ImArchimedes/WilsonThrust510/Documentation/Other Helpful Docs/Doc Images/Print Orientation Thumbs/Box Bottom_Box Bottom.jpg

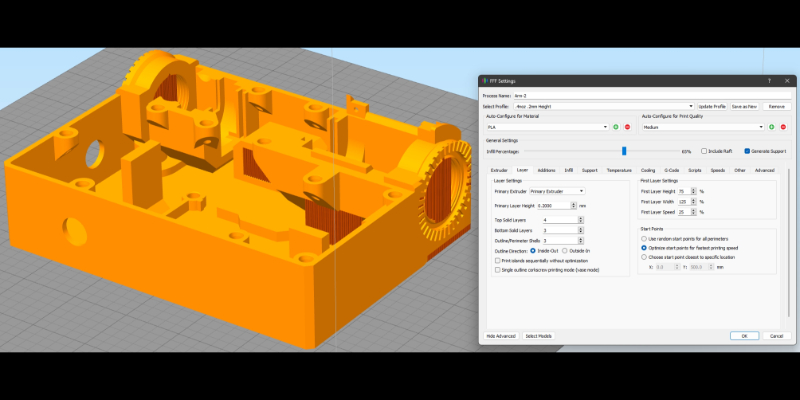
Documentation/Other Helpful Docs/Doc Images/Print Orientation Thumbs/Box Bottom_Box Bottom.jpg
