ImArchimedes/WilsonThrust510/Renders/144.35 Back.jpg

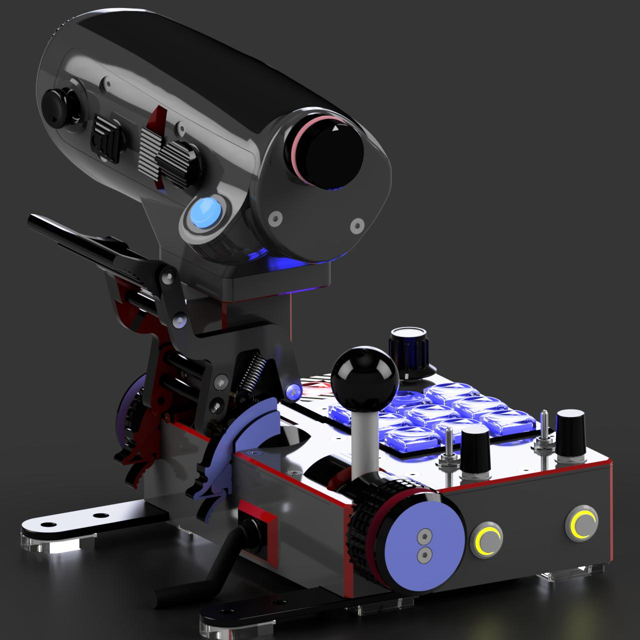
Renders/144.35 Back.jpg
