ImArchimedes/WilsonThrust510/README.md

# WilsonThrust510
DIY PC Flight Simulator Throttle.
