ImArchimedes/WilsonThrust510/Documentation/PCB Documentation/RKJXT1 Reddit Post.docx

# RKJXT1 - center click isolation fix

(continued)

Solution 2:

First off, before you look at my boards in Eagle, know that I went very small for both the RKJXT1 and RKJXM1 boards. My build required it but you do NOT need to go this small. To give you an idea of how small my RKJXT1 pcb with switch is, here are some renders with a quarter for scale…

RKJXT1 Top Side

RKJXT1 Underside

If you are okay with breaking out the poor man's reflow bed (your steam iron), go for it. If you're not okay with that, you can replace the tiny components with equivalent parts with a larger footprint and just spread everything out.

Both the RKJXT1 and RKJXM1 pcbs require the same parts Here is a list of the components need to make my exact PCB along with a link to where I purchased them and a count of how many are needed.

Parts list:
