ImArchimedes/WilsonThrust510/Documentation/Old Docs/BOM Old/Specifications Scratch Pad -2.xlsx

Sheet: Digikey
Category | Integrated Circuits (ICs) (https://www.digikey.com/en/products/category/integrated-circuits-ics/32) | Category: Integrated Circuits (ICs)
 | Logic - Shift Registers (https://www.digikey.com/en/products/filter/logic-shift-registers/712) | : Logic - Shift Registers
Mfr | Texas Instruments | Mfr: Texas Instruments
Series | 74HC (https://www.digikey.com/en/products/result) | Series: 74HC
Package | Tape & Reel (TR) | Package: Tape & Reel (TR)
 | Cut Tape (CT) | : Cut Tape (CT)
 | Digi-Reel® | : Digi-Reel®
Product Status | Active | Product Status: Active
Logic Type | Shift Register | Logic Type: Shift Register
Output Type | Complementary | Output Type: Complementary
Number of Elements | 1 | Number of Elements: 1
Number of Bits per Element | 8 | Number of Bits per Element: 8
Function | Parallel or Serial to Serial | Function: Parallel or Serial to Serial
Voltage - Supply | 2V ~ 6V | Voltage - Supply: 2V ~ 6V
Operating Temperature | -40°C ~ 125°C | Operating Temperature: -40°C ~ 125°C
Mounting Type | Surface Mount | Mounting Type: Surface Mount
Package / Case | 16-TSSOP (0.173", 4.40mm Width) | Package / Case: 16-TSSOP (0.173", 4.40mm Width)
Supplier Device Package | 16-TSSOP | Supplier Device Package: 16-TSSOP
Base Product Number | 74HC165 (https://www.digikey.com/en/products/base-product/texas-instruments/296/74HC165/16) | Base Product Number: 74HC165
Product Type: | FFC & FPC Connectors | Product Type:: FFC & FPC Connectors
Subcategory: | FFC & FPC Connectors | Subcategory:: FFC & FPC Connectors
Actuator Color | Black | Actuator Color: Black
Mating Cycles | 20 | Mating Cycles: 20
Base Product Number | FFC2A32 (https://www.digikey.com/en/products/base-product/gct/2073/FFC2A32/566035) | Base Product Number: FFC2A32

Sheet: Mouser
Manufacturer: | Molex | Manufacturer: Molex
Product Category: | FFC / FPC Jumper Cables | Product Category: FFC / FPC Jumper Cables
RoHS: | Details (https://www.mouser.com/Search/RoHSCompliant?qs=jvSarbJQcKuB88Iw%252B3zClA%3d%3d) | RoHS: Details
Number of Conductors: | 40 Conductor | Number of Conductors: 40 Conductor
Pitch: | 0.5 mm | Pitch: 0.5 mm
Cable Length: | 203 mm | Cable Length: 203 mm
Contact Location: | Same Side Contacts | Contact Location: Same Side Contacts
Current Rating: | 500 mA | Current Rating: 500 mA
Voltage Rating: | 600 VAC | Voltage Rating: 600 VAC
Series: | 15366 (https://www.mouser.com/c/wire-cable/ffc-fpc-jumper-cables/?m=Molex&series=15366) | Series: 15366
Packaging: | Bulk | Packaging: Bulk
Brand: | Molex | Brand: Molex
Contact Plating: | Tin | Contact Plating: Tin
Maximum Operating Temperature: | + 105 C | Maximum Operating Temperature: + 105 C
Minimum Operating Temperature: | - 40 C | Minimum Operating Temperature: - 40 C
Product Type: | FFC / FPC Jumper Cables | Product Type: FFC / FPC Jumper Cables
Factory Pack Quantity: | 20 | Factory Pack Quantity: 20
Subcategory: | Cable | Subcategory: Cable
Tradename: | Premo-Flex (https://www.mouser.com/c/wire-cable/ffc-fpc-jumper-cables/?m=Molex&tradename=Premo-Flex) | Tradename: Premo-Flex
Part # Aliases: | 153660439 0153660439 | Part # Aliases: 153660439 0153660439
Subcategory: | FFC & FPC Connectors | Subcategory: FFC & FPC Connectors
Actuator Color | Black | Actuator Color Black
Mating Cycles | 20 | Mating Cycles: 20
Base Product Number | FFC2A32 (https://www.digikey.com/en/products/base-product/gct/2073/FFC2A32/566035) | Base Product Number: FFC2A32

Sheet: McMaster
Thread |  | Thread:
Size | M5 | Size: M5
 |  | :
Pitch | 0.8 mm | Pitch: 0.8 mm
Type | Metric | Type: Metric
 |  | :
Spacing | Coarse | Spacing: Coarse
 |  | :
Fit | Class 6H | Fit: Class 6H
Direction | Right Hand | Direction: Right Hand
 |  | :
Width | 8 mm | Width: 8 mm
Height | 5 mm | Height: 5 mm
Insert Maximum Temperature | 220° F | Insert Maximum Temperature: 220° F
Specifications Met | DIN 985, ISO 10511 | Specifications Met: DIN 985, ISO 10511
Drive Style | External Hex | Drive Style: External Hex
 |  | :
Nut Type | Locknut, Hex | Nut Type: Locknut, Hex
Hex Nut Profile | Standard | Hex Nut Profile: Standard
Locking Type | Nylon Insert | Locking Type: Nylon Insert
System of Measurement | Metric | System of Measurement: Metric
 |  | :
 |  | :
 |  | :
 |  | :
 |  | :
 |  | :
 |  | :
 |  | :
 |  | :
 |  | :
 |  | :
 |  | :
 |  | :
 |  | :
 |  | :
 |  | :
