ImArchimedes/WilsonThrust510/Renders/144.35 Front.jpg

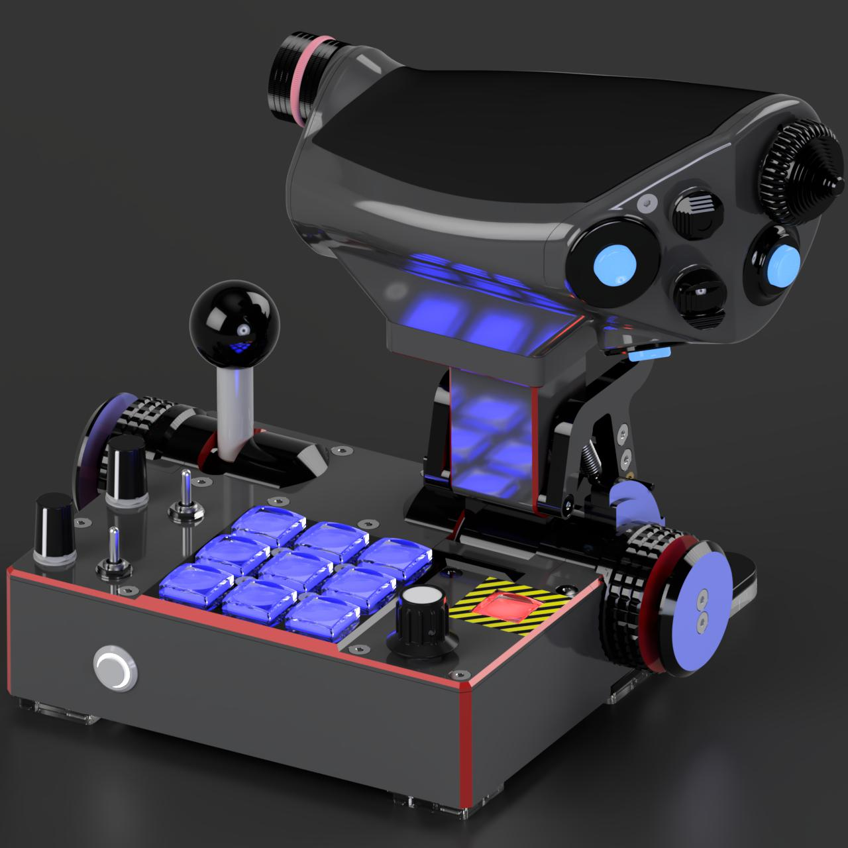
Renders/144.35 Front.jpg
