ImArchimedes/WilsonThrust510/Renders/Back V121.jpg

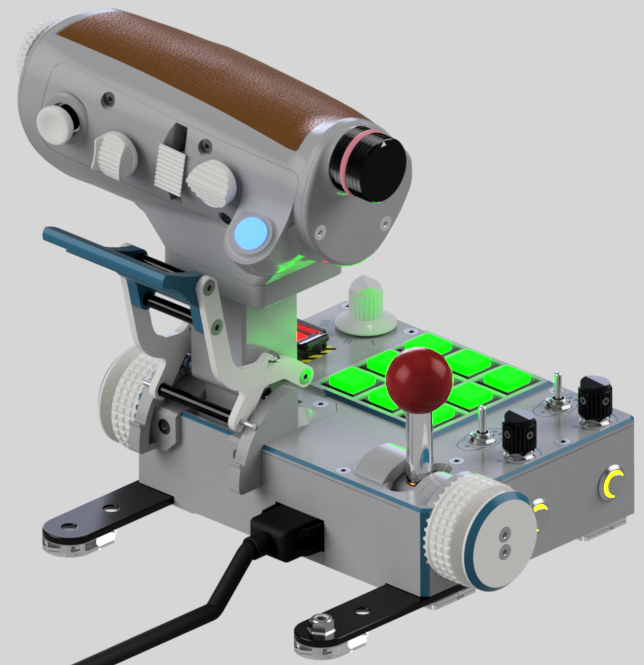
Renders/Back V121.jpg
