ImArchimedes/WilsonThrust510/Renders/Front v121.jpg

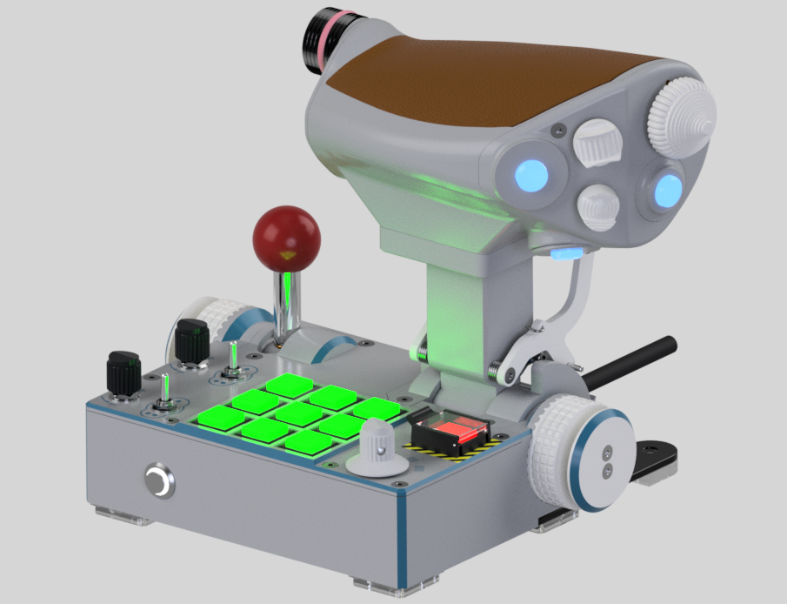
Renders/Front v121.jpg
