ImArchimedes/WilsonThrust510/Renders/Hat Boards for Scale - Bottom.PNG

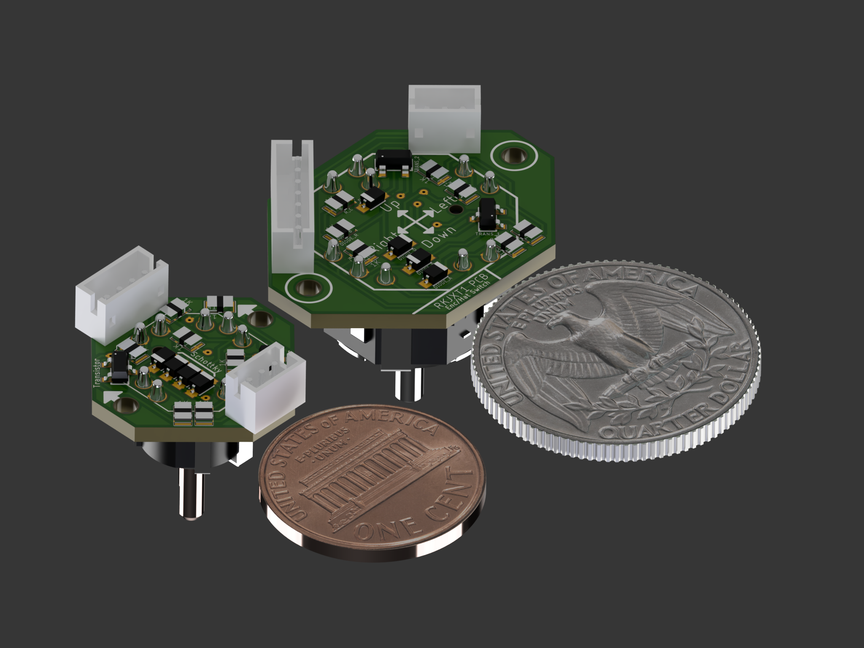
Renders/Hat Boards for Scale - Bottom.PNG
