ImArchimedes/WilsonThrust510/Renders/Hat Boards for Scale - Top.PNG

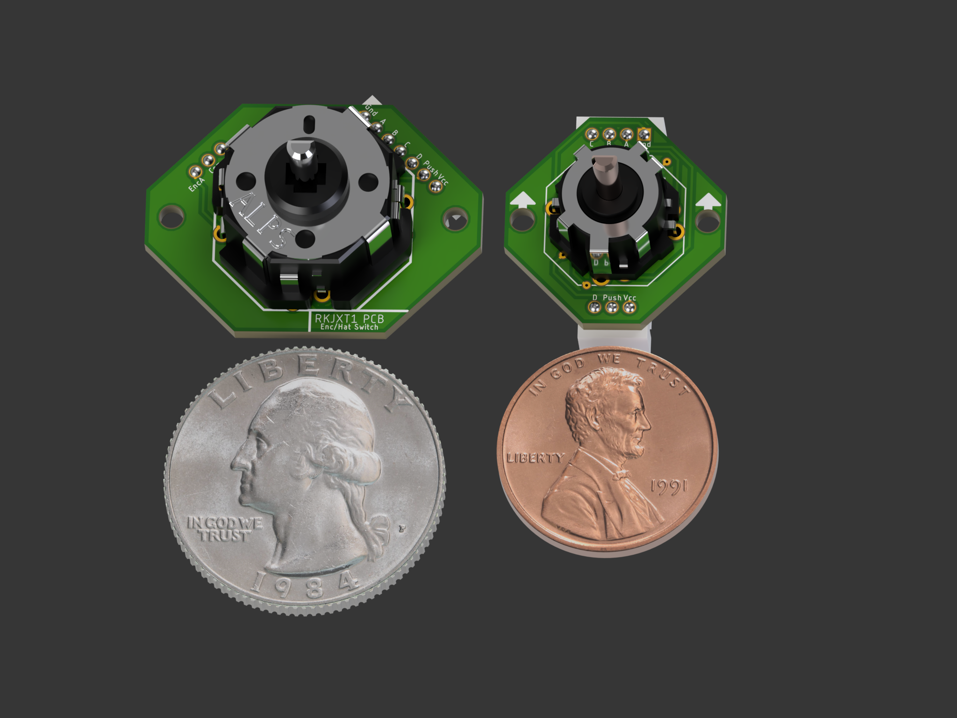
Renders/Hat Boards for Scale - Top.PNG
