ImArchimedes/WilsonThrust510/Renders/LED Grip with Scale - Back.PNG

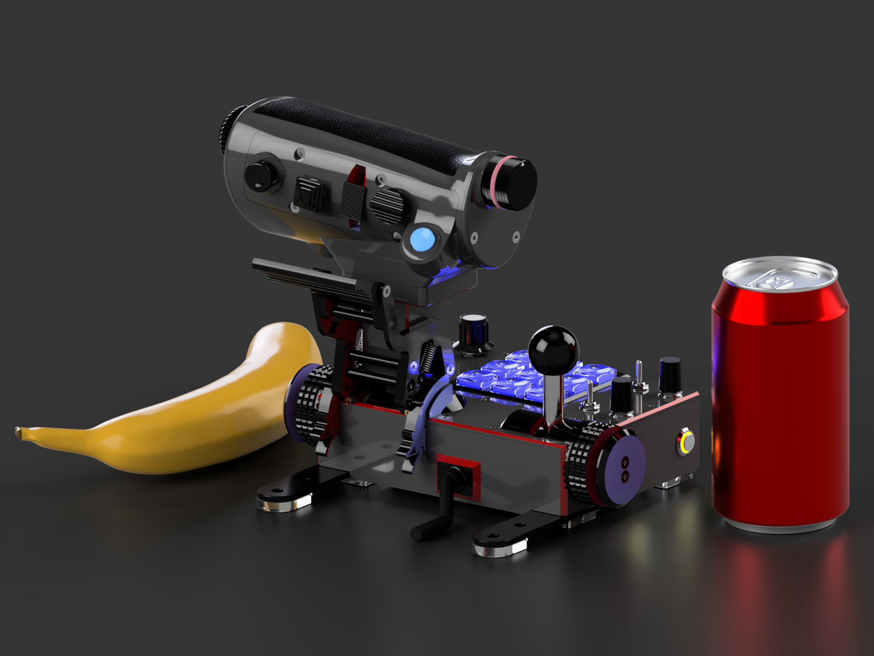
Renders/LED Grip with Scale - Back.PNG
