ImArchimedes/WilsonThrust510/Renders/LED Grip with Scale - Front.PNG

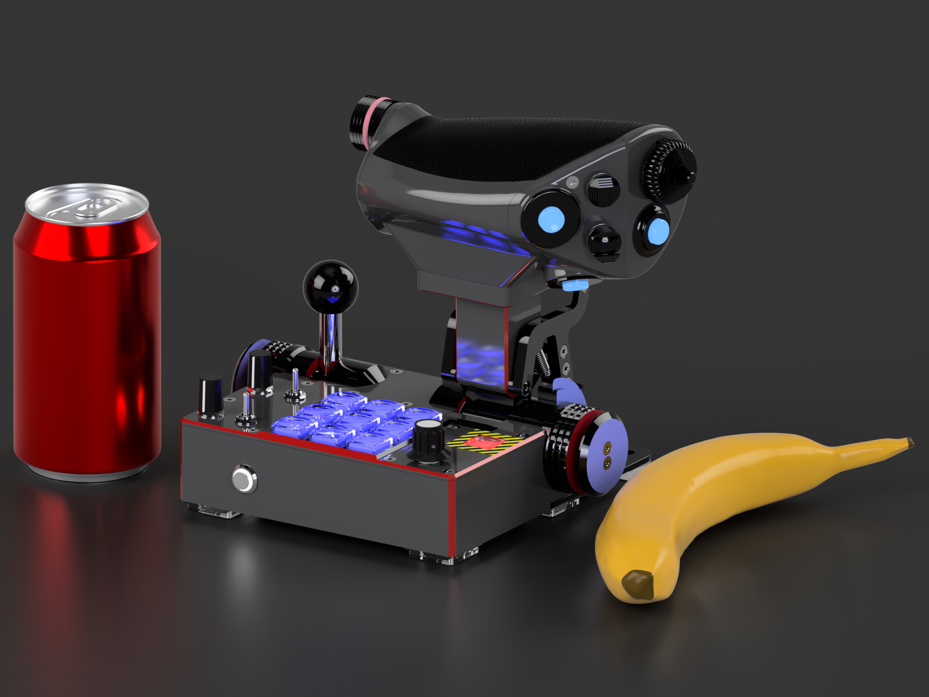
Renders/LED Grip with Scale - Front.PNG
