ImArchimedes/WilsonThrust510/Renders/RKJXT1 Board Back.PNG

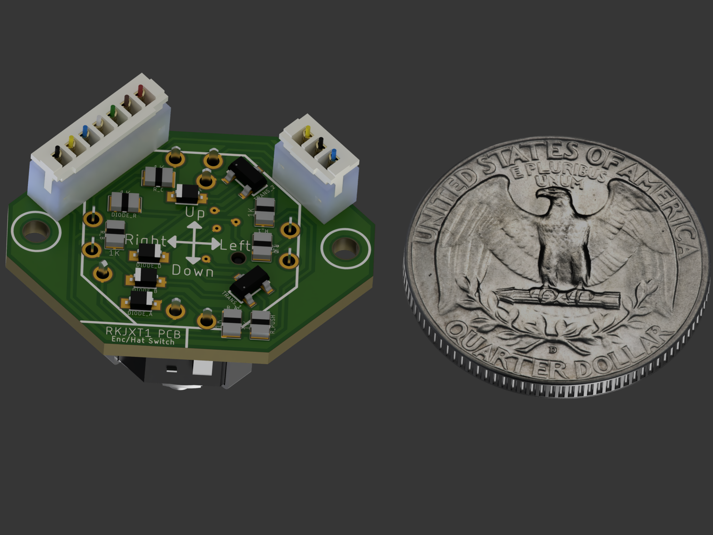
Renders/RKJXT1 Board Back.PNG
