ImArchimedes/WilsonThrust510/Renders/RKJXT1 Board Top.PNG

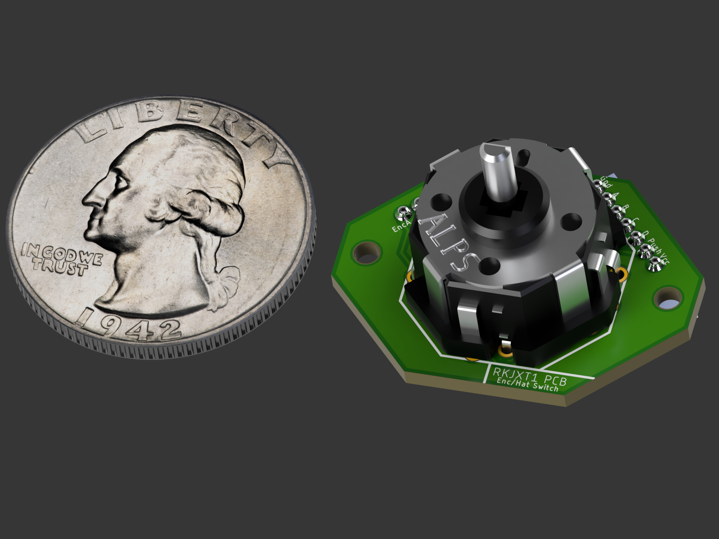
Renders/RKJXT1 Board Top.PNG
