ImArchimedes/WilsonThrust510/Renders/Rotated and Springs Back.png

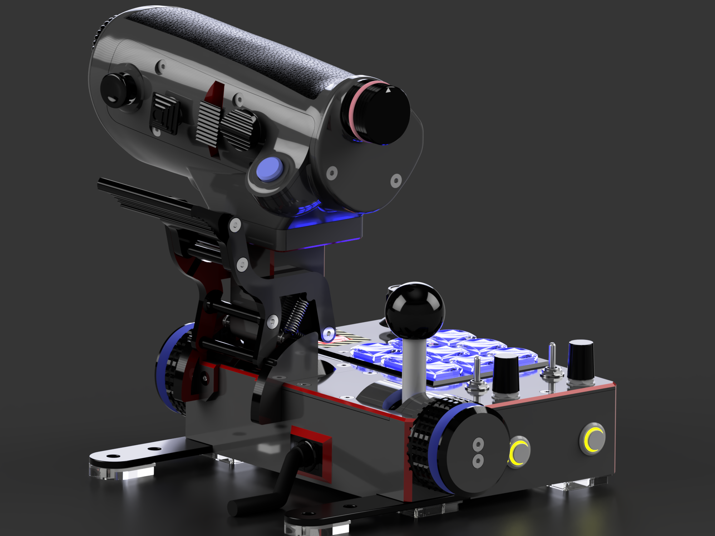
Renders/Rotated and Springs Back.png
