ImArchimedes/WilsonThrust510/Renders/Rotated and Springs Front.png

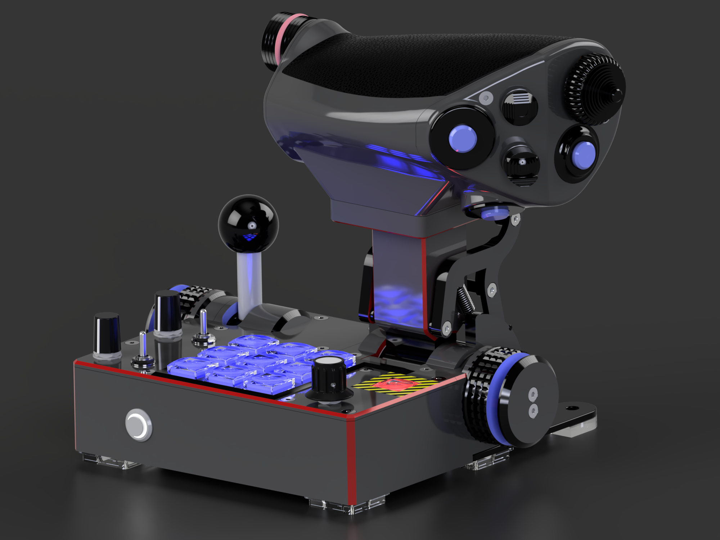
Renders/Rotated and Springs Front.png
