ImArchimedes/WilsonThrust510/Renders/Variants for Scale - Back.PNG

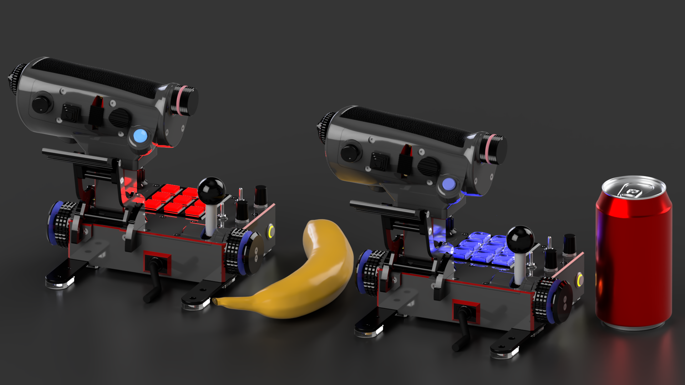
Renders/Variants for Scale - Back.PNG
