ImArchimedes/WilsonThrust510/Renders/Variants for Scale - Front.PNG

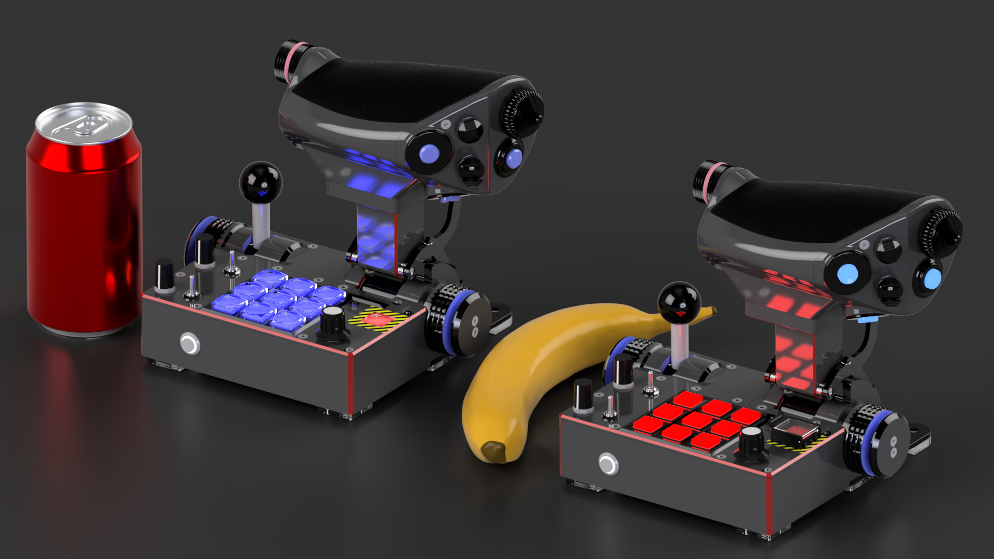
Renders/Variants for Scale - Front.PNG
