ImArchimedes/WilsonThrust510/Renders/Wilson Thrust with Grip LEDs Thumbnail.png

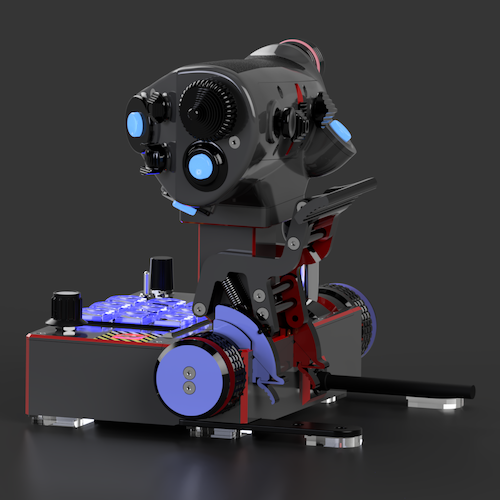
Renders/Wilson Thrust with Grip LEDs Thumbnail.png
