ImArchimedes/WilsonThrust510/Documentation/BOMs/Wilson Thrust BOM v4 with Grip LEDs.xlsx

Sheet: Large PCB Parts
Units/Lots to Buy | Units Used | Part no. / Amazon ASIN | Specifications | Specifications 2 | Usage Description | Example Seller and Link | Cost Per Unit / Lot | Additional Comments/Notes | Additional Comments/Notes 2
SMD Resistors
1 | 56 | B07QGP6H7F | Category: Chip Resistor - Surface Mounted Resistance: 10 kOhms Subcat: Resistors Tolerance: ±1% Power (Watts): 0.25W, 1/4W Composition: Thick Film Features: Automotive AEC-Q200 Temperature Coefficient: ±100ppm/°C Operating Temperature: -55°C ~ 155°C | Package / Case: 1206 (3216 Metric) Supplier Device Package: 1206 Ratings: AEC-Q200 L x W (in): 0.126 x 0.063 L x W (mm): 3.20 x 1.60 Seated Height (in): 0.028 Seated Height (mm): 0.70 Lot: 100 pcs | Resistor used for all Shift Register inputs on Main Board | Amazon (https://a.co/d/2GGAEHD) | $6.99
12 | 12 | RC0805FR-07365RL | Category: Chip Resistor - Surface Mounted Resistance: 365 Ohms Subcat: Resistors Mfr: YAGEO Series: RC_L Package: Tape & Reel (TR)/Cut Tape (CT)/ Digi-Reel® Product Status: ActiveTolerance: ±1% Power (Watts): 0.125W, 1/8W Composition: Thick Film Features: Moisture Resistant | Temperature Coefficient: ±100ppm/°C Operating Temperature: -55°C ~ 155°C Package / Case: 0805 (2012 Metric) Supplier Device Package: 805 L x W (in): 0.079 x 0.049 L x W (mm): 2 x 1.25 Seated Height (in): 0.024 Seated Height (mm): 0.60 Number of Terminations: 2 | Resistor used for LEDs on Main Board | Digikey (https://www.digikey.com/short/jrt9ctrh) | $0.04 | Buying all 12 at once will get you the cheaper cost of 4 cents per unit.
SMD Capacitors
2 | 2 | VJ0603Y104KXAAC | Category: Surface Mounted Ceramic Capacitor Capacitance: 0.1 µF Cat2: Capacitors Mfr: Vishay Vitramon Series: VJ Tolerance: ±10% Voltage - Rated: 50V Temperature Coefficient: X7R | Operating Temperature: -55°C ~ 150°C Applications: General Purpose Mounting Type: Surface Mount, MLCC Package / Case: 0603 (1608 Metric) Size / Dimension: 0.063" L x 0.031" W (1.60mm x 0.80mm) Thickness (Max): 0.038" (0.97mm) Base Product Number: VJ0603 | Capacitor used for both Main and Mini Throttle sensors. | Digikey (https://www.digikey.com/short/5bpnhbwp) | $0.35
SMD Shift Registers
7 | 7 | SN74HC165QPWREP | Category: Surface Mounted Shift Registers Subcat: Integrated Circuits (ICs) Mfr: Texas Instruments Series: 74HC Product Status: Active Logic Type: Shift Register Output Type: Complementary Number of Elements: 1 | Number of Bits per Element: 8 Function: Parallel or Serial to Serial Voltage - Supply: 2V ~ 6V Operating Temperature: -40°C ~ 125°C Mounting Type: Surface Mount Package / Case: 16-TSSOP (0.173", 4.40mm Width) Supplier Device Package: 16-TSSOP Base Product Number: 74HC165 | Shift Registers for connecting groups of 8 inputs to controller. | Digikey (https://www.digikey.com/short/h84zqd8n) | $2.30
Controller
1 | 1 | B00NC43256 | Category: Micro Controller Series: Teensy 2.0 Category: Development Board Brand: PJRC | Features: 8-Bit AVR Processor 16 MHz (ATMEGA32U4) 31.5K Flash Memory, 2.5K RAM, 1K EEPROM USB Can Emulate Any Type of Device Single Pushbutton Programming Arduino Compatible | Controller or "brain" of your throttle. | Amazon (https://a.co/d/1UkxwFO) | $18.53
JST ZH Parts
1 | 1 | ZHR-2, SZH-002T-P0.5, B2B-ZR(LF)(SN) | Category: JST ZH Connection Wire and Socket Connector Type: JST Wire Length (min.): 150mm Profile (size): ZH, 1.5mm Pitch Connector Pin Count: 2-Pin Lot: 5 pcs |  | 2-pin Pre-crimped wires and matching connection housings for wiring the following inputs to your Bridge Board and Main Controller Board: Palm Button | Ebay (https://www.ebay.com/itm/363722154785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) | $1.65 | Only 1 needed in this lot of five. | You can always crimp your own cable by buying all the parts yourself but it's not easy to crimp these if you haven't crimped such small connectors. The choice is yours.
1 | 25 | ZHR-3, SZH-002T-P0.5, B3B-ZR(LF)(SN) | Category: JST ZH Connection Wire and Socket Connector Type: JST Wire Length (min.): 150mm Profile (size): ZH, 1.5mm Pitch Connector Pin Count: 3-Pin Lot: 50 pcs |  | 3-pin Pre-crimped wires and matching connection housings for wiring the following inputs to your Bridge Board and Main Controller Board: Grid Buttons (9x) Panic Button Encoders (3x) Pinky Potentiometers Illuminated Grip Buttons (4x) Slider 2-way Toggle Switches (2x) Side Mute Buttons (2x) Main and Side Throttle Sensors (2x) | Ebay (https://www.ebay.com/itm/231425677399?epid=1860646789&hash=item35e20b9857:g:oiMAAOSwj0NUkuM9) | $4.69 | Only 25 needed out of the lot of 50.
1 | 1 | ZHR-4, SZH-002T-P0.5, B3B-ZR(LF)(SN) | Category: JST ZH Connection Wire and Socket Connector Type: JST Wire Length (min.): 150mm Profile (size): ZH, 1.5mm Pitch Connector Pin Count: 4-Pin Lot: 5 pcs |  | 4-pin Pre-crimped wires and matching connection housings for wiring the following inputs to your Bridge Board and Main Controller Board: LED Toggle Switch | Ebay (https://www.ebay.com/itm/363722154785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) | $2.05 | Only one needed out of the lot of five.
1 | 2 | ZHR-5, SZH-002T-P0.5, B5B-ZR(LF)(SN) | Category: JST ZH Connection Wire and Socket Connector Type: JST Wire Length (min.): 150mm Profile (size): ZH, 1.5mm Pitch Connector Pin Count: 5-Pin Lot: 5 pcs |  | 5-pin pre-crimped wires and matching connection housings for wiring the following inputs to your Bridge Board and Main Controller Board: Rotary Selector Switch 3-way Hat | Ebay (https://www.ebay.com/itm/363722154785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) | $1.96 | Only two needed in this lot of five.
1 | 4 | ZHR-7, SZH-002T-P0.5, B7B-ZR(LF)(SN) | Category: JST ZH Connection Wire and Socket Connector Type: JST Wire Length (min.): 150mm Profile (size): ZH, 1.5mm Pitch Connector Pin Count: 7-Pin Lot: 10 pcs |  | 7-pin pre-crimped wires and matching connection housings for wiring the following inputs to your Bridge Board and Main Controller Board: Thumb Hat/Encoder Thumb Hat 1 Thumb Hat 2 Middle Finger Hat | Ebay (https://www.ebay.com/itm/171361716328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) | $6.64 | Only four needed in this lot of 10.
1 | 1 | 4189304386 | Category: JST ZH Connection Wire and Socket Connector Type: JST Wire Length (min.): 100mm Profile (size): ZH, 1.5mm Pitch Connector Pin Count: 8-Pin Lot: 10 pcs |  | 8-pin pre-crimped wires and matching connection housings for wiring the following inputs to your Grip Satellite PCB: Joystick | Ebay (https://www.ebay.com/itm/295433050813) | $8.99 | Only one needed in this lot of 10.
Ribbon Cable Parts
1 | 1 | 4-1734839-0 | Category: FFC & FPC Connector Number of Positions: 40 Position Mounting Angle: Right Angle - 1 Sided Subcat: FFC, FPC (Flat Flexible) Connectors Manufacturer: TE Connectivity Product: Board Mount Pitch: 0.5 mm Termination Style: SMD/SMTContact Location: Top Contact | Contact Plating: Gold Current Rating: 500 mA Series: FPC Minimum Operating Temperature: - 40 C Maximum Operating Temperature: + 85 C Contact Material: Phosphor Bronze Gender: Female Housing Color: Natural Housing Material: Thermoplastic (TP) | 40 pin ribbon cable connector used on Main Controller Board to connect it to the Bridge Board in the throttle grip. | Mouser (https://www.mouser.com/ProductDetail/571-4-1734839-0) | $1.12
1 | 1 | FFC2A32-40-T | Category: FFC & FPC Connector Number of Positions: 40 Position Mounting Angle: Vertical - 1 Sided Subcat: FFC, FPC (Flat Flexible) Connectors Mfr: GCT Series: FFC2A32 Flat Flex Type: FFC, FPC Mounting Type: Surface Mount Pitch: 0.020" (0.50mm) Termination: Solder FFC, FCB Thickness: 0.30mm Height Above Board: 0.167" (4.25mm) Locking Feature: Slide Lock Cable End Type: Tapered | Contact Material: Phosphor Bronze Contact Finish: Tin Housing Material: Liquid Crystal Polymer (LCP) Actuator Material: Liquid Crystal Polymer (LCP) Features: Solder Retention, Zero Insertion Force (ZIF) Voltage Rating: 30V Operating Temp.: -25°C ~ 85°C Material Flammability Rating: UL94 V-0 Current Rating (Amps): 0.2A Housing Color: Natural Actuator Color: Black Mating Cycles: 20 Base Product Number: FFC2A32 | 40 pin ribbon cable connector used on Bridge Board in the throttle grip to connect it to the Main Controller Board. | Digikey (https://www.digikey.com/short/tv53nt4w) | $1.00

Sheet: Small PCB Parts
Units/Lots to Buy | Units Used | Part no. / Amazon ASIN | Specifications | Specifications 2 | Usage Description | Example Seller and Link | Cost Per Unit / Lot | Additional Comments/Notes
20 | 20 | CUS05S40,H3F | Category: Schottky Diode Subcategory: Diodes - Rectifiers - Single Mfr: Toshiba Semiconductor and Storage Diode Type: Schottky Voltage - DC Reverse (Vr) (Max): 40 V Current - Average Rectified (Io): 500mA Voltage - Forward (Vf) (Max) @ If: 350 mV @ 100 mA Speed: Fast Recovery =< 500ns, > 200mA (Io) | Current - Reverse Leakage @ Vr: 30 µA @ 10 V Capacitance @ Vr, F: 42pF @ 0V, 1MHz Mounting Type: Surface Mount L x W x H: 1.7 x 1.25 x .9 mm Package / Case: SC-76, SOD-323 Supplier Device Package: USC Operating Temperature - Junction: 125°C (Max) Base Product Number: CUS05S40 | Schottky diode needed for the circuit on PCBs for the following switches (4 each): 5-way Hats (Alps RKJXM1) 3-way Hat (Alps RKJXM1) 5-way Hat/Encoder Combo (Alps RKJXT1) | Digikey (https://www.digikey.com/short/vt2j2q03) | $0.28 | Buying all 20 at once will get you the cheaper cost of 28.4 cents per unit.
35 | 35 | RNCP0805FTD1K00 | Category: Chip Resistor - Surface Mount Resistance: 1 kOmh Subcat: Resistors Mfr: Stackpole Electronics Inc Tolerance: ±1% Series: RNCP Power (Watts): 0.25W, 1/4W Composition: Thin Film | Features: Anti-Sulfur Temperature Coefficient: ±100ppm/°C Package / Case: 0805 (2012 Metric) Supplier Device Package: 805 Size / Dimension: 0.079" L x 0.049" W (2.00mm x 1.25mm) Height - Seated (Max): 0.025" (0.65mm) Number of Terminations: 2 Operating Temperature: -55°C ~ 155°C | 1k resistor needed for the circuits on PCBs for the following switches (7 each): 5-way Hats (Alps RKJXM1) 3-way Hat (Alps RKJXM1) 5-way Hat/Encoder Combo (Alps RKJXT1) | Digikey (https://www.digikey.com/short/nfpwfhvr) | $0.07 | Buying all 35 at once will get you the cheaper cost of 7.3 cents per unit.
10 | 10 | MMBT3904-TP | Category: Surface Mounted Transistor NPN Subcat: Transistors - Bipolar (BJT) - Single Mfr: Micro Commercial Co Transistor Type: NPN Current - Collector (Ic) (Max): 200 mA Voltage - Collector Emitter Breakdown (Max): 40 V Vce Saturation (Max) @ Ib, Ic: 300mV @ 5mA, 50mA Current - Collector Cutoff (Max): 50nA (ICBO) | Power - Max: 350 mW Frequency - Transition: 300MHz Operating Temperature: -55°C ~ 150°C (TJ) Mounting Type: Surface Mount L x W x H: 2.8 x 1.20 x .9 mm Package / Case: TO-236-3, SC-59, SOT-23-3 Supplier Device Package: SOT-23 DC Current Gain (hFE) (Min) @ Ic, Vce: 100 @ 10mA, 1V | Transistor needed for the circuits on PCBs for the following switches (2 each): 5-way Hats (Alps RKJXM1) 3-way Hat (Alps RKJXM1) 5-way Hat/Encoder Combo (Alps RKJXT1) | Digikey (https://www.digikey.com/short/w3p4cctn) | $0.12 | Buying all 10 at once will get you the cheaper cost of 12.5 cents per unit.

Sheet: Input Hardware
Units/Lots to Buy | Units Used | Part no. / Amazon ASIN | Specifications | Specifications 2 | Specifications 3 | Usage Description | Example Seller and Link | Cost Per Unit / Lot | Additional Comments/Notes
Potentiometers
1 | 2 | B094F8H591 | Category: AS5600 Board Brand: UMLIFE Board Size: Approx. 23mm x 23mm Resolution: 12bit Lot: 3 pcs | Included items: Sensor Boards Radial Magnets Header Pins |  | Used for the following inputs: Main Throttle Arm Mini Side Throttle Arm | Amazon (https://a.co/d/etaRa7J) | $13.69 | A lot of notes on this item. First, you can't use a standard magnet with these sensors. Standard round flat magnets have their poles on the flat sides of the magnet. The magnets included with these sensors are "radial magnets". That means that each flat side has both north and south poles on them, split down the middle. This sensor will only work with the included magnet or another radial magnet of the same dimensions and strength. Second, I found it cheapest to buy 5x packs of these boards since I'm making four of these throttles requiring eight of these sensor boards, total. You can buy them in smaller packs or individually. You just make sure that the ones you get match the dimensions of the boards I linked to. They list the board as being 23mmx23mm but I measured them as 22.7mmx23.2mm. Example of similar item being sold in a two pack that I believe should be the same design but I can't confirm as I didn't purchase this one: https://a.co/d/6JahtUr
1 | 1 | PTD901-2015K-B503 | Category: Rotary Pot Subcat: Pots, Var. Resistors Mfr: Bourns Inc. Series: Pro Audio PTD90 Resistance (Ohms): 50k Tolerance: ±20% Power (Watts): 0.05W, 1/20W Built in Switch: None Number of Turns: 1 | Taper: Linear Number of Gangs: 1 Adjustment Type: Side Adjustment Rotation: 300° Resistive Material: Carbon Term. Style: PC Pins, Board Locks Actuator Type: Knurled and Slotted Actuator Length: 0.591" (15.00mm) | Actuator Diameter: 0.236" (6.00mm) Bushing Thread: M7 x 0.75 Mounting Type: Panel Mount Body Shape: Rectangular Body Size: 0.445" x 0.374" Size - Face: (11.30mm x 9.50mm) Base Product Number: PTD901 | Used for the following inputs: Grip End Pinky Knob | Digikey (https://www.digikey.com/short/v97frcfp) | $2.18
1 | 1 | PTA1543-2215CIB503 | Category: Slide Potentiometer Manufacturer: Bourns Series: PTA Mounting Style: PCB Mount Termination Style: PC Pin Type: Low Pro Slide Pot Travel: 15 mm | Resistance: 50 kOhms Power Rating: 50 mW (1/20 W) Tolerance: 0.2 Taper: Linear Length: 30 mm Width: 9 mm Height: 6.5 mm | Brand: Bourns Element Type: Carbon Life: 15000 Cycles Product: Slide Pots/Faders Subcat: Pots, Trimmers & Rheostats Tradename: Pro Audio | Used for the following inputs: Ring Finger Slider | Mouser (https://www.mouser.com/ProductDetail/Bourns/PTA1543-2215CIB503?qs=9fn1gpisni7MYk8V%252BVGo3w%3D%3D) | $1.68
Hat Switches
4 | 4 | RKJXM1015004 | Category: Multi-Dir. Switch Manufacturer: Alps Alpine Illuminated: Non-Illuminated Control Type: Multi-Dir. Current Rating: 10 mA | Operating Force: 25 +/- 20 mN-m Term. Style: Through Hole Height: 15 mm Life: 100000 Cycle Max Operating Temp: + 85 C | Min Operating Temp: - 40 C Mounting Style: PCB Mount Series: RKJXM Voltage Rating DC: 5 VDC Part # Aliases: RKJXM1015001 | Used for the following inputs: 5-way Hats (up, down, left, right, center) 3-way Hat (up, down, center) | Mouser (https://www.mouser.com/ProductDetail/Alps-Alpine/RKJXM1015004?qs=w%2Fv1CP2dgqqXHSoAYYJYDQ%3D%3D) | $9.57
1 | 1 | RKJXT1F42001 | Category: Multi-Dir. Switch/Encoder Manufacturer: Alps Alpine | Control Type: Stick Switch Operating Force: 40 mN +/- 25 mN | Term. Style: Through Hole Series: RKJXT | Used for the following input: 5-way Hat / Encoder Combo(up, down, left, right, center, EncA, EncB) | Mouser (https://www.mouser.com/ProductDetail/Alps-Alpine/RKJXT1F42001?qs=6EGMNY9ZYDTsBzSTrhiL0w%3D%3D) | $7.89
Analog Directional Switches
1 | 1 | THB001P | Category: Analog Joystick Mfr: C&K Series: THB Type: Joystick, 2 - Axis Actuator Type: Joystick Function: 360° Directional | Func2: Center Select Output: Analog (Resistive) Voltage Rating - AC: 50 V Voltage Rating - DC: 5 V Resistance: 10 kOhms Mounting Type: Through Hole | Termination Style: PC Pin Operating Temp: -10°C ~ 70°C Features: Center Tap Electrical Life: 1,000,000 Cycles Operating Force: 160gf | Used for the following inputs: Pointer Finger Analog Stick | Digikey (https://www.digikey.com/short/q5hvfdnj) | $2.18
Toggle Switches
2 | 2 | 100SP4T1B1M1QEH | Category: Toggle Switch Switch Function: (ON) - OFF - (ON) Manufacturer: E-Switch Illuminated: Non-Illuminated Contact Form: SPDT Mounting Style: Panel Mount Termination Style: Solder Lug | Voltage Rating AC: 125 VAC Bushing Size: 14614 Actuator: Bat Terminal Seal: Sealed Contact Plating: Silver Contact Material: Silver | Housing Material: Stainless Steel Life: 40000 Cycles Max Operating Temp.: + 85 C Min Operating Temp.: - 30 C Mounting Type: Bushing Series: 100 | Used for the following input: 2-way Toggle 1 2-way Toggle 2 | Mouser (https://www.mouser.com/ProductDetail/E-Switch/100SP4T1B1M1QEH?qs=rR7wk9eDIwrfr7WM%2FJybsQ%3D%3D) | $4.18
Push Buttons
9 | 9 | TS26-2-TW-U-S | Category: Pushbutton Switches Switch Function: On-Mom Manufacturer: Honyone Series: TS26 Type: Sealed Illuminated: Illuminated Circuit: SPST 1p1T with LED Mounting Style: PC Pins | Lamp Type: LED Illumination Color: Blue Actuator: Square Current Rating: 50mA Voltage Rating: 12VDC Term. Style: Pins Cap Color: Clear Cap Dimensions: 15 x 15 mm | Solder Specifications: 260C for 3 sec. Operating Force: 250±50gf Total Travel: 0.4±0.15mm | Used for the following input: Illuminated 3x3 Push Button Grid | AliExpress (https://www.aliexpress.us/item/2251832851587560.html) | $1.05 | Make sure that, if you use the AliExpress link I shared, you select the right size switch and the right colors. You want the 15x15mm buttons.
1 | 1 | TS26-2-TW-R-S | Category: Pushbutton Switches Switch Function: On-Mom Manufacturer: Honyone Series: TS26 Type: Sealed Illuminated: Illuminated Circuit: SPST 1p1T with LED Mounting Style: PC Pins | Lamp Type: LED Illumination Color: Red Actuator: Square Current Rating: 50mA Voltage Rating: 12VDC Term. Style: Pins Cap Color: Clear Cap Dimensions: 15 x 15 mm | Solder Specifications: 260C for 3 sec. Operating Force: 250±50gf Total Travel: 0.4±0.15mm | Used for the following input: Panic Button | AliExpress (https://www.aliexpress.us/item/2251832851587560.html) | $1.05
1 | 5 | Kailh Choc Switch V1 | Category: Keyboard Switch Series: Low Profile Choc v1 Color (type): Your choice | Manufacturer: Kailh Lot: 10 pcs |  | Used for the following inputs: Grip Thumb Button Top Grip Thumb Button Bottom Grip Thumb Button Under Grip Pinky Button Grip Palm Button | MKUltra (https://mkultra.click/choc-switches) | $5.50 | I like the White version which is "Clicky" with an actuating force of 60±10gf but any Chocolate v1 switch will fit my design. If you want, you could get two sample packs from MKUltra. They are $7 a piece so you'd pay more but you would have two of every variety and some keycaps. Then you could pick your favorite type for the Push buttons.
1 | 2 | B08LYWZ33K | Category: Push Button Switch Switch Type: Momentary Manufacturer: APIELE | Size: 12mm Actuator: High Round Head LED Type: Ring | LED Color: Yellow Material: Stainless Steel Lot: 2 pcs | Used for the following input: Audio-In Mute Switch Audio-Out Mute Switch | Amazon (https://a.co/d/41AdSG9) | $10.89
1 | 1 | B08LV5DWLG | Category: Push Button Switch Switch Type: Latching Manufacturer: APIELE | Size: 12mm Actuator: High Round Head LED Type: Ring | LED Color: White Material: Stainless Steel Lot: 2 pcs | Used for the following input: LED Toggle | Amazon (https://a.co/d/7yLz9uV) | $10.89
Selector Switches
1 | 1 | 56DP30-01-2-AJN | Category: Selector Switch Cat2: Rotary Switches Mfr: Grayhill Inc. Series: 56 Number of Positions: 2 ~ 6 Index Stops: Adjustable | Number of Decks: 1 Number of Poles per Deck: 2 Circuit per Deck: DP6T Contact Timing: Non-Shorting (BBM) Current Rating (Amps): 200mA (AC/DC) Voltage Rating - AC: 115 V Voltage Rating - DC: 30 V Actuator Type: Flatted (3.17mm Dia) | Actuator Length: 9.53mm Angle of Throw: 30° Contact Material: Brass Contact Finish: Silver Mounting Type: Panel Mount Mounting Type 2: Through Hole Termination Style: PC Pin Depth Behind Panel: 9.58mm Base Product Number: 56DP30 | Used for the following input: Profile Selector | Digikey (https://www.digikey.com/short/fr5f44n7) | $20.00 | This is another one where you can get a cheaper part. You can just change the cut out size to use a less expensive switch. I went with this one because the first two I tried both didn't feel right and one failed on me just while testing.
Knobs & Dials
1 | 1 | PKA50B1/4 | Category: Knobs & Dials Type: Cylindrical Knob with Skirt Series: PKA Manufacturer: TE Connectivity / P&B Indicator Style: Line on Skirt | Shaft Diameter: 1/4 in Outside Diameter: 21 mm Height: 15 mm | Material: Plastic Design: Ribbed Color: Black, Silver | Used for the following input: Profile Selector | Mouser (https://mou.sr/3OCyKaO) | $2.62
1 | 1 | 2056 (Adafruit) | Category: Knob Mfr: Adafruit Industries LLC Style: Cylindrical Type: Knurled, Diamond Indicator: Arrow on Top | Shaft Size: 0.236" (6.00mm) Diameter: 1.000" (25.40mm) Height: 0.600" (15.24mm) | Material: Metal Color: Black | Used for the following input: Grip End Pinky Knob | Digikey (https://www.digikey.com/short/9z0zh5td) | $3.95
2 | 1 | 1237-H | Category: Knob Mfr: Davies Molding, LLC Series: - Style: Cylindrical Indicator: Line on Side | Type: Serrated Shaft Size: 0.250" (6.35mm) Diameter: 0.450" (11.43mm) Height: 0.580" (14.73mm) | Material: Plastic Color: Black Features: Soft Touch Base Product Number: 1237 | Used for the following input: Audio-In Knob Audio-Out Knob | Digikey (https://www.digikey.com/short/pf5m20rw) | $2.05
1 | 1 | DIN 319-KU-25-M6-E | Category: Arcade Joystick Handle Brand: JW Winco Shape: Sphere | Size: 25 mm Diameter Threading: M6 threaded insert | Color/Finish: Glossy Black Material: Plastic Mat. 2: Duroplast (Phenolic PF) | Used as the grip for the side throttle. | JW Winco (https://www.jwwinco.com/en-us/products/1.1-Operating-with-handles-and-knobs/knobs/DIN-319-Plastic-Ball-Knobs-Tapped-Hole-or-Tapped-Insert-Type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) | $1.32 | Note: Link is long because it's for a specific configuration. I've linked out to the basic option of a plain black plastic knob with a M6 tapped insert that has a diameter of 25mm but I still can't decide what grip I like the most. This site makes great lever grips that work well as arcade stick handles. They range in price and shape but are all of the highest caliber. Although pricey, I really like the brushed metal 25mm knob but the Ergostyle ball handles and domed gear levers feel great too.
Encoders
2 | 2 | PEC11R-4015K-S0024 | Category: Encoder Subcat: Sensors, Transducers Mfr: Bourns Inc. Series: PEC11R Actuator Type: Knurled End Actuator Size: 6mm Diameter | Detent: No Built in Switch: Yes (not needed) Mounting Type: Panel, Mounting2: PCB Through Hole Orientation: Vertical Termination Style: PC Pin | Rotational Life (Cycles Min): 30K Base Product Number: PEC11R Encoder Type: Mechanical Output Type: Quadrature (Incr.) Pulses per Revolution: 24 | Used for the following inputs: Audio Input Level Audio Output Level | Digikey (https://www.digikey.com/short/qrhwzp34) | $2.49 | If you opt to use a different encoder for your build, you don't need one with a push button. This encoder includes one but they're not wired up to this builds control board as I'd need an extra shift register to include them.

Sheet: Other Hardware & Materials
Units/Lots to Buy | Units Used | Part no. / Amazon ASIN | Specifications | Specifications 2 | Specifications 3 | Usage Description | Example Seller and Link | Cost Per Unit / Lot | Additional Comments/Notes | Additional Comments/Notes 2
Magnets
8 | 16 | ND018-8 | Category: Magnet Strength: N52 | Size: 1/8 inch x 1/8 inch. Shape: Cylinder Orientation: Poles on Flat Side | BrMax: 14800 gauss Approx. pull force: 1.7 lbs. per mag | Used to magnitize the following parts: Main Throttle Friction Adjustment Knob Side Mini Throttle Friction Adjustment Knob | Magnet4Less (https://www.magnet4less.com/n52-neodymium-rare-earth-magnets-1-8-in-x-1-8-in-disc) | $0.10 | Only use a different vendor for these magnets if you know their ratings are accurate. Amazon magnet vendors make all sorts of claims regarding magnet strength and very few are accurate. This build requires true N52 magnets for friction adjusters | WARNING: Handle with extreme care. Real N52 magnets even of this small size can be VERY dangerous. They will pinch, bruise, or even rip flesh if you get some between two of these small magnets. Handle with caution. Store far away from metal and leave wrapped in their bubble wrap sleave until you are ready to install them in the throttle.
Leather
1 | x | B00N51TITA | Category: Natural Leather Hide | LxW: 8"x11" Thickness: 0.8" | Color: Dealers Choice | Used on the following parts: Main Grip Covering Main Throttle Friction Adjustment Pad Side Mini Throttle Friction Adjustment Pad | Amazon (https://a.co/d/4WyUTRn) | $8.99 | Use whatever company or color you'd like but make sure it is natural leather with one side raw and no more than 1mm thick.
Slip-Tape
1 | x | B00823JBZW | Category: UHMW Tape Roll | Thickness: 0.005 in. | W x L: 2 in. x 15 ft | Used in collaberation with leather to add smooth friction to throttle arms. | Amazon (https://a.co/d/89GrpMN) | $14.55
Steel Wire
1 | x | 89065K75 | Material: 430 Stainless Steel Series: Bend-and-Stay Shape: Wire Shape Type: Wire Diameter: 0.045" Diam. Tol.: -0.001" to 0.001" | Tol. Rating: Standard Fabrication: Cold Drawn Heat Treatment: Annealed (Softened) Tensile Strength: 70,000 psi Appearance: Matte | Magnetic Properties: Magnetic Elongation: 0.2 Weight: 1/4 lb. Container Type: Coil Length: 46 ft. | Used to hold the following parts in place: Main Throttle Friction Adjustment Knob Side Mini Throttle Friction Adjustment Knob | McMaster-Carr (https://www.mcmaster.com/89065K75/) | $9.97 | If you want to go with another vendor or brand, make sure its one you know you can trust. Before purchasing the linked wire, I tried two other vendors for 430 Stainless Steel wire. This stainless steel mixture should always be ferrous (attracted to magnets). Neither of them were.
Braces
1 | 2 | B01M1RYLRE | Category: Flat Brace Dimensions: 96 x 20 x 3mm | Mounting Holes: 5mm Material: Stainless Steel | Color: Black Oxide Lot: 4 pcs | Used to extend out the back of the Box to prevent tipping when using unmounted on a desk. | Amazon (https://a.co/d/azZ2u93) | $7.99 | Only one is needed if you know you will be mounting the throttle but you still need one if you are mounting using a Thrustmaster TWCS Throttle mount. If using on a desk, two are needed. If you use this link, select the size option: 3-4/5 Inch(10 Pcs) | UPDATE: This link used to offer 4 at this size in black oxide. Now they offer the right size still but in a pack of 10 with no oxide finish : / You might need to hunt around if you want to buy less than 10 and if you want black oxide coating.
Bumpers
1 | 4 | B01G5WX4M2 | Category: Stick On Rubber Bumpers | L x W: 25.4mm x 25.4mm Thickness: 4.6mm | Application: Self Adhesive Lot: 20 pcs | No-Slip rubber feet for desktop usage | Amazon (https://a.co/d/3KZPwg4) | $9.99 | Only needed if not mounting. Otherwise, pick the shape, size, color, and brand you like.
Ball Bearings
1 | 3 | B082PWB7R5 | Category: Ball Bearing Profile: 6804ZZ | OD: 32mm ID: 20mm Width: 7mm | Lot: 10 pcs | Used to smooth rotation of: Main Throttle Side Throttle | Amazon (https://a.co/d/hf7pMMf) | $13.49 | So, you can get the cheaper Uxcell bearings which are 13.45 for 10 (and only use 3) or you can get nicer bearings. It's up to you. Just know there is a difference. Here is a link to the bearings I ended up using from McMaster-Carr: https://www.mcmaster.com/5972K279/ The McMaster-Carr bearings are smoother than any bearing I've gotten from amazon but you pay much more for that quality and precision.
Cables
1 | 1 | B07J4SY7BB | Category: External USB Cable Brand: URWOOW Connection Type: USB A / USB A Connection Gender: Male / Female | Female Conn. Shape: Flush Rectangle Head Angles: Straight/Straight Length: 6 ft. | Material: Flexible Rubber Capability: Charging and Data Data Tx Rate: USB 3.0 | Used to connect PC to internal usb cable which connects to the Main Controller Board. | Amazon (https://a.co/d/3u04QTK) | $8.30
1 | 1 | B07P76SHHM | Category: Internal USB Cable Brand: CERRXIAN Connection Type: USB A, USB Mini Connection Gender: Male to Male | Length: 9 inch Gauge: 9.0 Head Angles: Right Angle/Right Angle Material: Flexible Rubber | Capability: Charging and Data Data Tx Rate: 0.48 Gigabits Per Second Lot: 2 pcs | Used to connect the External USB Cable to the Main Controller Board's Teensy 2.0. | Amazon (https://a.co/d/g1mGPne) | $7.99
1 | 1 | 15366-0439 | Category: FFC / FPC Jumper Cable Number of Conductors: 40 Conductor Manufacturer: Molex Pitch: 0.5 mm Cable Length: 203 mm Contact Location: Same Side Contacts Current Rating: 500 mA | Voltage Rating: 600 VAC Series: 15366 Contact Plating: Tin Max. Operating Temp.: + 105 C Min. Operating Temp.: - 40 C Tradename: Premo-Flex Part # Aliases: 153660439 0153660439 |  | 40 pin ribbon cable that connects the Main Controller Board to the satallite Bridge Board in he throttle grip by running up the main throttle arm. | Mouser (https://www.mouser.com/ProductDetail/538-15366-0439) | $10.97 | Longer will make connecting to the Grip Satellite PCB easier but you'll have to fold excess cable and tuck it into throttle arm slot.
Internally Threaded Rods
1 | 5 | B07MQ5C8L9 | Category: M3 Standoff / Spacer Bar Length: 35 mm Brand: Uxcell | Inner Threading: M3 Outside Diameter: 5 mm Color/Finish: Glossy Black | Material: Aluminum Alloy Lot: 10 pcs | Used to brace the detent pullup system. | Amazon (https://a.co/d/hxi33i9) | $11.99
1 | 1 | B07SPRRYFS | Category: M6 Standoff / Spacer Bar Length: 30 mm Brand: Xiaoyztan | Inner Threading: M6 Outside Diameter: 10 mm Color/Finish: Polished Steel | Material: Stanless Steel Lot: 5 pcs | Used as the arm for side throttle. | Amazon (https://a.co/d/aQND8E7) | $7.99
Externally Threaded Rods
1 | 1 | B07YB5ZVXR | Category: M6 Threaded Rod Length: 40 mm Brand: Smartsails | Outside Threading: M6 (Fully Threaded) Color/Finish: Polished Steel | Material: Stanless Steel Lot: 10 pcs | Used to run through and connect the following: Side Throttle Handle, Arm, and Bearing | Amazon (https://a.co/d/58x2ohd) | $8.99 | Only one needed but could only find at a reasonable price for a pack of 10.
Screw Pins
1 | 2 | B083R5KBRC | Category: M3 Screw Pin Brand: EPTNNASO Outside Threading: M3 Threaded Portion Length: 3mm | Unthreaded Length: 8mm Unthreaded Width: 2.5mm Total Length: 11mm | Color/Finish: Black Semigloss Material: Steel Lot: 10 pcs | Used on the ends of the detent pull up bar to slide along the detent tabs. | Amazon (https://a.co/d/cOQTN9o) | $5.99
Springs
1 | 1 | 3HPG3 | Catagory: Torsion Spring Spring Length @ Torque: 0.625 in Deflection Angle (Deg.): 90 Leg Length: 1.25 in | Max. Rod Outside Dia.: 0.187 in Wind Direction: Left Hand Wire Dia.: 0.035 in Outside Dia.: 0.315 in | Torque @ 1/2 Leg Length (In.-Lbs.): 1.071 Number of Coils: 3.25 Lot: 6 pcs | Used for the following part: Detent Pullup Grip | Zoro (https://www.zoro.com/zoro-select-torsion-spring-90-deg-0315od-pk6-outside-dia-0315-in-3hpg3/i/G7541195/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) | $4.55 | You can pick a different tension springs if you'd like. These are 1.071 lb at halfway up the leg extension which is quite heavy. If you go lighter or heavier, you just want to make sure it's not too much wider (Wire Diameter x Number of Coils) and that it has a Max. Rod Outside Diameter of 0.187 in or larger. Also, know that you'll need one wind direction left hand and one right hand.
1 | 1 | 3HPC7 | Catagory: Torsion Spring Spring Length @ Torque: 0.625 in Deflection Angle (Deg.): 90 Leg Length: 1.25 in | Max. Rod Outside Dia.: 0.187 in Wind Direction: Right Hand Wire Dia.: 0.035 in Outside Dia.: 0.315 in | Torque @ 1/2 Leg Length (In.-Lbs.): 1.071 Number of Coils: 3.25 Lot: 6 pcs | Used for the following part: Detent Pullup Grip | Zoro (https://www.zoro.com/zoro-select-torsion-spring-90-deg-0315od-pk6-3hpc7/i/G7452672/?q=G7452672) | $5.17
LEDs
1 | 4 | B0B3DXQ2CC | Category: Micro LEDs Brand: Bowerful Series: Micro Litz Size: Micro LED-25pcs | LED Color: (1)pure White Leads: Pre-soldered 100mm Leads LED Bead Size: 0.06 x 0.03 x 0.03 in. | Profile: 0603 Bead Material: Glass Lot: 25 pcs | Used for the following part: Pinky Push Button Thumb Push Button 1, 2, and 3 | Amazon (https://a.co/d/aLYYieJ) | $8.99 | Only need four but have to buy in bulk. Smallest pack I could find from reliable source was 25.
Decal
1 | 1 | B0B3DXQ2CC | Category: Decal Brand: TWPUZZ Style: Hazard Color: Yellow/Black | Type: Water-slide decal | Lot: 1 Page | Used for the following part: Panic Button Decal | eBay (https://www.ebay.com/itm/171949262568) | $4.88 | From Ebay Seller How to apply: Apply gloss clear coat (microscale) Plan out the decal placement Place decal into water for 5-10 seconds Remove the decal and let it sit out of the water for 30 seconds to 1 minute Slide the decal onto the part surface Position the decal using a toothpick or q-tip Ase a paper towel to remove excess water, and press the towel down to rid as much water as possible Apply a drop of decal setter and let this sit until it cures, approximately half an hour to a full hour Spray a gloss clear coat to seal and protect the decal
Filament of your choice
1 Spool |  |  | ?? |  |  | ?? | Amazon? | $25?

Sheet: Fasteners
Units/Lots to Buy | Units Used | Part no. / Amazon ASIN | Specifications | Specifications 2 | Specifications 3 | Usage Description | Example Seller and Link | Cost Per Unit / Lot | Additional Comments/Notes
Screws
1 | 14 | 91292A005 | Category: M2 x 5mm Cap Screws Specs. Met: DIN 912, ISO 4762 Head Type: Socket Socket Head Profile: Standard Drive Style: Hex System of Measurement: Metric | Thread Direction: Right Hand Thread Size: M2 Thread Pitch: 0.4 mm Thread Type: Metric Thread Fit: Class 6g Length: 5 mm | Threading: Fully Threaded Thread Spacing: Coarse Head Diameter: 3.8 mm Head Height: 2 mm Drive Size: 1.5 mm Lot: 100 pcs | Used to mount switch pcbs in Main Throttle Grip. | McMaster&Carr (https://www.mcmaster.com/91292A005/) | $14.26
1 | 4 | 91305A104 | Category: M2 x 5mm Tapered Screws Specs. Met: JCIS10-70 Thread Pitch: 0.4 mm Length: 5 mm Threading: Fully Threaded Head Diameter: 3 mm | Head Height: 0.6 mm Countersink Angle: 90° Drive Style: JIS Drive Size: No. 0 Thread Type: Metric Thread Spacing: Coarse | Thread Fit: Class 4h Thread Direction: Right Hand Head Type: Flat Flat Head Profile: Standard System of Measurement: Metric Lot: 25 pcs | Used to mount slide potentiometer. | McMaster&Carr (https://www.mcmaster.com/91305A104/) | $5.94
1 | 4 | 90666A102 | Category: M3 x 5mm Cap Screws Specs. Met: DIN 7984 Thread Size: M3 Thread Pitch: 0.5 mm Length: 5mm Threading: Fully Threaded | Thread Spacing: Coarse Diameter: 5.5mm Height: 2mm Drive Size: 2 mm Thread Type: Metric Thread Fit: Class 6g | Thread Direction: Right Hand Head Type: Socket Socket Head Profile: Low Drive Style: Hex Lot: 100 pcs | Used to mount the main controller board. | McMaster&Carr (https://www.mcmaster.com/90666A102/) | $9.78
1 | 27 | 91294A126 | Category: M3 x 6mm Tapered Screws Specs. Met: DIN 7991 Thread Size: M3 Thread Pitch: 0.5 mm Length: 6 mm Material: Black-Oxide Alloy Steel | Head Diameter: 6 mm Head Height: 1.7 mm Countersink Angle: 90° Drive Style: Hex Drive Size: 2 mm Thread Type: Metric | Thread Spacing: Coarse Thread Fit: Class 6g Thread Direction: Right Hand Head Type: Flat Flat Head Profile: Standard Lot: 100 pcs | Used for holding most of the throttle shells together and various other things. | McMaster&Carr (https://www.mcmaster.com/91294A126/) | $5.45
1 | 2 | 91294A130 | Category: M3 x 10mm Tapered Screws Specs. Met: DIN 7991 Thread Size: M3 Thread Pitch: 0.5 mm Length: 10mm Material: Black-Oxide Alloy Steel | Head Diameter: 6 mm Head Height: 1.7 mm Countersink Angle: 90° Drive Style: Hex Drive Size: 2 mm Thread Type: Metric | Thread Spacing: Coarse Thread Fit: Class 6g Thread Direction: Right Hand Head Type: Flat Flat Head Profile: Standard Lot: 100 pcs | Used for attaching the Main Throttle Grip to the throttle arm, Hold the Grip PCB in place, and attach the Grip Front Block to the Grip Main Body. | McMaster&Carr (https://www.mcmaster.com/91294A130/) | $6.36
1 | 15 | 91263A432 | Category: M3 x 16mm Tapered Screws Specs. Met: DIN 7991 Thread Size: M3 Thread Pitch: 0.5 mm Length: 16 mm Material: Black-Oxide Alloy Steel | Head Diameter: 6 mm Head Height: 1.7 mm Countersink Angle: 90° Drive Style: Hex Drive Size: 2 mm Thread Type: Metric | Thread Spacing: Coarse Thread Fit: Class 6g Thread Direction: Right Hand Head Type: Flat Flat Head Profile: Standard Lot: 100 pcs | Used for attaching the Main Throttle Grip to the throttle arm, Hold the Grip PCB in place, and attach the Grip Front Block to the Grip Main Body. | McMaster&Carr (https://www.mcmaster.com/91294A134/) | $10.84
1 | 4 | 91294A210 | Category: M5 x 12mm Tapered Screws Specs. Met: DIN 7991, ISO 10642 Thread Size: M5 Thread Pitch: 0.8 mm Length: 12 mm Threading: Fully Threaded | Head Diameter: 10 mm Head Height: 2.8 mm Countersink Angle: 90° Drive Style: Hex Drive Size: 3 mm Thread Type: Metric | Thread Spacing: Coarse Thread Fit: Class 6g Thread Direction: Right Hand Head Type: Flat Flat Head Profile: Standard Lot: 100 pcs | Used to attach the Flat Braces to the bottom of the Box shell or to attach to your throttle mount. | McMaster&Carr (https://www.mcmaster.com/91294A210/) | $10.35 | For attaching to your throttle mount, you may need longer screws, depending on the thickness of your mounting surface.
Threaded Inserts
1 | 14 | 94180A312 | Category: M2 Threaded Inserts For Use In: Plastic Threaded Insert Type: Heat Set Material: Brass System of Measurement: Metric Thread Direction: Right Hand | Thread Size: M2 Thread Pitch: 0.4 mm Thread Type: Metric Thread Spacing: Coarse Thread Fit: Class 6H Installed Length: 4.8 mm | For Min. Material Thickness: 5.57 mm Drill Bit Size: 2.7 mm For Maximum Hole Diameter: 2.7mm For Hole Taper Angle: 8° End Type: Open Lot: 100 pcs | For adding M2 threading to printed parts. | McMaster&Carr (https://www.mcmaster.com/94180A312/) | $17.18
1 | 41 | 94180A331 | Category: M3 Threaded Inserts For Use In: Plastic Threaded Insert Type: Heat Set Material: Brass System of Measurement: Metric Thread Direction: Right Hand | Thread Size: M3 Thread Pitch: 0.5 mm Thread Type: Metric Thread Spacing: Coarse Thread Fit: Class 6H Installed Length: 3.8 mm | For Min. Material Thickness: 4.57 mm Drill Bit Size: No. 8 For Maximum Hole Diameter: 0.199" For Hole Taper Angle: 8° End Type: Open Lot: 100 pcs | For adding M3 threading to printed parts. | McMaster&Carr (https://www.mcmaster.com/94180A331/) | $16.81
1 | 5 | 94180A361 | Category: M5 Threaded Inserts For Use In: Plastic Threaded Insert Type: Heat Set Material: Brass System of Measurement: Metric Thread Direction: Right Hand | Thread Size: M5 Thread Pitch: 0.8 mm Thread Type: Metric Thread Spacing: Coarse Thread Fit: Class 6H Installed Length: 6.7 mm | For Min. Material Thickness: 7.47 mm Drill Bit Size: N For Maximum Hole Diameter: 0.302" For Hole Taper Angle: 8° End Type: Open Lot: 50 pcs | For adding M5 threading to printed parts. | McMaster&Carr (https://www.mcmaster.com/94180A361/) | $15.64
1 | 1 | 94180A371 | Category: M6 Threaded Inserts For Use In: Plastic Threaded Insert Type: Heat Set Material: Brass System of Measurement: Metric Thread Direction: Right Hand | Thread Size: M6 Thread Pitch: 1 mm Thread Type: Metric Thread Spacing: Coarse Thread Fit: Class 6H Installed Length: 7.6 mm | For Min. Material Thickness: 8.37 mm Drill Bit Size: S For Maximum Hole Diameter: 0.348" For Hole Taper Angle: 8° End Type: Open Lot: 25 pcs | For adding M6 threading to printed parts. | McMaster&Carr (https://www.mcmaster.com/94180A371/) | $12.19
Nuts
1 | 1 | 90576A104 | Category: M5 Nylon Lock Nut Spec. Met: DIN 985, ISO 10511 Thread Prop. Size: M5 Pitch: 0.8 mm Type: Metric Spacing: Coarse Fit: Class 6H Direction: Right Hand | Width: 8 mm Height: 5 mm Drive Style: External Hex Nut Type: Locknut, Hex | Hex Nut Profile: Standard Locking Type: Nylon Insert System of Measurement: Metric Lot: 100 pcs | Optional: May be needed to secure throttle to a mounting surface | McMaster&Carr (https://www.mcmaster.com/90576A104/) | $6.14
Washers
1 | 28 | B01ARADX88 | Category: M2 Fiber Washers Brand: Uxcell Material: Insulating Fiber Color: Red | Outside Diameter: 4 mm Inside Diameter: 2 mm Thickness: .5 mm Fastner Size: M2 | Lot: 100 pcs | Used to prevent shorts/damage with small switch pcbs in the Main Throttle Grip when screwing them into place. | Amazon (https://a.co/d/jaybwob) | $7.33
1 | 8 | B07R8CH9BL | Category: M3 Fiber Washers Brand: Uxcell Material: Insulating Fiber Color: Red | Outside Diameter: 8 mm Inside Diameter: 3 mm Thickness: .5 mm Fastner Size: M3 | Lot: 500 pcs | Used to prevent shorts/damage on the Main Controller Board when screwing into place. | Amazon (https://a.co/d/j4dwa2X) | $6.99

Sheet: Equipment
Units Used | Part no. / Amazon ASIN | Equipment | Specifications | Specifications 2 | Specifications 3 | Usage Description | Example Seller and Link | Cost Per Unit / Lot | Additional Comments/Notes | Additional Comments/Notes 2
16 | ND018-8 | FFF 3D Printer Examples: Ender 3, CR-10, Dremel DigiLab, Flashforge Adventure 3, etc... | Minimum Dimensions: 150 mm X Axis (width) 120 mm Y Axis (depth) 130 mm Z Axis (height) |  |  | Used to magnitize the following parts: Main Throttle Friction Adjustment Knob Side Mini Throttle Friction Adjustment Knob | Magnet4Less (https://www.magnet4less.com/n52-neodymium-rare-earth-magnets-1-8-in-x-1-8-in-disc) | $0.10 | Only use a different vendor for these magnets if you know their ratings are accurate. Amazon magnet vendors make all sorts of claims regarding magnet strength and very few are accurate. This build requires true N52 magnets for friction adjusters | WARNING: Handle with extreme care. Real N52 magnets even of this small size can be VERY dangerous. They will pinch, bruise, or even rip flesh if you get some between two of these small magnets. Handle with caution. Store far away from metal and leave wrapped in their bubble wrap sleave until you are ready to install them in the throttle.
16 | ND018-8 | Resin 3D Printer Examples: Ender 3, CR-10, Dremel DigiLab, Flashforge Adventure 3, etc... | Minimum Dimensions: 150 mm X Axis (width) 120 mm Y Axis (depth) 130 mm Z Axis (height) |  |  | Used to magnitize the following parts: Main Throttle Friction Adjustment Knob Side Mini Throttle Friction Adjustment Knob | Magnet4Less (https://www.magnet4less.com/n52-neodymium-rare-earth-magnets-1-8-in-x-1-8-in-disc) | $0.10 | Only use a different vendor for these magnets if you know their ratings are accurate. Amazon magnet vendors make all sorts of claims regarding magnet strength and very few are accurate. This build requires true N52 magnets for friction adjusters | WARNING: Handle with extreme care. Real N52 magnets even of this small size can be VERY dangerous. They will pinch, bruise, or even rip flesh if you get some between two of these small magnets. Handle with caution. Store far away from metal and leave wrapped in their bubble wrap sleave until you are ready to install them in the throttle.
x | cv | Soldering Iron with long narrow tip | Category: Natural Leather Hide | <M | Color: Dealers Choice | Used on the following parts: Main Grip Covering Main Throttle Friction Adjustment Pad Side Mini Throttle Friction Adjustment Pad | Amazon (https://a.co/d/4WyUTRn) | $8.99 | Use whatever company or color you'd like but make sure it is natural leather with one side raw and no more than 1mm thick.
x | B00823JBZW | Category: UHMW Tape Roll | Category: UHMW Tape Roll | Thickness: 0.005 in. | W x L: 2 in. x 15 ft | Used in collaberation with leather to add smooth friction to throttle arms. | Amazon (https://a.co/d/89GrpMN) | $14.55
x | 89065K75 | Material: 430 Stainless Steel Series: Bend-and-Stay Shape: Wire Shape Type: Wire Diameter: 0.045" Diam. Tol.: -0.001" to 0.001" | Material: 430 Stainless Steel Series: Bend-and-Stay Shape: Wire Shape Type: Wire Diameter: 0.045" Diam. Tol.: -0.001" to 0.001" | Tol. Rating: Standard Fabrication: Cold Drawn Heat Treatment: Annealed (Softened) Tensile Strength: 70,000 psi Appearance: Matte | Magnetic Properties: Magnetic Elongation: 0.2 Weight: 1/4 lb. Container Type: Coil Length: 46 ft. | Used to hold the following parts in place: Main Throttle Friction Adjustment Knob Side Mini Throttle Friction Adjustment Knob | McMaster-Carr (https://www.mcmaster.com/89065K75/) | $9.97 | If you want to go with another vendor or brand, make sure its one you know you can trust. Before purchasing the linked wire, I tried two other vendors for 430 Stainless Steel wire. This stainless steel mixture should always be ferrous (attracted to magnets). Neither of them were.
2 | B01M1RYLRE | Category: Flat Brace Dimensions: 96 x 20 x 3mm | Category: Flat Brace Dimensions: 96 x 20 x 3mm | Mounting Holes: 5mm Material: Stainless Steel | Color: Black Oxide Lot: 4 pcs | Used to extend out the back of the Box to prevent tipping when using unmounted on a desk. | Amazon (https://a.co/d/azZ2u93) | $7.99 | Only one is needed if you know you will be mounting the throttle but you still need one if you are mounting using a Thrustmaster TWCS Throttle mount. If using on a desk, two are needed. If you use this link, select the size option: 3-4/5 Inch(10 Pcs) | UPDATE: This link used to offer 4 at this size in black oxide. Now they offer the right size still but in a pack of 10 with no oxide finish : / You might need to hunt around if you want to buy less than 10 and if you want black oxide coating.
4 | B01G5WX4M2 | Category: Stick On Rubber Bumpers | Category: Stick On Rubber Bumpers | L x W: 25.4mm x 25.4mm Thickness: 4.6mm | Application: Self Adhesive Lot: 20 pcs | No-Slip rubber feet for desktop usage | Amazon (https://a.co/d/3KZPwg4) | $9.99 | Only needed if not mounting. Otherwise, pick the shape, size, color, and brand you like.
3 | B082PWB7R5 | Category: Ball Bearing Profile: 6804ZZ | Category: Ball Bearing Profile: 6804ZZ | OD: 32mm ID: 20mm Width: 7mm | Lot: 10 pcs | Used to smooth rotation of: Main Throttle Side Throttle | Amazon (https://a.co/d/hf7pMMf) | $13.49 | So, you can get the cheaper Uxcell bearings which are 13.45 for 10 (and only use 3) or you can get nicer bearings. It's up to you. Just know there is a difference. Here is a link to the bearings I ended up using from McMaster-Carr: https://www.mcmaster.com/5972K279/ The McMaster-Carr bearings are smoother than any bearing I've gotten from amazon but you pay much more for that quality and precision.
1 | B07J4SY7BB | Category: External USB Cable Brand: URWOOW Connection Type: USB A / USB A Connection Gender: Male / Female | Category: External USB Cable Brand: URWOOW Connection Type: USB A / USB A Connection Gender: Male / Female | Female Conn. Shape: Flush Rectangle Head Angles: Straight/Straight Length: 6 ft. | Material: Flexible Rubber Capability: Charging and Data Data Tx Rate: USB 3.0 | Used to connect PC to internal usb cable which connects to the Main Controller Board. | Amazon (https://a.co/d/3u04QTK) | $8.30
1 | B07P76SHHM | Category: Internal USB Cable Brand: CERRXIAN Connection Type: USB A, USB Mini Connection Gender: Male to Male | Category: Internal USB Cable Brand: CERRXIAN Connection Type: USB A, USB Mini Connection Gender: Male to Male | Length: 9 inch Gauge: 9.0 Head Angles: Right Angle/Right Angle Material: Flexible Rubber | Capability: Charging and Data Data Tx Rate: 0.48 Gigabits Per Second Lot: 2 pcs | Used to connect the External USB Cable to the Main Controller Board's Teensy 2.0. | Amazon (https://a.co/d/g1mGPne) | $7.99
1 | 15366-0439 | Category: FFC / FPC Jumper Cable Number of Conductors: 40 Conductor Manufacturer: Molex Pitch: 0.5 mm Cable Length: 203 mm Contact Location: Same Side Contacts Current Rating: 500 mA | Category: FFC / FPC Jumper Cable Number of Conductors: 40 Conductor Manufacturer: Molex Pitch: 0.5 mm Cable Length: 203 mm Contact Location: Same Side Contacts Current Rating: 500 mA | Voltage Rating: 600 VAC Series: 15366 Contact Plating: Tin Max. Operating Temp.: + 105 C Min. Operating Temp.: - 40 C Tradename: Premo-Flex Part # Aliases: 153660439 0153660439 |  | 40 pin ribbon cable that connects the Main Controller Board to the satallite Bridge Board in he throttle grip by running up the main throttle arm. | Mouser (https://www.mouser.com/ProductDetail/538-15366-0439) | $10.97 | Longer will make connecting to the Grip Satellite PCB easier but you'll have to fold excess cable and tuck it into throttle arm slot.
5 | B07MQ5C8L9 | Category: M3 Standoff / Spacer Bar Length: 35 mm Brand: Uxcell | Category: M3 Standoff / Spacer Bar Length: 35 mm Brand: Uxcell | Inner Threading: M3 Outside Diameter: 5 mm Color/Finish: Glossy Black | Material: Aluminum Alloy Lot: 10 pcs | Used to brace the detent pullup system. | Amazon (https://a.co/d/hxi33i9) | $11.99
1 | B07SPRRYFS | Category: M6 Standoff / Spacer Bar Length: 30 mm Brand: Xiaoyztan | Category: M6 Standoff / Spacer Bar Length: 30 mm Brand: Xiaoyztan | Inner Threading: M6 Outside Diameter: 10 mm Color/Finish: Polished Steel | Material: Stanless Steel Lot: 5 pcs | Used as the arm for side throttle. | Amazon (https://a.co/d/aQND8E7) | $7.99
1 | B07YB5ZVXR | Category: M6 Threaded Rod Length: 40 mm Brand: Smartsails | Category: M6 Threaded Rod Length: 40 mm Brand: Smartsails | Outside Threading: M6 (Fully Threaded) Color/Finish: Polished Steel | Material: Stanless Steel Lot: 10 pcs | Used to run through and connect the following: Side Throttle Handle, Arm, and Bearing | Amazon (https://a.co/d/58x2ohd) | $8.99 | Only one needed but could only find at a reasonable price for a pack of 10.
2 | B083R5KBRC | Category: M3 Screw Pin Brand: EPTNNASO Outside Threading: M3 Threaded Portion Length: 3mm | Category: M3 Screw Pin Brand: EPTNNASO Outside Threading: M3 Threaded Portion Length: 3mm | Unthreaded Length: 8mm Unthreaded Width: 2.5mm Total Length: 11mm | Color/Finish: Black Semigloss Material: Steel Lot: 10 pcs | Used on the ends of the detent pull up bar to slide along the detent tabs. | Amazon (https://a.co/d/cOQTN9o) | $5.99
1 | 3HPG3 | Catagory: Torsion Spring Spring Length @ Torque: 0.625 in Deflection Angle (Deg.): 90 Leg Length: 1.25 in | Catagory: Torsion Spring Spring Length @ Torque: 0.625 in Deflection Angle (Deg.): 90 Leg Length: 1.25 in | Max. Rod Outside Dia.: 0.187 in Wind Direction: Left Hand Wire Dia.: 0.035 in Outside Dia.: 0.315 in | Torque @ 1/2 Leg Length (In.-Lbs.): 1.071 Number of Coils: 3.25 Lot: 6 pcs | Used for the following part: Detent Pullup Grip | Zoro (https://www.zoro.com/zoro-select-torsion-spring-90-deg-0315od-pk6-outside-dia-0315-in-3hpg3/i/G7541195/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) | $4.55 | You can pick a different tension springs if you'd like. These are 1.071 lb at halfway up the leg extension which is quite heavy. If you go lighter or heavier, you just want to make sure it's not too much wider (Wire Diameter x Number of Coils) and that it has a Max. Rod Outside Diameter of 0.187 in or larger. Also, know that you'll need one wind direction left hand and one right hand.
1 | 3HPC7 | Catagory: Torsion Spring Spring Length @ Torque: 0.625 in Deflection Angle (Deg.): 90 Leg Length: 1.25 in | Catagory: Torsion Spring Spring Length @ Torque: 0.625 in Deflection Angle (Deg.): 90 Leg Length: 1.25 in | Max. Rod Outside Dia.: 0.187 in Wind Direction: Right Hand Wire Dia.: 0.035 in Outside Dia.: 0.315 in | Torque @ 1/2 Leg Length (In.-Lbs.): 1.071 Number of Coils: 3.25 Lot: 6 pcs | Used for the following part: Detent Pullup Grip | Zoro (https://www.zoro.com/zoro-select-torsion-spring-90-deg-0315od-pk6-3hpc7/i/G7452672/?q=G7452672) | $5.17
4 | B0B3DXQ2CC | Category: Micro LEDs Brand: Bowerful Series: Micro Litz Size: Micro LED-25pcs | Category: Micro LEDs Brand: Bowerful Series: Micro Litz Size: Micro LED-25pcs | LED Color: (1)pure White Leads: Pre-soldered 100mm Leads LED Bead Size: 0.06 x 0.03 x 0.03 in. | Profile: 0603 Bead Material: Glass Lot: 25 pcs | Used for the following part: Pinky Push Button Thumb Push Button 1, 2, and 3 | Amazon (https://a.co/d/aLYYieJ) | $8.99 | Only need four but have to buy in bulk. Smallest pack I could find from reliable source was 25.
1 | B0B3DXQ2CC | Category: Decal Brand: TWPUZZ Style: Hazard Color: Yellow/Black | Category: Decal Brand: TWPUZZ Style: Hazard Color: Yellow/Black | Type: Water-slide decal | Lot: 1 Page | Used for the following part: Panic Button Decal | eBay (https://www.ebay.com/itm/171949262568) | $4.88 | From Ebay Seller How to apply: Apply gloss clear coat (microscale) Plan out the decal placement Place decal into water for 5-10 seconds Remove the decal and let it sit out of the water for 30 seconds to 1 minute Slide the decal onto the part surface Position the decal using a toothpick or q-tip Ase a paper towel to remove excess water, and press the towel down to rid as much water as possible Apply a drop of decal setter and let this sit until it cures, approximately half an hour to a full hour Spray a gloss clear coat to seal and protect the decal
 |  | ?? | ?? |  |  | ?? | Amazon? | $25?
