ImArchimedes/WilsonThrust510/Documentation/BOMs/Wilson Thrust BOM v4 No Grip LEDs.xlsx

Sheet: Large PCB Parts
Amount | Part no. | Specification | Description | Potential Seller/Link | Potential Cost | Additional Comments/Notes
SMD Resistors
56 | a19030500ux0309 | 10k Ohms SMD Resistor 1/4W 1206 Profile | Resistor used for all Shift Register inputs on Main Board | Amazon (https://www.amazon.com/gp/product/B07QGP6H7F/ref=ppx_yo_dt_b_search_asin_title?ie=UTF8&psc=1) | $1.69 | Cheapest if you just buy 100
12 | RC0805FR-07365RL | 365 Ohms SMD Resistors 0.125W, 1/8W 0805 (2012 Metric) Profile | Resistor used for LEDs on Main Board | Digikey (https://www.digikey.com/en/products/detail/yageo/RC0805FR-07365RL/727888) | $0.50
SMD Capacitors
2 | VJ0603Y104KXAAC | 0.1 µF Capacitance SMD Capacitor 0603 (1608 Metric) Profile | Capacitor used for both Main and Mini Throttle Poteniometers | Digikey (https://www.digikey.com/en/products/detail/vishay-vitramon/VJ0603Y104KXAAC/8305314) | $0.64
SMD Shift Registers
7 | SN74HC165QPWREP | IC 8BIT SHIFT REGISTER 16-TSSOP | Shift Registers for connecting groups of 8 inputs to controller. | Digikey (https://www.digikey.com/en/products/detail/texas-instruments/SN74HC165QPWREP/1666456) | $16.10
Controller
1 | Teensy 2.0 | 8-Bit AVR Processor 16 MHz (ATMEGA32U4) 31.5K Flash Memory, 2.5K RAM, 1K EEPROM USB Can Emulate Any Type of Device Single Pushbutton Programming Arduino Compatible | Controller or "brain" of your throttle. | Amazon (https://www.amazon.com/gp/product/B00NC43256/ref=ppx_yo_dt_b_search_asin_title?ie=UTF8&psc=1) | $18.53
JST ZH Parts
6 | ZHR-2, SZH-002T-P0.5, B2B-ZR(LF)(SN) | JST, ZH, 1.5mm Pitch, 2-Pin Connector Housing, Matching Pre-Crimped Wires | 2-pin Pre-crimped wires and matching connection housings for wiring the following inputs to your Bridge Board and Main Controller Board: Palm Button Joystick Center Click | Ebay (https://www.ebay.com/itm/373686637418) | $8.28
23 | ZHR-3, SZH-002T-P0.5, B3B-ZR(LF)(SN) | JST, ZH, 1.5mm Pitch, 3-Pin Connector Housing, Matching Pre-Crimped Wires | 3-pin Pre-crimped wires and matching connection housings for wiring the following inputs to your Bridge Board and Main Controller Board: Illuminated Push Buttons Encoders Potentiometers Grip Push Buttons | Ebay (https://www.ebay.com/itm/231425677399?epid=1860646789&hash=item35e20b9857:g:oiMAAOSwj0NUkuM9) | $4.69
1 | ZHR-4, SZH-002T-P0.5, B3B-ZR(LF)(SN) | JST, ZH, 1.5mm Pitch, 4-Pin Connector Housing, Matching Pre-Crimped Wires | 4-pin Pre-crimped wires and matching connection housings for wiring the following inputs to your Bridge Board and Main Controller Board: LED Toggle Switch | Ebay (https://www.ebay.com/itm/254778927722?hash=item3b5201ea6a:g:jDQAAOSwInxXNuXH) | $4.99
2 | ZHR-5, SZH-002T-P0.5, B5B-ZR(LF)(SN) | JST, ZH, 1.5mm Pitch, 5-Pin Connector Housing, Matching Pre-Crimped Wires | 5-pin pre-crimped wires and matching connection housings for wiring the following inputs to your Bridge Board and Main Controller Board: Rotary Selector Switch 3-way Hat | Ebay (https://www.ebay.com/itm/254612009292) | $8.11
4 | ZHR-7, SZH-002T-P0.5, B7B-ZR(LF)(SN) | JST, ZH, 1.5mm Pitch, 7-Pin Connector Housing, Matching Pre-Crimped Wires | 7-pin pre-crimped wires and matching connection housings for wiring the following inputs to your Bridge Board and Main Controller Board: 5-way Hats | Ebay (https://www.ebay.com/itm/171361716328?epid=808717826) | $6.64
Ribbon Cable Parts
1 | 4-1734839-0 | 40 pin, .5mm Pitch, Right Angle, Surface Mounted, FPC Connector | 40 pin ribbon cable connector used on Main Controller Board to connect it to the Bridge Board in the throttle grip. | Mouser (https://www.mouser.com/ProductDetail/571-4-1734839-0) | $1.08
1 | 4-1734742-0 | 40 pin, .5mm Pitch, Vertical, Surface Mounted, FPC Connector | 40 pin ribbon cable connector used on Bridge Board in the throttle grip to connect it to the Main Controller Board. | Mouser (https://www.mouser.com/ProductDetail/571-4-1734742-0) | $3.30
1 | 15366-0439 | 40 pin, .5mm Pitch, Same Side Contacts, FCP Jumper Cable, 203 mm | 40 pin ribbon cable that connects the Main Controller Board to the satallite Bridge Board in he throttle grip by running up the main throttle arm. | Mouser (https://www.mouser.com/ProductDetail/538-15366-0439) | $10.30

Sheet: Small PCB Parts
Amount | Part no. | Specification | Description | Potential Seller/Link | Cost
20 | CUS05S40,H3F | Diode, Schottky, 40V 500MA, USC, SMD | Schottky diode needed for the circuit on PCBs for the following switches (4 each): 5-way Hats (Alps RKJXM1) 3-way Hat (Alps RKJXM1) 5-way Hat/Encoder Combo (Alps RKJXT1) | Digikey (https://www.digikey.com/en/products/detail/toshiba-semiconductor-and-storage/CUS05S40,H3F/5114375) | $5.68
35 | RNCP0805FTD1K00 | 1 kOhms Resistor, SMD, 1% Tolerance, 1/4W, (2.00mm x 1.25mm) | 1k resistor needed for the circuits on PCBs for the following switches (7 each): 5-way Hats (Alps RKJXM1) 3-way Hat (Alps RKJXM1) 5-way Hat/Encoder Combo (Alps RKJXT1) | Digikey (https://www.digikey.com/en/products/detail/stackpole-electronics-inc/RNCP0805FTD1K00/2240568) | $2.56
10 | MMBT3904-TP | 40V, 0.2A SOT23, NPN, Transistor, SMD | Transistor needed for the circuits on PCBs for the following switches (2 each): 5-way Hats (Alps RKJXM1) 3-way Hat (Alps RKJXM1) 5-way Hat/Encoder Combo (Alps RKJXT1) | Digikey (https://www.digikey.com/en/products/detail/micro-commercial-co/MMBT3904-TP/717395) | $1.25

Sheet: Input Hardware
Amount | Part no. | Specification | Description | Potential Seller/Link | Cost Per Unit | Additional Comments/Notes
Potentiometers
2 | P11S1V0FLSY00103KA | 10k Ohm, 1 Gang, Linear Panel Mount Potentiometer, 1.0 Kierros, Cermet, 1W, Solder Lug, 300° | Used for the following inputs: Main Throttle Arm Mini Side Throttle Arm | Digikey (https://www.digikey.com/en/products/detail/vishay-sfernice/P11S1V0FLSY00103KA/2712654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) | $15.30
1 | PTD901-2015K-B503 | 50k Ohms, Rotary Potentiometer, Linear, Carbon, .05W, 300° | Used for the following inputs: Grip End Pinky Knob | Digikey (https://www.digikey.com/en/products/detail/bourns-inc/PTD901-2015K-B503/3781003) | $1.83
1 | PTA1543-2215CIB503 | 50k Ohms, Slide Potentiometer, Linear, 50 mW, 25mm Travel, Center Detent | Used for the following inputs: Ring Finger Slider | Mouser (https://www.mouser.com/ProductDetail/Bourns/PTA1543-2215CIB503/?qs=9fn1gpisni7MYk8V%252BVGo3w%3D%3D) | $1.20
Hat Switches
4 | RKJXM1015004 | Multi-Directional Switch, 8-Direction Switches, Center Push Switch | Used for the following inputs: 5-way Hats (up, down, left, right, center) 3-way Hat (up, down, center) | Mouser (https://www.mouser.com/ProductDetail/Alps-Alpine/RKJXM1015004) | $9.57
1 | RKJXT1F42001 | Multi-Directional Switch and Enc, 4-Direction Switchs, Center Push Switch, Rotary Encoder | Used for the following input: 5-way Hat / Encoder Combo(up, down, left, right, center, EncA, EncB) | Mouser (https://www.mouser.com/ProductDetail/Alps-Alpine/RKJXT1F42001) | $7.89
Analog Directional Switch
1 | THB001P | Joystick, 2 - Axis Analog (Resistive) Output, 10 kOhms | Used for the following inputs: Pointer Finger Analog Stick | Digikey (https://www.digikey.com/en/products/detail/c-k/THB001P/11687191) | $1.99
Round Push Buttons
1 | 750139966066 | APIELE (Pcs of 2) 12mm Momentary Push Button Switch High Round Head Stainless Steel 1 Normally Open with Ring Led (Yellow) | Used for the following input: Audio-In Mute Switch Audio-Out Mute Switch | Amazon (https://www.amazon.com/gp/product/B08LYWZ33K/ref=ppx_yo_dt_b_search_asin_title?ie=UTF8&psc=1) | $11.89
1 | 0761344956971 | APIELE (Pcs of 2) 12mm Latching Push Button Switch High Round Head Stainless Steel 1 Normally Open with Ring Led (White) | Used for the following input: LED Toggle | Amazon (https://www.amazon.com/gp/product/B08LV5DWLG/ref=ppx_yo_dt_b_search_asin_title?ie=UTF8&psc=1) | $10.89 | Only 1 needed.
Toggle Switch
2 | 100SP4T1B1M1QEH | Toggle Switch, (ON)-OFF-(ON), SLD, MT | Used for the following input: Ditch-Switch 1 Ditch-Switch 2 | Mouser (https://www.mouser.com/ProductDetail/E-Switch/100SP4T1B1M1QEH) | $3.17
Square Push Buttons
9 | UB15KKW015F-FF | Pushbutton Switch, SPDT, ON-(ON), Illuminated: Green | Used for the following input: Illuminated 3x3 Push Button Grid | Mouser (https://www.mouser.com/ProductDetail/NKK-Switches/UB15KKW015F-FF?qs=vkVUaTJhty0ONJEF4QoT3Q%3D%3D) | $8.69 | Ooof! That cost, right? You don't need to buy these switches. For the main 3x3 Button Grid and Panic Button, you can use any SPDT illuminated switches that will snap into 16.2mm square panel cutouts. they have to be illuminated for this build otherwise the won't connect to the main pcbs using the 3-pin headers I designed the board with. Just make sure they are not too tall as the Main Controller Board is right underneath the Button Grid. That being said, these over priced NKK switches are the most satisfying to press push button switches I've ever purchased.
1 | LB15SKW01-5C-JC | Pushbutton Switch, SPDT, ON-(ON), Illuminated: Red | Push Button used for the following input: Panic Button | Digikey (https://www.digikey.com/en/products/detail/nkk-switches/LB15SKW01-5C-JC/1007083) | $14.62
1 | AT499 | Protective Guard, for LB Series SQ Switches | Used for the following input: Panic Button | Digikey (https://www.digikey.com/en/products/detail/nkk-switches/AT499/379092) | $2.08 | Only needed if you are buying the NKK LB Panic button. Otherwise, you can get a switch that will fit the panel and has a cover or you can have it not
1 | 8125J80ZBE2 | PB Switch, SPDT, ON-MOM, 0.4VA, Snap-in | Used for the following input: Palm Button | Digikey (https://www.digikey.com/en/products/detail/c-k/8125J80ZBE2/10063864) | $5.96 | Seems to be only available in bulk buy now the link I purchased from. You can try and find it elsewhere or try and find matching dimensions.
4 | Kailh Choc Switch V1 | Any V1 Kailh Choc Switches. Pack: 10 I like the White version which is "Clicky" with an actuating force of 60±10gf but any will fit my design. | Used for the following inputs: Grip Thumb Button Top Grip Thumb Button Bottom Grip Thumb Button Under Grip Pinky Button | MKUltra (https://mkultra.click/choc-switches) | $5.50 | If you want, you could get two sample packs from MKUltra. They are $7 a piece so you'd pay more but you would have two of every variety and some keycaps. Then you could pick your favorite type for the Push buttons.
Selector Switch
1 | 56DP30-01-2-AJN | 2-6 Position Rotary Switch | Used for the following input: Profile Selector | Digikey (https://www.digikey.com/en/products/detail/grayhill-inc/56DP30-01-2-AJN/764222) | $18.14 | This is another one where you can get a cheaper part. There is a mount that is glued in place for the selector switch. You can just change the cut out size to use a less expensive switch. I went with this one because the first two I tried both didn't feel right and one failed on me just while testing.
Knobs, Dials, and Wheels
1 | 11K5015-KCNG | 1/4 in Selector Dial (Grey) | Used for the following input: Profile Selector | Mouser (https://www.mouser.com/ProductDetail/Grayhill/11K5015-KCNG) | $3.99
1 | 2056 (Adafruit) | KNOB KNURLED 0.236" METAL | Used for the following input: Grip End Pinky Knob | Digikey (https://www.digikey.com/en/products/detail/2056/1528-1906-ND/6681419?itemSeq=357806551) | $3.95
2 | 11K5029-KMNB | KNOB KNURLED 0.250" PLASTIC | Used for the following input: Audio-In Knob Audio-Out Knob | Digikey (https://www.digikey.com/en/products/detail/grayhill-inc/11K5029-KMNB/2677945) | $5.18 | Cheaper options available. Just look for small knobs for .25 inch shaft.
Encoders
2 | PEC11R-4015K-S0024 | ROTARY ENCODER MECHANICAL 24PPR 6mm Dia Knurled End | Used for the following inputs: Audio Input Level Audio Output Level | Digikey (https://www.digikey.com/en/products/detail/bourns-inc/PEC11R-4015K-S0024/4699187) | $2.49

Sheet: Build Materials & Random
Amount | Part no. | Specification | Description | Potential Seller/Link | Cost Per Unit | Additional Comments/Notes
Magnets
8 | ND018-8 | Magnet, N52, 1/8 inch x 1/8 inch., Cylinder, Poles on Flat Side, Approximate pull force: 1.7 lbs. per mag | Used to magnitize the following parts: Main Throttle Friction Adjustment Knob Side Mini Throttle Friction Adjustment Knob | Magnet4Less (https://www.magnet4less.com/n52-neodymium-rare-earth-magnets-1-8-in-x-1-8-in-disc) | $0.10 | Only use a different vendor for these magnets if you know their ratings are accurate. Amazon magnet vendors make all sorts of claims regarding magnet strength and very few are accurate. This build requires true N52 magnets for friction adjusters WARNING: Handle with extreme care. Real N52 magnets even of this small size can be VERY dangerous. They will pinch, bruise, or even rip flesh if you get some between two of these small magnets. Handle with caution. Store far away from metal and leave wrapped in their bubble wrap sleave until you are ready to install them in the throttle.
Leather
1 | Brown Leather Hide | Natural Leather Hide, 8"x11", 0.8" Thick, Brown | Used on the following parts: Main Grip Covering Side Mini Grip Covering Main Throttle Friction Adjustment Pad Side Mini Throttle Friction Adjustment Pad | Amazon (https://www.amazon.com/gp/product/B00N51TITA/ref=ppx_yo_dt_b_search_asin_title?ie=UTF8&psc=1) | $7.99 | Use whatever company or color you'd like but make sure it is natural leather with one side raw and no more than 1mm thick.
Slip-Tape
1 | 423-3 | UHMW tape roll, 0.005 in thick, 2 in wide, 15 ft. length | Used in collaberation with leather to add smooth friction to throttle arms. | Amazon (https://www.amazon.com/gp/product/B00823JBZW/ref=ppx_yo_dt_b_search_asin_title?ie=UTF8&psc=1) | $15.18
Steel Wire
1 | 430 Stainless Steel (ferrous) | Stainless steel wire, .08" diameter, cold draw, bend-and-stay, ferrous | Used to hold the following parts in place: Main Throttle Friction Adjustment Knob Side Mini Throttle Friction Adjustment Knob | McMaster-Carr (https://www.mcmaster.com/89065K71/) | $9.98 | If you want to go with another vendor or brand, make sure its one you know you can trust. Before purchasing the linked wire, I tried two other vendors for 430 Stainless Steel wire. This stainless steel mixture should always be ferrous (attracted to magnets). Neither of them were.
Braces
1 | 3.8 inch Stainless Steel Flat Straight Brace | 4 Pcs Flat Brace, 96 x 20 x 3mm, 5mm Mounting Hole | Used to extend out the back of the Box to prevent tipping when using unmounted on a desk. | Amazon (https://www.amazon.com/gp/product/B08MPQMX4B/ref=ppx_yo_dt_b_search_asin_title?ie=UTF8&psc=1) | $7.99 | Only one is needed if you know you will be mounting the throttle but you still need one if you are mounting using a Thrustmaster TWCS Throttle mount.
Bumpers
1 | Rubber Bumpers | Rubber Bumpers, 20 pack, 25.4mm, Square, 4.6mm Thick, Self Adhesive | No-Slip rubber feet for desktop usage. | Amazon (https://www.amazon.com/dp/B01G5WX4M2?psc=1&ref=ppx_yo2_dt_b_product_details) | $10.15 | Only needed if not mounting. Otherwise, pick the shape, size, color, and brand you like.
Ball Bearings
3 | 6804-2RS or any 6804ZZ | Ball Bearing, 32mm OD, 7mm Width, for Round 20mm Diameter Shaft | Used to smooth rotation of: Main Throttle Side Throttle | $ Uxcell/Amazon (https://www.amazon.com/gp/product/B082PWB7R5/ref=ppx_yo_dt_b_search_asin_title?ie=UTF8&psc=1) | $13.49 | So, you can get the cheaper Uxcell bearings which are 13.45 for 10 (and only use 3) or you can get nicer bearings. It's up to you. Just know there is a difference. The McMaster-Carr bearings are smoother than any bearing I've gotten from amazon but you pay much more for that quality and precision.
 |  |  |  | $$$ McMaster-Carr (https://www.mcmaster.com/5972K279/)
USB Cables
1 | USB Extension Flush Mount | 6ft. USB Extention Cable, Square Flush Mount (Female) | Used to connect PC to throttle and mount in place. | Amazon (https://www.amazon.com/gp/product/B07J4SY7BB/ref=ppx_yo_dt_b_search_asin_title?ie=UTF8&psc=1) | $7.89
1 | USB to Mini USB Cable | 9 inch USB A to USB Mini, Male to Male, Right Angle/Right Angle, Flexible, Charging and Data | For connecting Controller PCB to USB Flush Mount (which connects to PC) | Amazon (https://www.amazon.com/gp/product/B07P76SHHM/ref=ppx_yo_dt_b_search_asin_title?ie=UTF8&psc=1) | $7.99
Internally Threaded Rods
1 | M3x35mm Internally Threaded Rod | Uxcell round Aluminum Standoff Pack: 10 Threading:M3 Outside Diameter: 5mm Length: 35mm | Used to brace the detent pullup system. | Amazon (https://www.amazon.com/gp/product/B07J4SY7BB/ref=ppx_yo_dt_b_search_asin_title?ie=UTF8&psc=1) | $9.99 | Only 3 needed but could only find at a reasonable price for a pack of 10.
1 | M3x40mm Internally Threaded Rod | Uxcell round Aluminum Standoff Pack: 10 Threading:M3 Outside Diameter: 5mm Length: 40mm | Used to brace the detent pullup system's screw pins that run along the detent tabs. | Amazon | $12.99 | Only 1 needed but could only find at a reasonable price for a pack of 10.
1 | M3x40mm Internally Threaded Rod | Xiaoyztan Round Steel Sleeve Pack: 5 Threading:M6 Outside Diameter: 10mm Length: 30mm | Used as the arm for side throttle. | Amazon (https://www.amazon.com/dp/B07SPRRYFS?psc=1&ref=ppx_yo2_dt_b_product_details) | $6.99 | Only 1 needed but could only find at a reasonable price for a pack of 5.
Externally Threaded Rod
1 | M6x40mm Externally Threaded Rod | Smartsails Stainless Steel Fully Threaded Rods Pack: 10 Threading:M6 Length: 40mm | Used to run through and connect the following: Side Throttle Joystick Handle Side Throttle Arm Side Throttle Ball Bearing Holder | Amazon (https://www.amazon.com/dp/B07YB5ZVXR?psc=1&ref=ppx_yo2_dt_b_product_details) | $8.99 | Only 1 needed but could only find at a reasonable price for a pack of 10.
Arcade Joystick Handle
1 | One Option: DIN 319 | Arcade Joystick Handle Pick one an M6 tapped insert of whatever shape you prefer | Used as the grip for the side throttle. | JW Winco (https://www.jwwinco.com/en-us/products/1.1-Operating-with-handles-and-knobs/knobs/DIN-319-Plastic-Ball-Knobs-Tapped-Hole-or-Tapped-Insert-Type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) | $1.22 | I've linked out to the basic option of a plain black plastic knob with a M6 tapped insert that has a diameter of 25mm but I still can't decide what grip I like the most. This site makes great lever grips that work well as arcade stick handles. They range in price and shape but are all of the highest caliber. Although pricey, I really like the brushed metal 25mm knob but the Ergostyle ball handles and domed gear levers feel great too.
Screw Pin
1 | M3x11MM Driveshafts Screw Pin | 10pcs Hard Steel M3 X 3 X 11 X 2.5 Driveshafts Screw Pins for RC Car Upgrade Parts | Used on the ends of the detent pull up bar to slide along the detent tabs. | Amazon (https://www.amazon.com/gp/product/B083R5KBRC/ref=ppx_yo_dt_b_search_asin_title?ie=UTF8&psc=1) | $5.99 | You'll need 2 but cheapest I could find was to buy one of these packs of 10.
Springs
1 | 3HPG3 | Torsion Spring (Package of 6) Spring Length @ Torque: 0.625 in Deflection Angle (Deg.): 90 Leg Length: 1.25 in Max. Rod Outside Dia.: 0.187 in Wind Direction: Left Hand Wire Dia.: 0.035 in Outside Dia.: 0.315 in Torque @ 1/2 Leg Length (In.-Lbs.): 1.071 Number of Coils: 3.25 | Used for the following part: Detent Pullup Grip | Zoro (https://www.zoro.com/zoro-select-torsion-spring-90-deg-0315od-pk6-outside-dia-0315-in-3hpg3/i/G7541195/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) | $4.69 | You can pick a different tension springs if you'd like. These are 1.071 lb at halfway up the leg extension which is quite heavy. If you go lighter or heavier, you just want to make sure it's not too much wider (Wire Diameter x Number of Coils) and that it has a Max. Rod Outside Diameter of 0.187 in or larger. Also, know that you'll need one wind direction left hand and one right hand.
1 | 3HPC7 | Torsion Spring (Package of 6) Spring Length @ Torque: 0.625 in Deflection Angle (Deg.): 90 Leg Length: 1.25 in Max. Rod Outside Dia.: 0.187 in Wind Direction: Right Hand Wire Dia.: 0.035 in Outside Dia.: 0.315 in Torque @ 1/2 Leg Length (In.-Lbs.): 1.071 Number of Coils: 3.25 | Used for the following part: Detent Pullup Grip | Zoro (https://www.zoro.com/zoro-select-torsion-spring-90-deg-0315od-pk6-3hpc7/i/G7452672/?smtrctid=182854773) | $5.16
Filament of your choice
1 Spool |  | ?? | ?? | Amazon? | $25?

Sheet: Fastners
Amount | Part no. | Specification | Description | Potential Seller/Link | Potential Cost | Additional Comments/Notes
Screws
14 | 91292A005 | M2 x 5mm Cap Screws |  | McMaster&Carr (https://www.mcmaster.com/91292A005/) | $14.26
2 | 91305A104 | M2 x 5mm Tapered Screws |  | McMaster&Carr (https://www.mcmaster.com/91305A104/) | $5.94
12 | 91292A833 | M2 x 10mm Cap Screws |  | McMaster&Carr (https://www.mcmaster.com/91292A833/) | $6.75
4 | 91290A047 | M2 x 16mm Cap Screws |  | McMaster&Carr (https://www.mcmaster.com/91290A047/) | $13.03
4 | 90666A102 | M3 x 5mm Cap Screws |  | McMaster&Carr (https://www.mcmaster.com/90666A102/) | $9.78
21 | 93395A198 | M3 x 6mm Tapered Screws |  | McMaster&Carr (https://www.mcmaster.com/93395A198/) | $9.16
2 | 91290A117 | M3 x 8mm Cap Screws |  | McMaster&Carr (https://www.mcmaster.com/91290A117/) | $10.85
5 | 91420A118 | M3 x 8mm Tapered Screws |  | McMaster&Carr (https://www.mcmaster.com/91420A118/) | $2.80
5 | 91294A135 | M3 x 18mm Tapered Screws |  | McMaster&Carr (https://www.mcmaster.com/91294A135/) | $14.47
4 | 91294A210 | M5 x 12mm Tapered Screws |  | McMaster&Carr (https://www.mcmaster.com/91294A210/) | $10.35
2 | 91420A328 | M5 x 20mm Tapered Screws |  | McMaster&Carr (https://www.mcmaster.com/91420A328/) | $6.17
Threaded Inserts
14 | 94180A312 | M2 Threaded Inserts | For adding threading to 3d prints | McMaster&Carr (https://www.mcmaster.com/94180A312/) | $15.04
28 | 94180A331 | M3 Threaded Inserts | " | McMaster&Carr (https://www.mcmaster.com/94180A331/) | $14.71
7 | 94180A361 | M5 Threaded Inserts | " | McMaster&Carr (https://www.mcmaster.com/94180A361/) | $13.69
1 | 94180A371 | M6 Threaded Inserts | " | McMaster&Carr (https://www.mcmaster.com/94180A371/) | $12.19
Nuts
1 | 90576A104 | M5 Lock Nut |  | McMaster&Carr (https://www.mcmaster.com/90576A104/) | $6.14
Washers
1 | a15112300ux0387 | M2 x 4 x .5 mm Vulcanized Fiber Washers | uxcell a15112300ux0387 2mmx4mmx0.5mm Fiber Motherboard Insulating Washers Spacer Red Pack of 100 | Amazon (https://www.amazon.com/gp/product/B01ARADX88/ref=ppx_yo_dt_b_search_asin_title?ie=UTF8&psc=1) | $3.58 | Only 24 needed for hat switch board insulation.
1 | A19030600ux0431 | M3 x 8 x .5 mm Vulcanized Fiber Washers | uxcell Insulating Washer 500Pcs 3mm x 8mm x 0.5mm Red Vulcanized Fiber Washer, Insulation Gasket for Motherboard | Amazon (https://www.amazon.com/gp/product/B07R8CH9BL/ref=sw_img_1?smid=A1THAZDOWP300U&psc=1) | $5.49 | Only 16 needed for Main Control Board and Grip Bridge Board insulation.
1 | 786705352841 | M3 x 5 x .3 mm Washers (Steel) | 3mm RC Shim Spacer Washer Stainless Steel Pack of 50 (3x5x0.3) | Amazon (https://www.amazon.com/gp/product/B08ZYKYZH9/ref=ppx_yo_dt_b_search_asin_title?ie=UTF8&th=1) | $4.99
