ImArchimedes/WilsonThrust510/Documentation/Other Helpful Docs/Doc Images/Print Orientation Thumbs/Main Throttle_Grip_Parts_Bt Screw Cover_Thm2.jpg

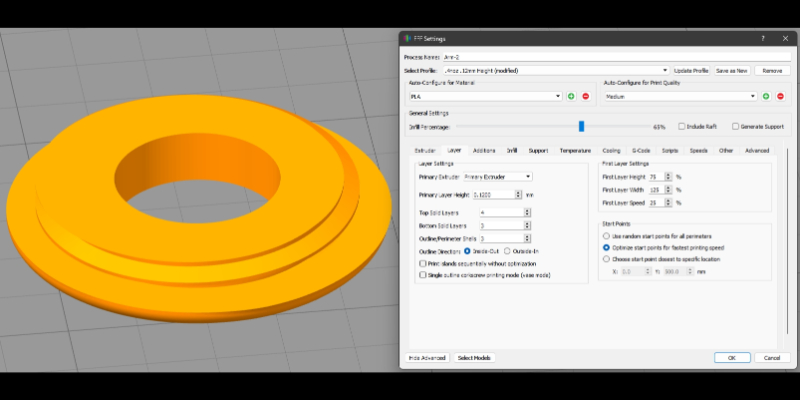
Documentation/Other Helpful Docs/Doc Images/Print Orientation Thumbs/Main Throttle_Grip_Parts_Bt Screw Cover_Thm2.jpg
