ImArchimedes/WilsonThrust510/Documentation/Other Helpful Docs/Doc Images/Print Orientation Thumbs/Main Throttle_Grip_Parts_Hat Gate_2way Gate.jpg

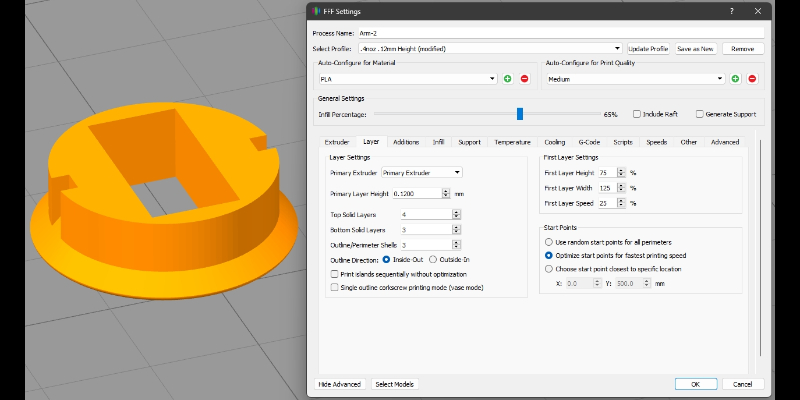
Documentation/Other Helpful Docs/Doc Images/Print Orientation Thumbs/Main Throttle_Grip_Parts_Hat Gate_2way Gate.jpg
