ImArchimedes/WilsonThrust510/Documentation/Other Helpful Docs/Doc Images/Print Orientation Thumbs/Main Throttle_Grip_Parts_Hat Gate_4way Gate_x3.jpg

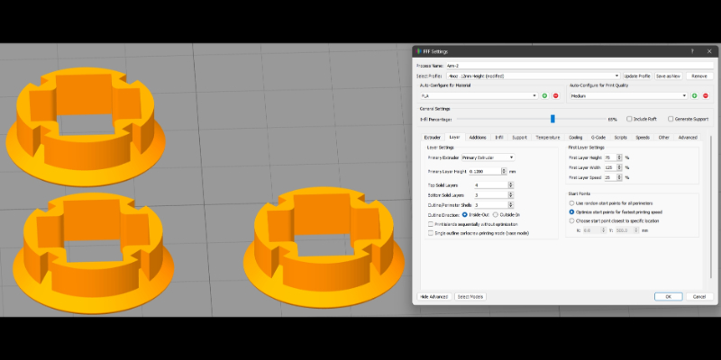
Documentation/Other Helpful Docs/Doc Images/Print Orientation Thumbs/Main Throttle_Grip_Parts_Hat Gate_4way Gate_x3.jpg
