ImArchimedes/WilsonThrust510/Documentation/Other Helpful Docs/Doc Images/Video Thumbnails/Wilson Thrust Tutorial - III - Assembly - B - Box Bot - 02 - Glued Parts.jpg

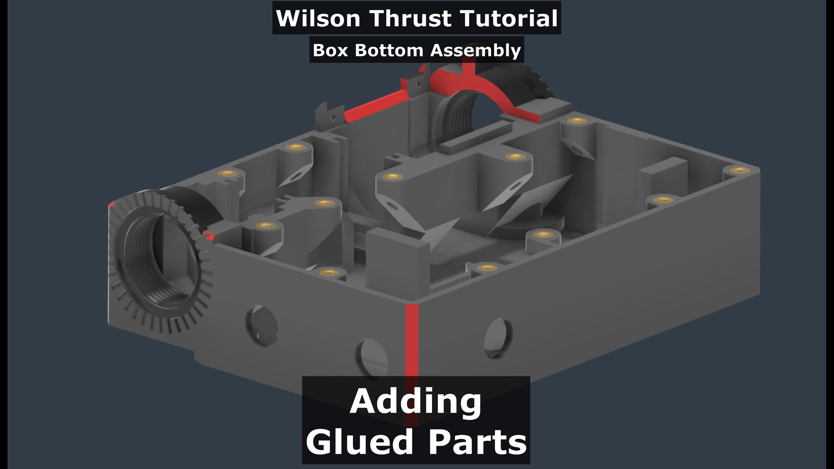
Documentation/Other Helpful Docs/Doc Images/Video Thumbnails/Wilson Thrust Tutorial - III - Assembly - B - Box Bot - 02 - Glued Parts.jpg
