ImArchimedes/WilsonThrust510/Print Files/Current/01 - Main Throttle/Arm/Main Throttle_Arm_Detent Paddle_Arm Right.3mf

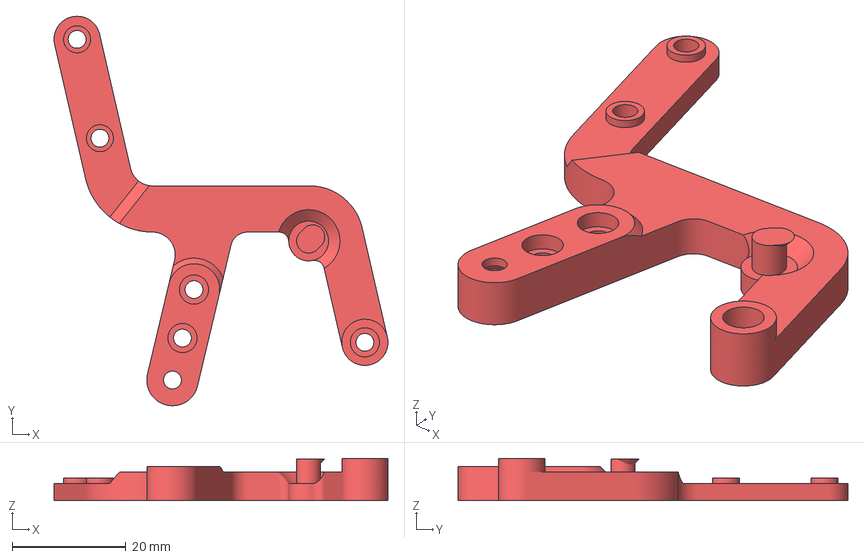
[picture p48: CAD file, 2023-05-22]
Print Files/Current/01 - Main Throttle/Arm/Main Throttle_Arm_Detent Paddle_Arm Right.3mf
58.7 x 68.5 x 7.44 mm
