ImArchimedes/WilsonThrust510/Print Files/Current/01 - Main Throttle/Grip/Input Caps/FFF or Resin/Main Throttle_Grip_Input Caps_FFF or Resin_Slider.3mf

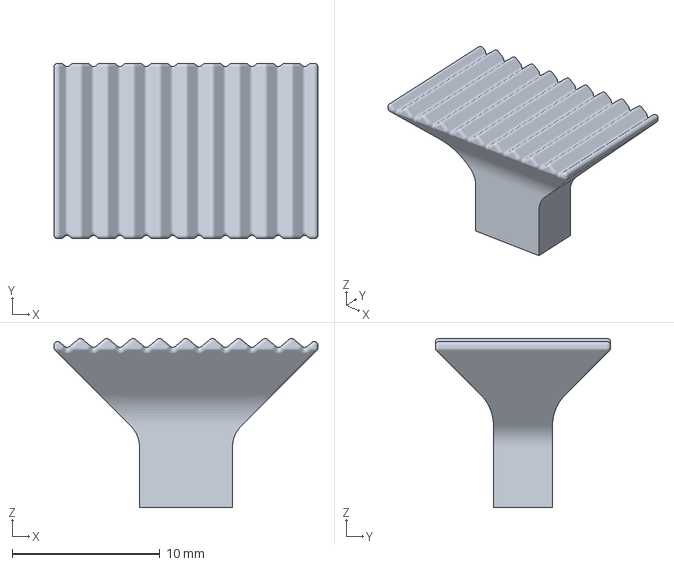
[picture p49: CAD file, 2023-05-22]
Print Files/Current/01 - Main Throttle/Grip/Input Caps/FFF or Resin/Main Throttle_Grip_Input Caps_FFF or Resin_Slider.3mf
17.9 x 11.9 x 11.4 mm
