ImArchimedes/WilsonThrust510/Print Files/Current/01 - Main Throttle/Grip/Input Caps/FFF/3way hat/Main Throttle_Grip_Input Caps_FFF_3way Hat_Trim.3mf

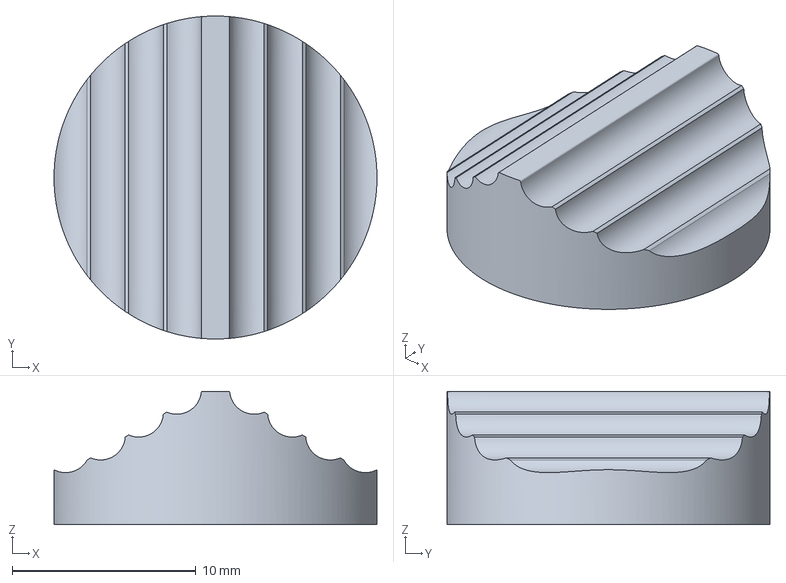
[picture p50: CAD file, 2023-05-22]
Print Files/Current/01 - Main Throttle/Grip/Input Caps/FFF/3way hat/Main Throttle_Grip_Input Caps_FFF_3way Hat_Trim.3mf
17.6 x 17.6 x 7.27 mm
