ImArchimedes/WilsonThrust510/Print Files/Current/01 - Main Throttle/Grip/Input Caps/FFF/5way Hat/Main Throttle_Grip_Input Caps_FFF_5way Hat_Round Pyramid.3mf

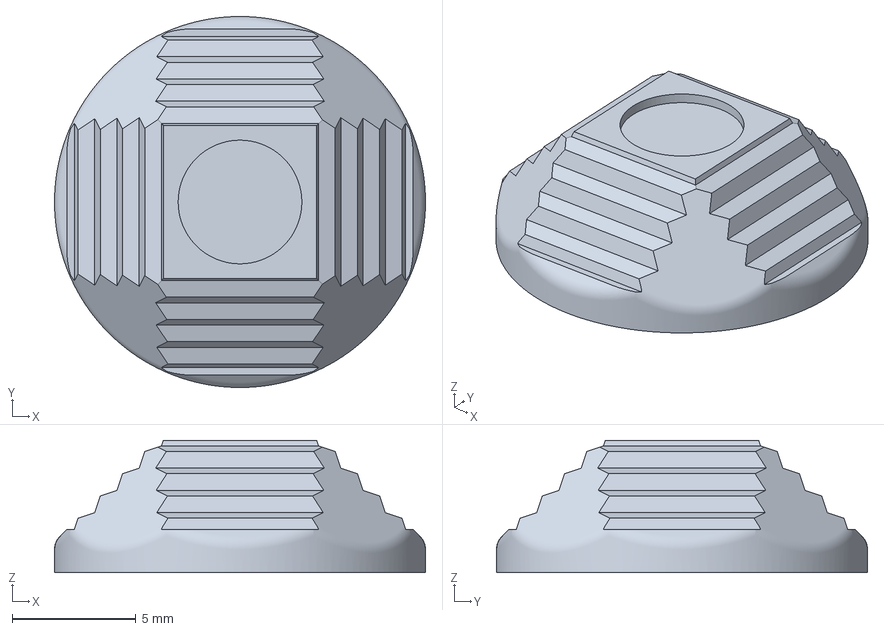
[picture p51: CAD file, 2023-05-22]
Print Files/Current/01 - Main Throttle/Grip/Input Caps/FFF/5way Hat/Main Throttle_Grip_Input Caps_FFF_5way Hat_Round Pyramid.3mf
15.0 x 15.0 x 5.35 mm
