ImArchimedes/WilsonThrust510/Print Files/Current/01 - Main Throttle/Grip/Input Caps/FFF/HatEnc/Main Throttle_Grip_Input Caps_FFF_HatEnc_Gripping Stepped Dome.3mf

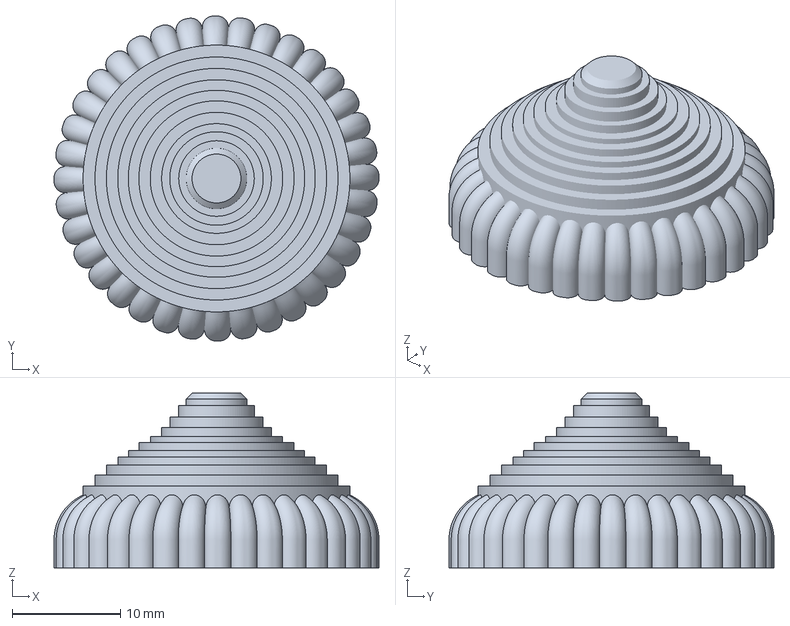
[picture p52: CAD file, 2023-05-22]
Print Files/Current/01 - Main Throttle/Grip/Input Caps/FFF/HatEnc/Main Throttle_Grip_Input Caps_FFF_HatEnc_Gripping Stepped Dome.3mf
30.0 x 30.0 x 16.2 mm
