ImArchimedes/WilsonThrust510/Print Files/Current/01 - Main Throttle/Grip/Input Caps/FFF/Main Throttle_Grip_Input Caps_FFF_Square Stem Brace_x4.3mf

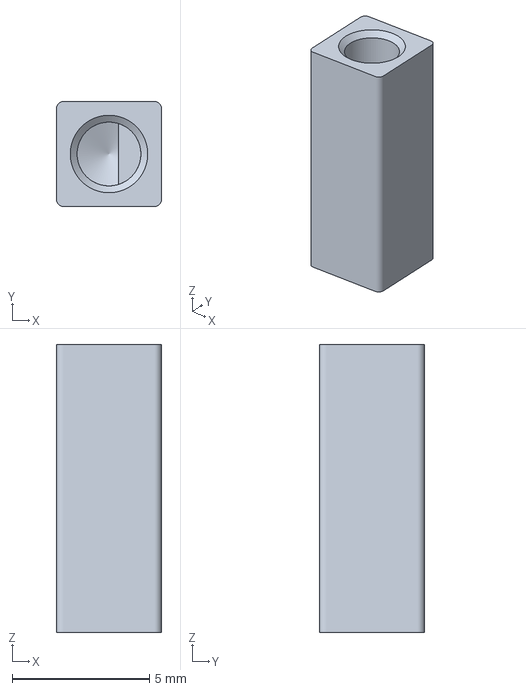
[picture p54: CAD file, 2023-05-22]
Print Files/Current/01 - Main Throttle/Grip/Input Caps/FFF/Main Throttle_Grip_Input Caps_FFF_Square Stem Brace_x4.3mf
3.83 x 3.83 x 10.5 mm
