ImArchimedes/WilsonThrust510/Print Files/Current/01 - Main Throttle/Grip/Input Caps/Resin/3way Hat/Main Throttle_Grip_Input Caps_Resin_3way Hat_Trim.3mf

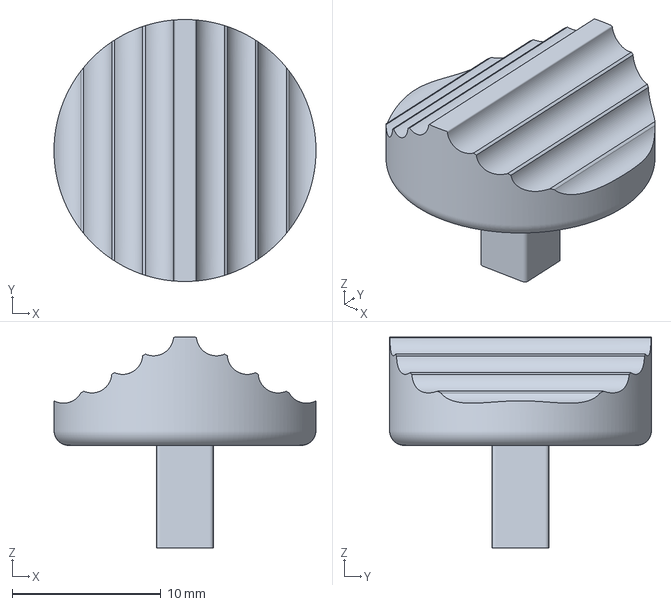
[picture p55: CAD file, 2023-05-22]
Print Files/Current/01 - Main Throttle/Grip/Input Caps/Resin/3way Hat/Main Throttle_Grip_Input Caps_Resin_3way Hat_Trim.3mf
17.6 x 17.6 x 14.1 mm
