ImArchimedes/WilsonThrust510/Print Files/Current/01 - Main Throttle/Grip/Input Caps/Resin/5way Hat/Main Throttle_Grip_Input Caps_Resin_5way Hat_Edged Dome.3mf

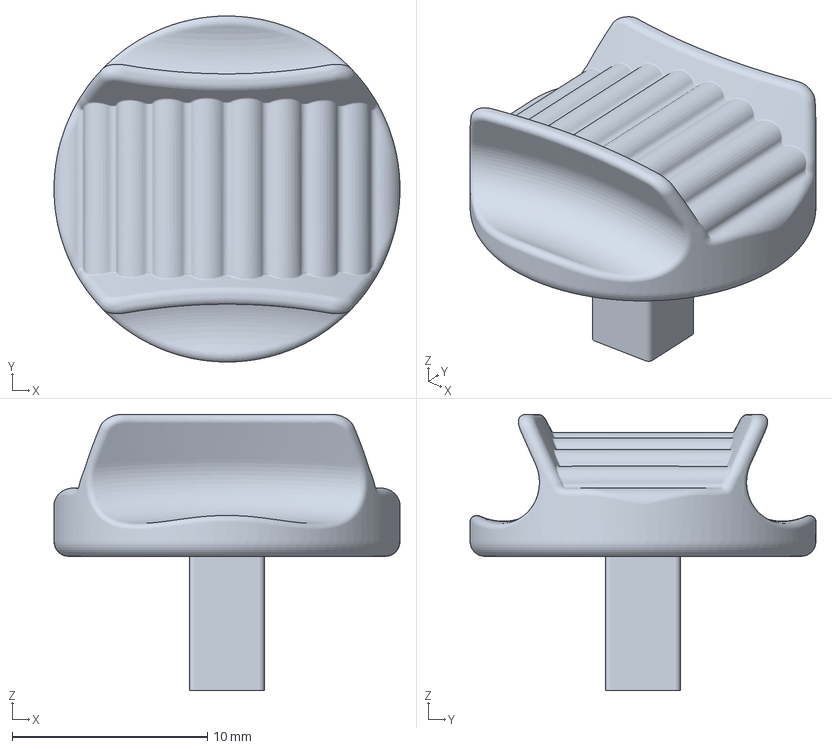
[picture p56: CAD file, 2023-07-05]
Print Files/Current/01 - Main Throttle/Grip/Input Caps/Resin/5way Hat/Main Throttle_Grip_Input Caps_Resin_5way Hat_Edged Dome.3mf
17.7 x 17.7 x 14.1 mm
