ImArchimedes/WilsonThrust510/Print Files/Current/01 - Main Throttle/Grip/Input Caps/Resin/Kailh/Main Throttle_Grip_Input Caps_Resin_Kailh_Thm3.3mf

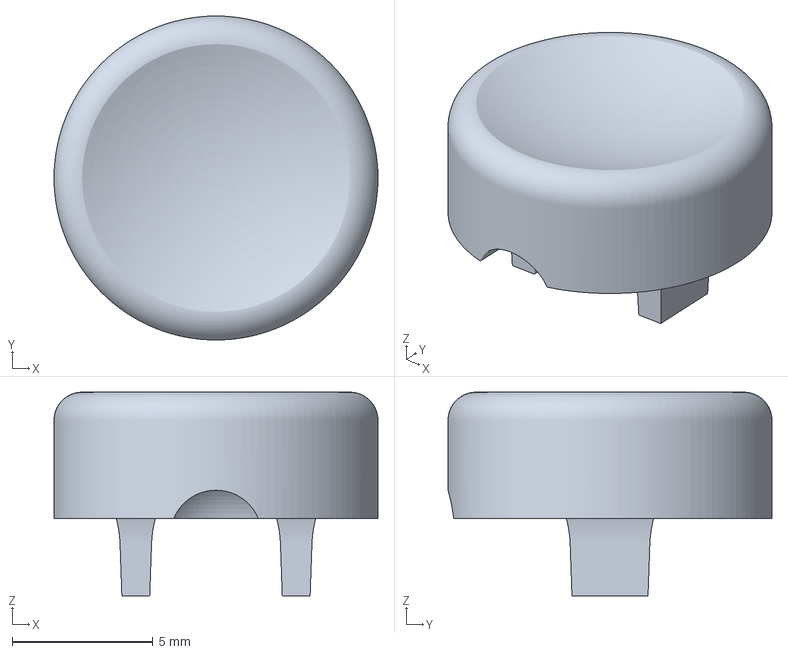
[picture p57: CAD file, 2023-05-22]
Print Files/Current/01 - Main Throttle/Grip/Input Caps/Resin/Kailh/Main Throttle_Grip_Input Caps_Resin_Kailh_Thm3.3mf
11.5 x 11.5 x 7.23 mm
