ImArchimedes/WilsonThrust510/Print Files/Current/01 - Main Throttle/Grip/Parts/Hat Gates/Main Throttle_Grip_Parts_Hat Gate_2way Gate.3mf

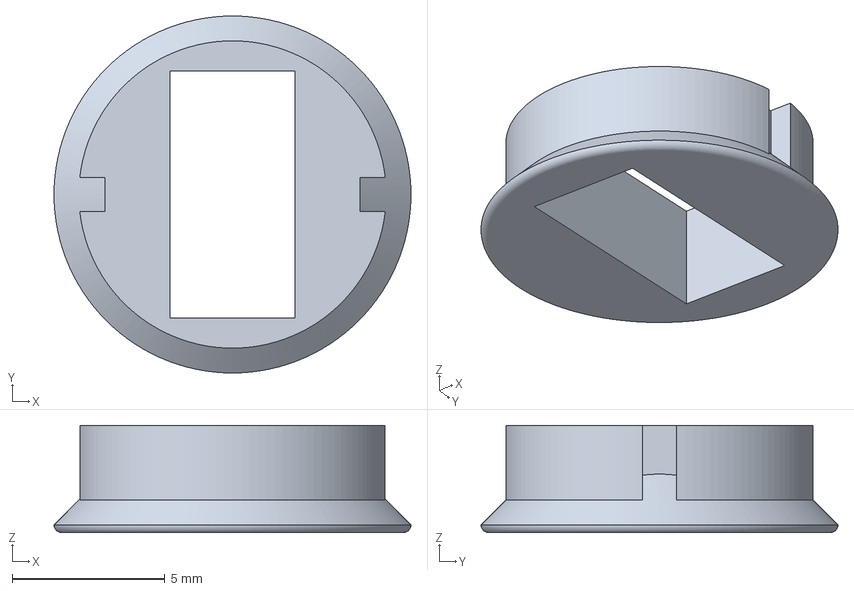
[picture p58: CAD file, 2023-05-22]
Print Files/Current/01 - Main Throttle/Grip/Parts/Hat Gates/Main Throttle_Grip_Parts_Hat Gate_2way Gate.3mf
11.7 x 11.7 x 3.50 mm
