ImArchimedes/WilsonThrust510/Print Files/Current/01 - Main Throttle/Grip/Parts/Main Throttle_Grip_Parts_Kailh Mnt Insert_x5.3mf

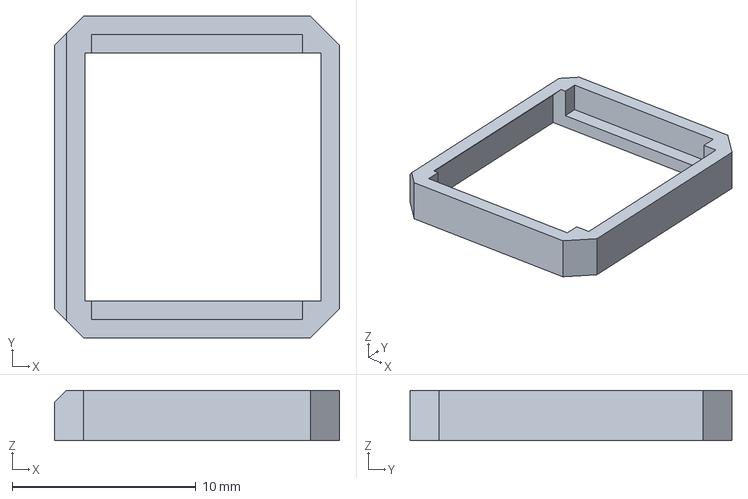
[picture p59: CAD file, 2023-05-22]
Print Files/Current/01 - Main Throttle/Grip/Parts/Main Throttle_Grip_Parts_Kailh Mnt Insert_x5.3mf
15.5 x 17.5 x 2.72 mm
