ImArchimedes/WilsonThrust510/Print Files/Current/01 - Main Throttle/Grip/Shells/Main Throttle_Grip_Shells_Front Block.3mf

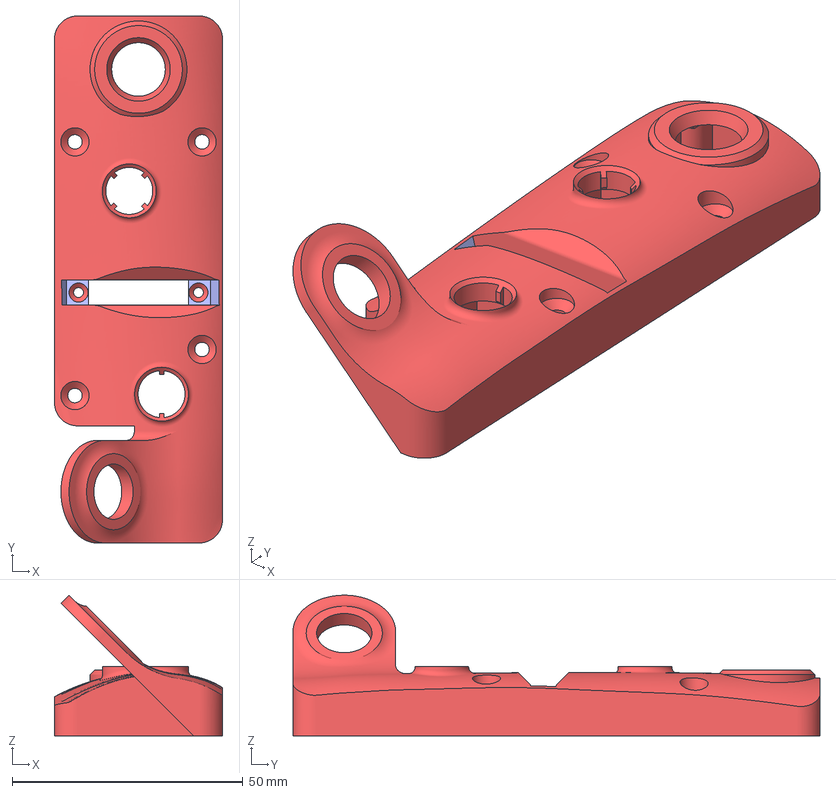
[picture p60: CAD file, 2023-05-22]
Print Files/Current/01 - Main Throttle/Grip/Shells/Main Throttle_Grip_Shells_Front Block.3mf
36.4 x 114.2 x 30.5 mm
