ImArchimedes/WilsonThrust510/Print Files/Current/03 - Friction Adjustment/Friction Adjustment_Right Main Throttle_Post.3mf

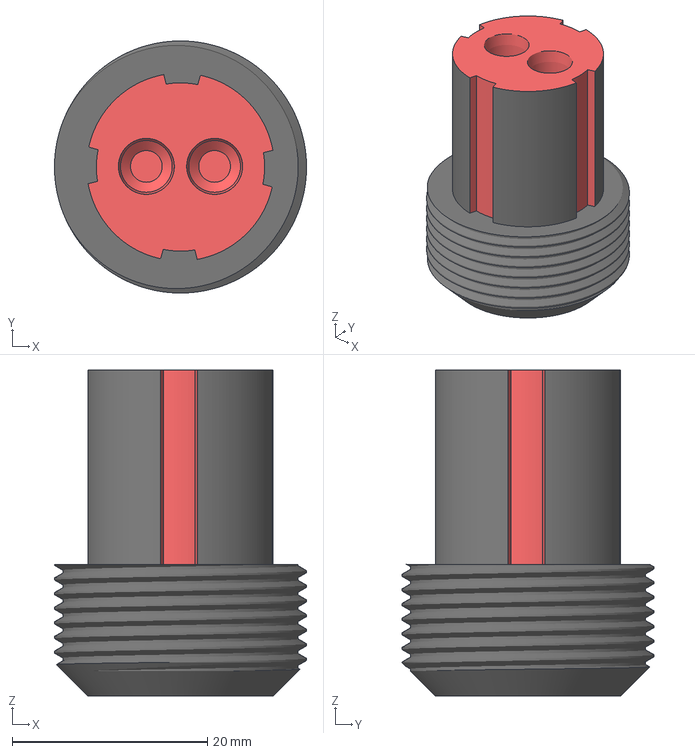
[picture p61: CAD file, 2023-05-22]
Print Files/Current/03 - Friction Adjustment/Friction Adjustment_Right Main Throttle_Post.3mf
25.8 x 25.8 x 33.4 mm
