ImArchimedes/WilsonThrust510/Print Files/Current/01 - Main Throttle/Arm/Main Throttle_Arm_Arm.3mf

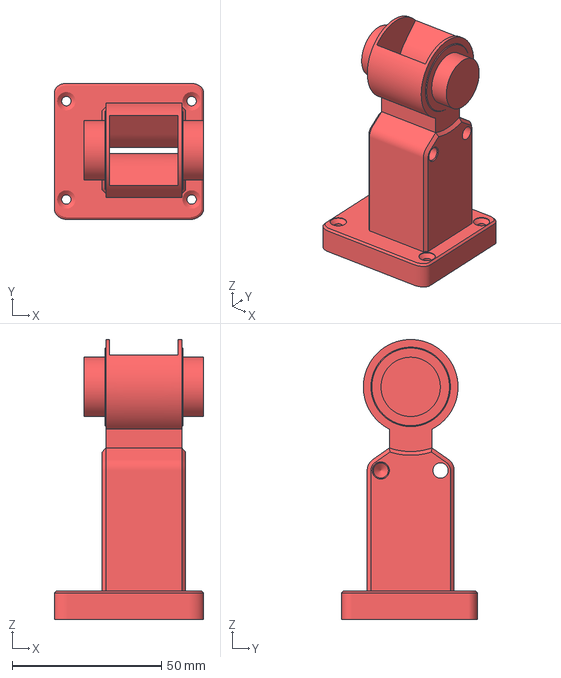
[picture p62: CAD file, 2023-05-22]
Print Files/Current/01 - Main Throttle/Arm/Main Throttle_Arm_Arm.3mf
50.0 x 45.7 x 93.8 mm
