ImArchimedes/WilsonThrust510/Print Files/Current/01 - Main Throttle/Grip/Input Caps/FFF or Resin/Main Throttle_Grip_Input Caps_FFF or Resin_Joystick Cap.3mf

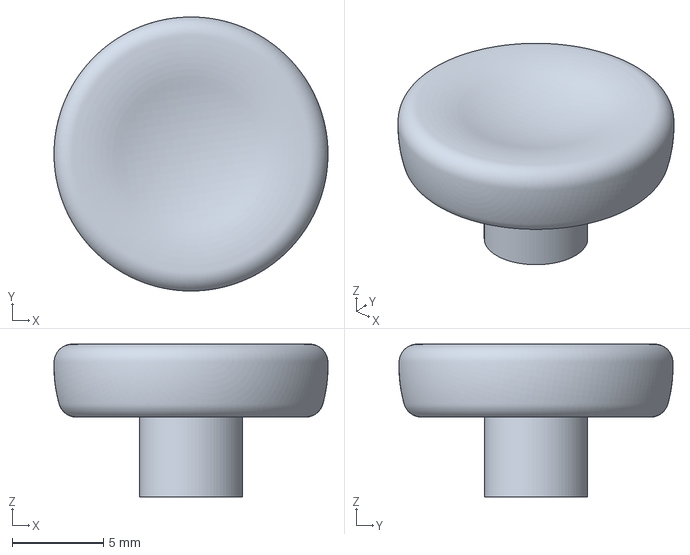
[picture p63: CAD file, 2023-05-22]
Print Files/Current/01 - Main Throttle/Grip/Input Caps/FFF or Resin/Main Throttle_Grip_Input Caps_FFF or Resin_Joystick Cap.3mf
15.0 x 15.0 x 8.36 mm
