ImArchimedes/WilsonThrust510/Print Files/Current/01 - Main Throttle/Grip/Shells/Main Throttle_Grip_Shells_Sm Side.3mf

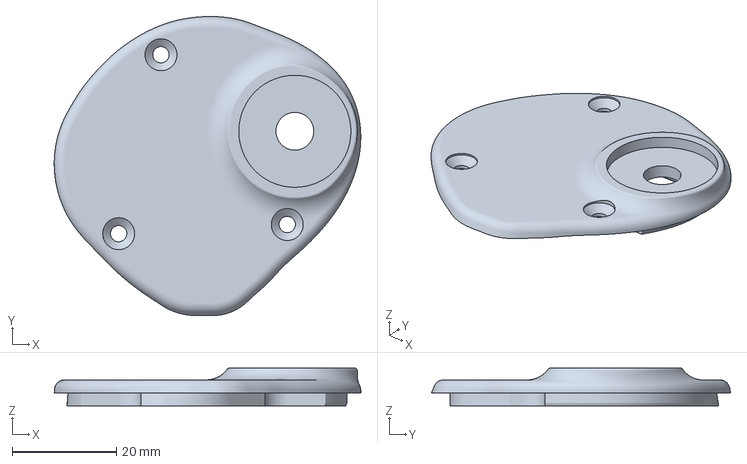
[picture p68: CAD file, 2023-05-22]
Print Files/Current/01 - Main Throttle/Grip/Shells/Main Throttle_Grip_Shells_Sm Side.3mf
58.8 x 57.4 x 7.25 mm
