ImArchimedes/WilsonThrust510/Print Files/Current/01 - Main Throttle/Grip/Input Caps/FFF/5way Hat/Main Throttle_Grip_Input Caps_FFF_5way Hat_Edge Dome.3mf

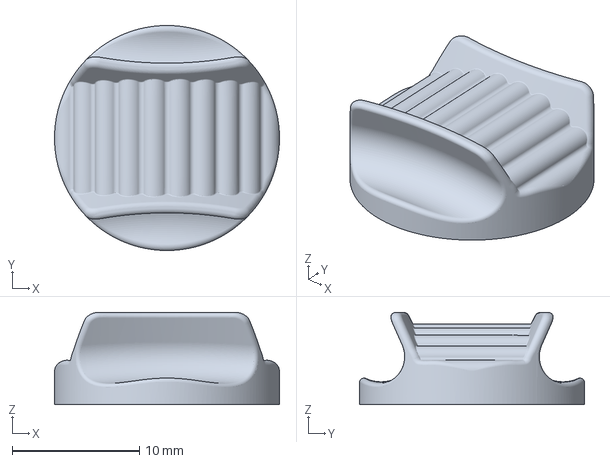
[picture p69: CAD file, 2023-05-22]
Print Files/Current/01 - Main Throttle/Grip/Input Caps/FFF/5way Hat/Main Throttle_Grip_Input Caps_FFF_5way Hat_Edge Dome.3mf
17.7 x 17.7 x 7.27 mm
