ImArchimedes/WilsonThrust510/Print Files/Current/01 - Main Throttle/Grip/Input Caps/FFF/Kailh/Main Throttle_Grip_Input Caps_FFF_Kailh_Thm2.3mf

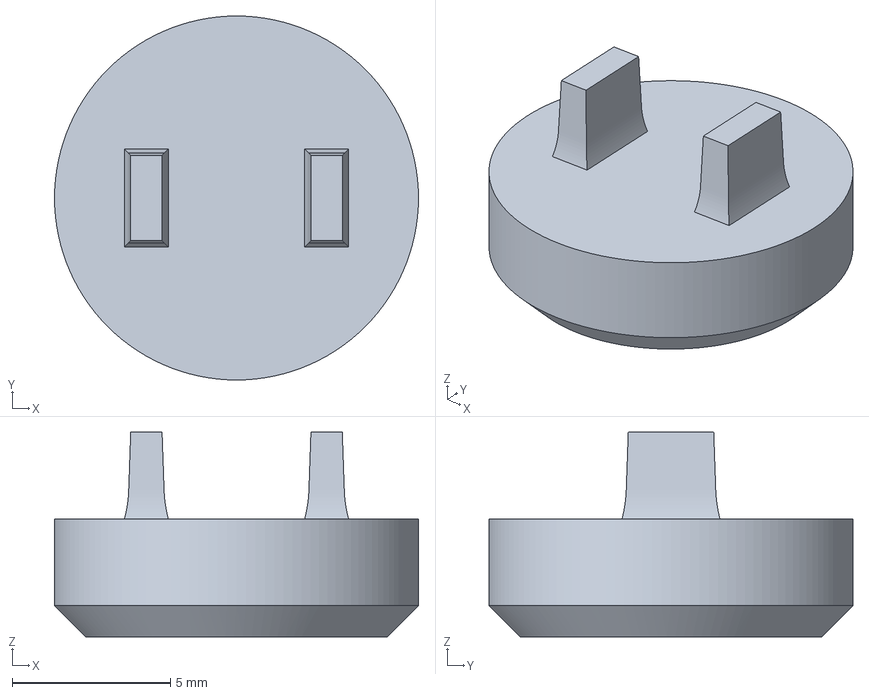
[picture p70: CAD file, 2023-05-22]
Print Files/Current/01 - Main Throttle/Grip/Input Caps/FFF/Kailh/Main Throttle_Grip_Input Caps_FFF_Kailh_Thm2.3mf
11.5 x 11.5 x 6.47 mm
