ImArchimedes/WilsonThrust510/Print Files/Current/01 - Main Throttle/Grip/Input Caps/Resin/Kailh/Main Throttle_Grip_Input Caps_Resin_Kailh_Thm2.3mf

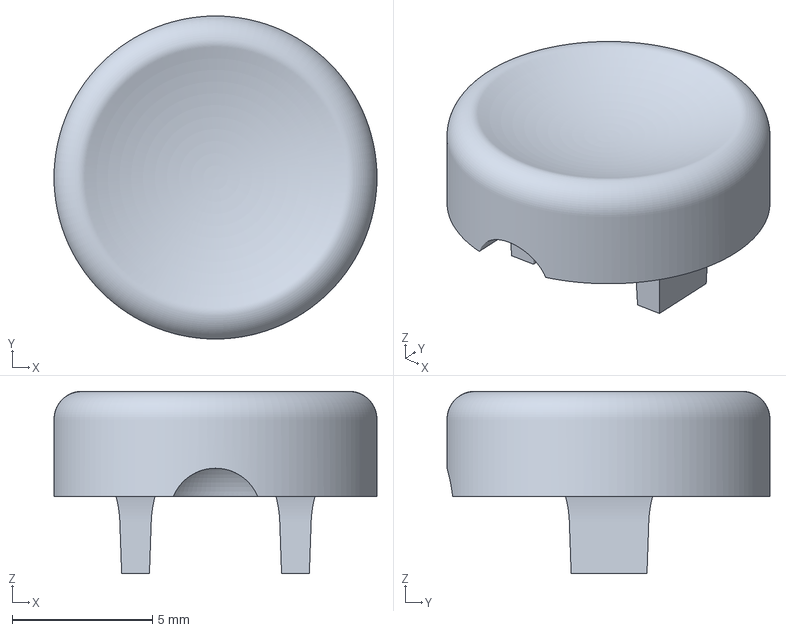
[picture p72: CAD file, 2023-05-22]
Print Files/Current/01 - Main Throttle/Grip/Input Caps/Resin/Kailh/Main Throttle_Grip_Input Caps_Resin_Kailh_Thm2.3mf
11.5 x 11.5 x 6.48 mm
