ImArchimedes/WilsonThrust510/Print Files/Current/01 - Main Throttle/Grip/Shells/Main Throttle_Grip_Shells_Big End.3mf

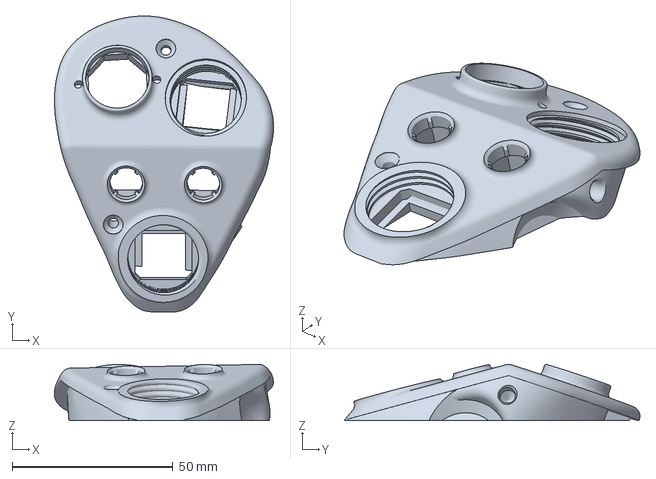
[picture p73: CAD file, 2023-05-22]
Print Files/Current/01 - Main Throttle/Grip/Shells/Main Throttle_Grip_Shells_Big End.3mf
68.1 x 92.1 x 17.5 mm
