ImArchimedes/WilsonThrust510/Print Files/Current/01 - Main Throttle/Arm/Main Throttle_Arm_Detent Paddle_Grip.3mf

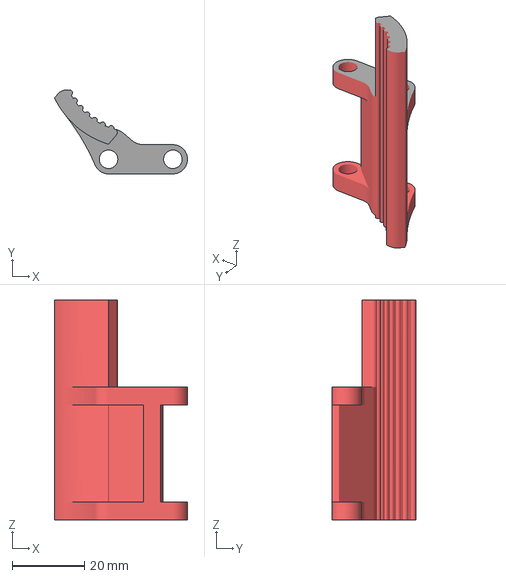
[picture p74: CAD file, 2023-05-22]
Print Files/Current/01 - Main Throttle/Arm/Main Throttle_Arm_Detent Paddle_Grip.3mf
36.9 x 23.3 x 61.0 mm
