ImArchimedes/WilsonThrust510/Print Files/Current/01 - Main Throttle/Grip/Input Caps/FFF/5way Hat/Main Throttle_Grip_Input Caps_FFF_5way Hat_Walled Dome.3mf

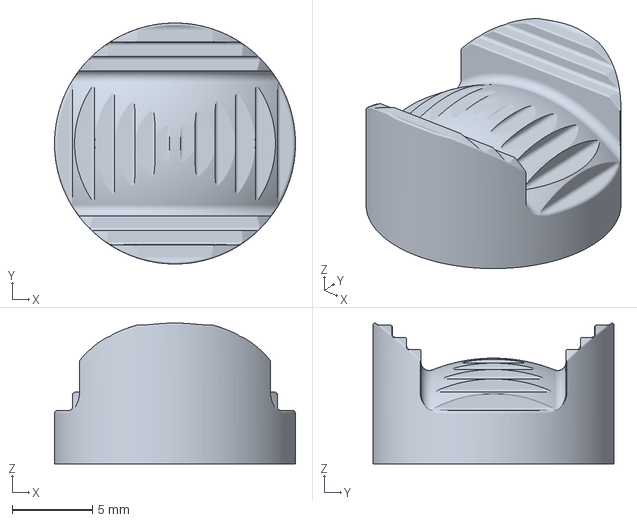
[picture p75: CAD file, 2023-05-22]
Print Files/Current/01 - Main Throttle/Grip/Input Caps/FFF/5way Hat/Main Throttle_Grip_Input Caps_FFF_5way Hat_Walled Dome.3mf
15.0 x 15.0 x 8.78 mm
