ImArchimedes/WilsonThrust510/Print Files/Current/01 - Main Throttle/Grip/Input Caps/FFF/Kailh/Main Throttle_Grip_Input Caps_FFF_Kailh_Palm.3mf

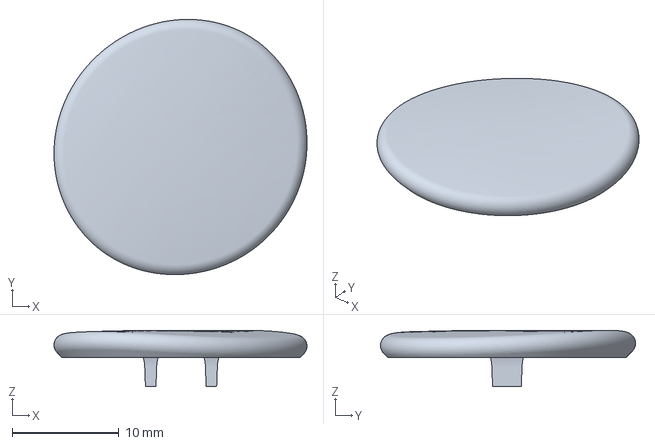
[picture p76: CAD file, 2023-05-22]
Print Files/Current/01 - Main Throttle/Grip/Input Caps/FFF/Kailh/Main Throttle_Grip_Input Caps_FFF_Kailh_Palm.3mf
23.7 x 23.9 x 5.28 mm
