ImArchimedes/WilsonThrust510/Print Files/Current/01 - Main Throttle/Grip/Input Caps/Resin/5way Hat/Main Throttle_Grip_Input Caps_Resin_5way Hat_Walled Dome.3mf

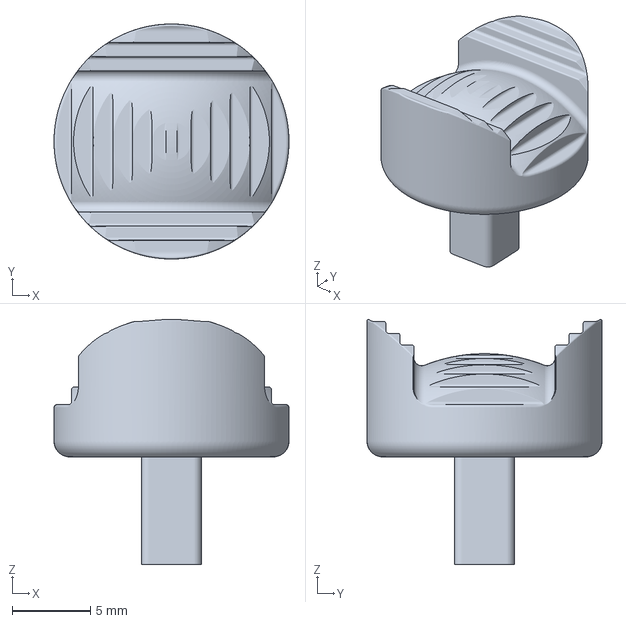
[picture p77: CAD file, 2023-05-22]
Print Files/Current/01 - Main Throttle/Grip/Input Caps/Resin/5way Hat/Main Throttle_Grip_Input Caps_Resin_5way Hat_Walled Dome.3mf
15.0 x 15.0 x 15.7 mm
