ImArchimedes/WilsonThrust510/Print Files/Current/01 - Main Throttle/Grip/Input Caps/Resin/Kailh/Main Throttle_Grip_Input Caps_Resin_Kailh_Thm1.3mf

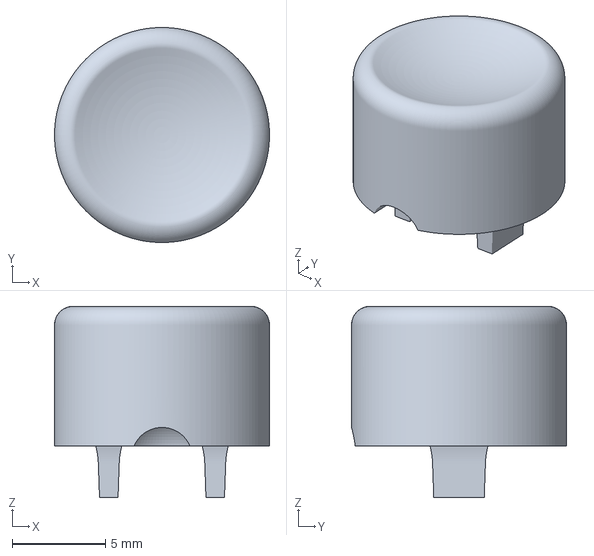
[picture p78: CAD file, 2023-05-22]
Print Files/Current/01 - Main Throttle/Grip/Input Caps/Resin/Kailh/Main Throttle_Grip_Input Caps_Resin_Kailh_Thm1.3mf
11.5 x 11.5 x 10.2 mm
