ImArchimedes/WilsonThrust510/Print Files/Current/01 - Main Throttle/Grip/Input Caps/FFF/Kailh/Main Throttle_Grip_Input Caps_FFF_Kailh_Thm3.3mf

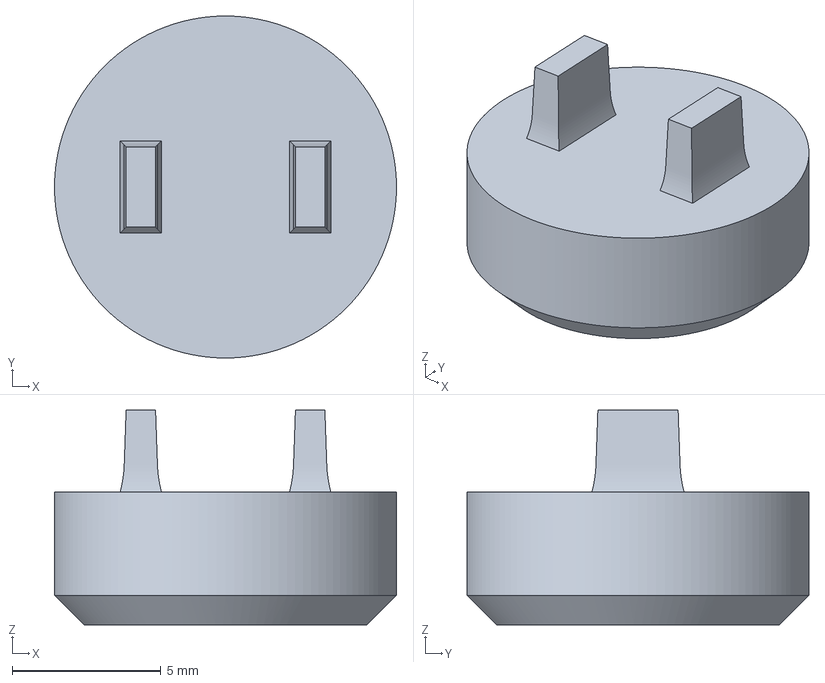
[picture p79: CAD file, 2023-05-22]
Print Files/Current/01 - Main Throttle/Grip/Input Caps/FFF/Kailh/Main Throttle_Grip_Input Caps_FFF_Kailh_Thm3.3mf
11.5 x 11.5 x 7.22 mm
