ImArchimedes/WilsonThrust510/Print Files/Current/02 - Side Throttle/Side Throttle_Axle Locking Grip.3mf

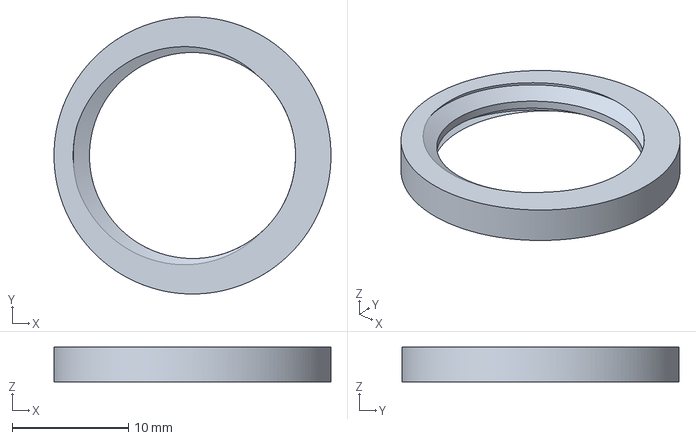
[picture p81: CAD file, 2023-05-22]
Print Files/Current/02 - Side Throttle/Side Throttle_Axle Locking Grip.3mf
23.8 x 23.8 x 3.00 mm
