ImArchimedes/WilsonThrust510/Print Files/Current/04 - Box Top/Box Top_Button Grid_Holder.3mf

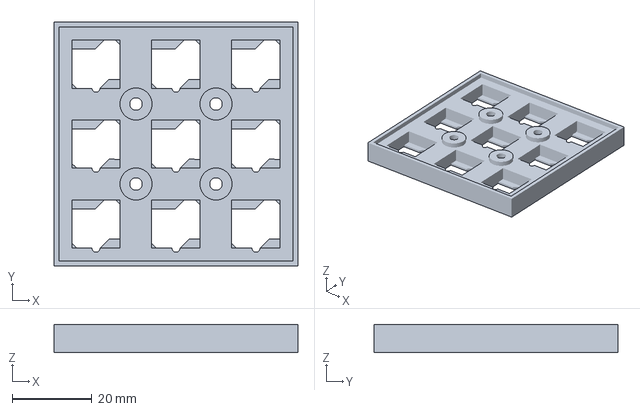
[picture p82: CAD file, 2023-05-22]
Print Files/Current/04 - Box Top/Box Top_Button Grid_Holder.3mf
61.0 x 61.0 x 7.05 mm
