ImArchimedes/WilsonThrust510/Print Files/Current/05 - Box Bottom/Box Bottom_Box Bottom.3mf

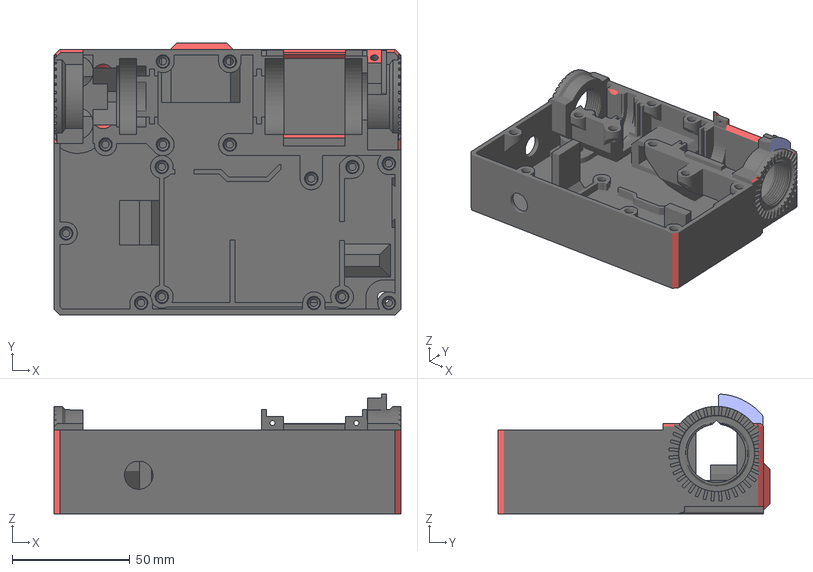
[picture p83: CAD file, 2023-07-28]
Print Files/Current/05 - Box Bottom/Box Bottom_Box Bottom.3mf
147.5 x 115.7 x 51.0 mm
