ImArchimedes/WilsonThrust510/Print Files/Current/06 - Detents/Detents_Cosmo Sim_Bump_x2.3mf

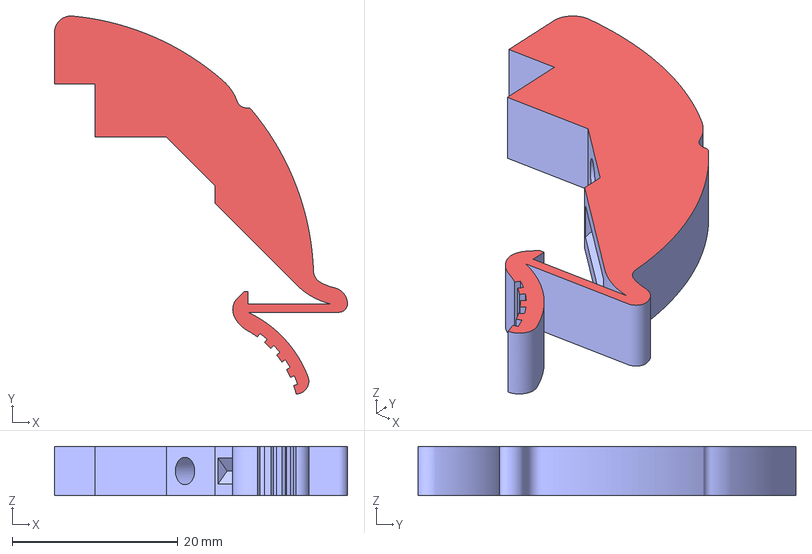
[picture p84: CAD file, 2023-05-22]
Print Files/Current/06 - Detents/Detents_Cosmo Sim_Bump_x2.3mf
35.4 x 45.6 x 5.92 mm
