ImArchimedes/WilsonThrust510/Print Files/Current/02 - Side Throttle/Side Throttle_Axle Bearing.3mf

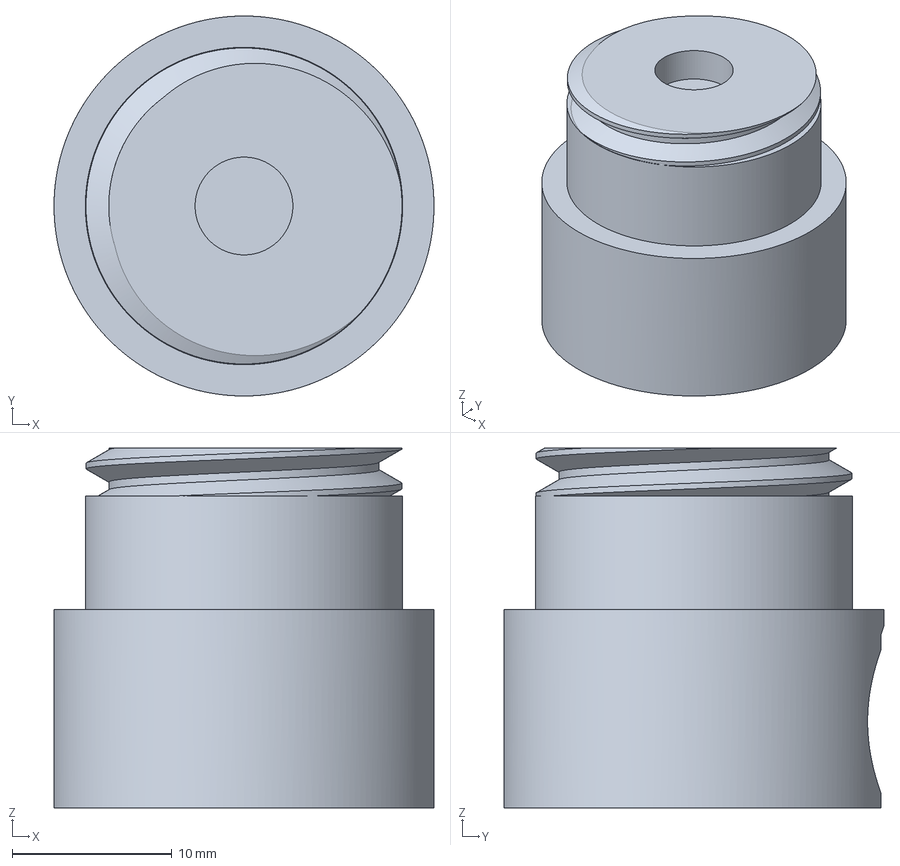
[picture p85: CAD file, 2023-05-22]
Print Files/Current/02 - Side Throttle/Side Throttle_Axle Bearing.3mf
23.8 x 23.8 x 22.5 mm
