ImArchimedes/WilsonThrust510/Print Files/Current/03 - Friction Adjustment/Friction Adjustment_Grip_x2.3mf

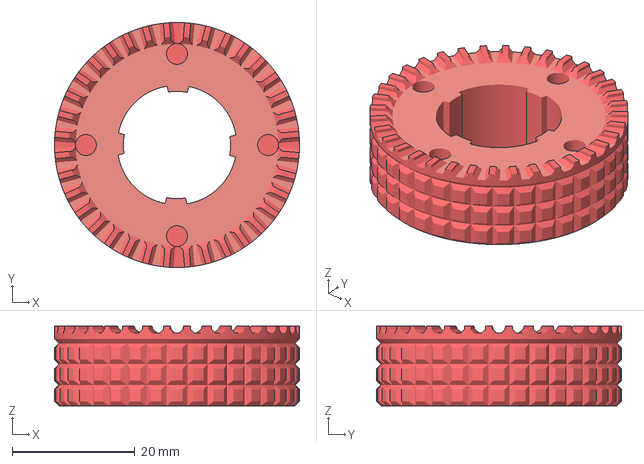
[picture p86: CAD file, 2023-05-22]
Print Files/Current/03 - Friction Adjustment/Friction Adjustment_Grip_x2.3mf
40.0 x 40.0 x 13.0 mm
