ImArchimedes/WilsonThrust510/Print Files/Current/04 - Box Top/Box Top_Button Grid_Brace.3mf

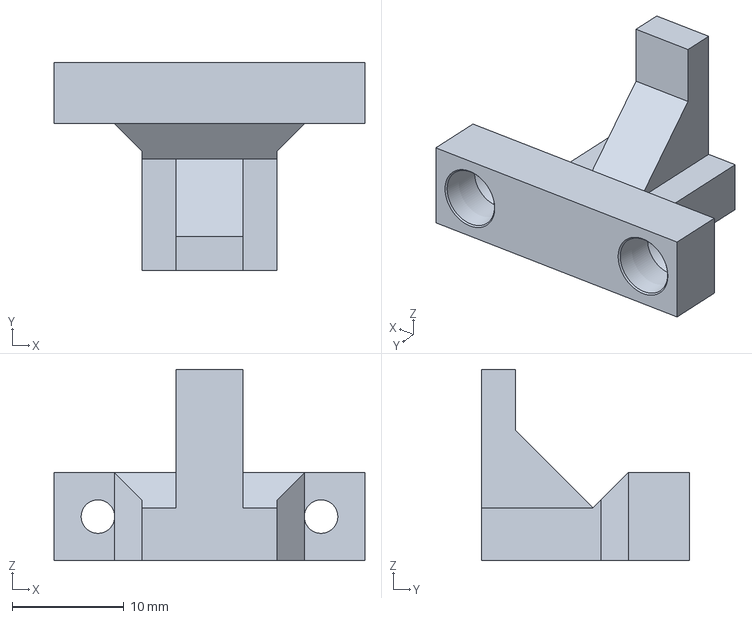
[picture p87: CAD file, 2023-05-22]
Print Files/Current/04 - Box Top/Box Top_Button Grid_Brace.3mf
27.9 x 18.7 x 17.1 mm
