ImArchimedes/WilsonThrust510/Print Files/Current/05 - Box Bottom/Box Bottom_Panic Button_Mount.3mf

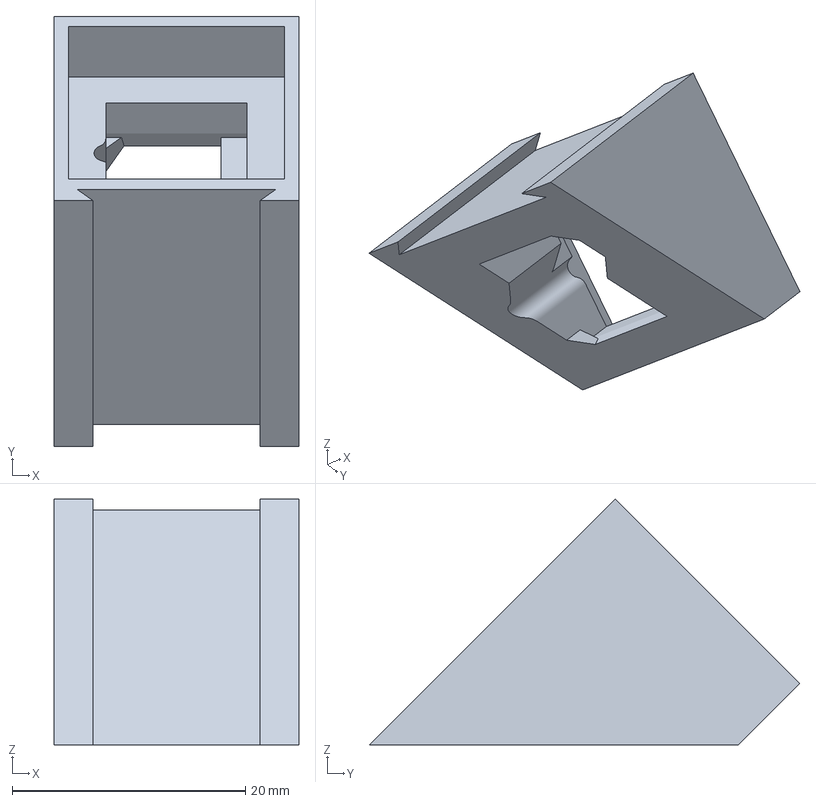
[picture p88: CAD file, 2023-05-22]
Print Files/Current/05 - Box Bottom/Box Bottom_Panic Button_Mount.3mf
21.0 x 36.9 x 21.1 mm
