ImArchimedes/WilsonThrust510/Print Files/Current/06 - Detents/Detents_Blank_x2.3mf

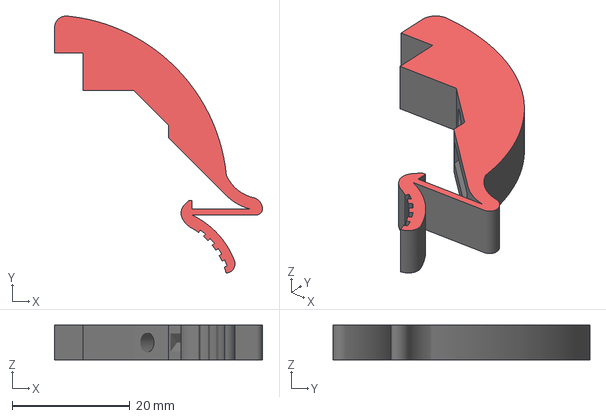
[picture p89: CAD file, 2023-05-22]
Print Files/Current/06 - Detents/Detents_Blank_x2.3mf
35.4 x 43.7 x 5.92 mm
