ImArchimedes/WilsonThrust510/Print Files/Current/03 - Friction Adjustment/Friction Adjustment_Stopper_x2.3mf

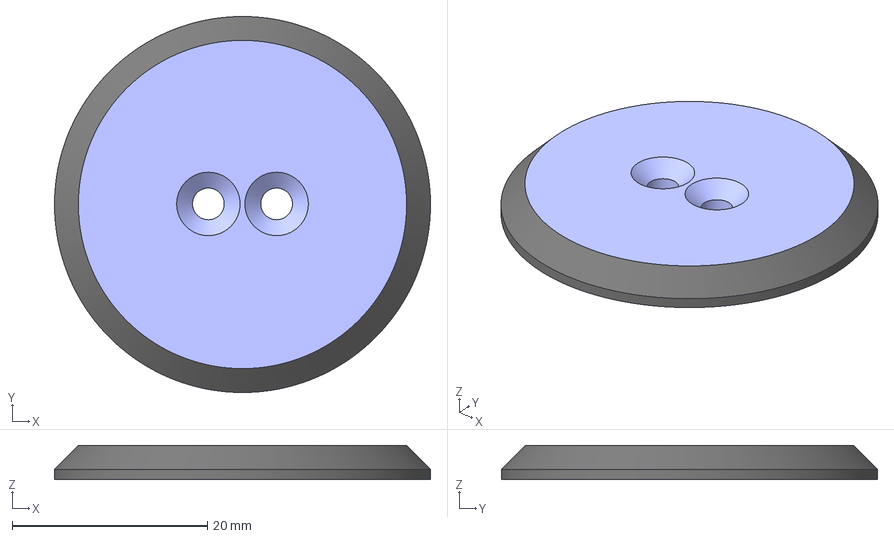
[picture p90: CAD file, 2023-05-22]
Print Files/Current/03 - Friction Adjustment/Friction Adjustment_Stopper_x2.3mf
38.6 x 38.6 x 3.50 mm
