ImArchimedes/WilsonThrust510/Print Files/Current/04 - Box Top/Box Top_Box Top.3mf

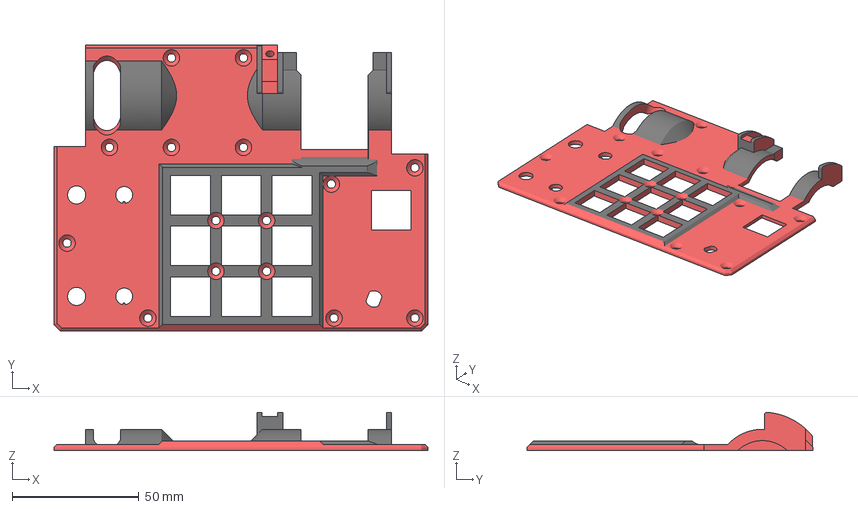
[picture p91: CAD file, 2023-05-22]
Print Files/Current/04 - Box Top/Box Top_Box Top.3mf
147.5 x 112.9 x 15.1 mm
