ImArchimedes/WilsonThrust510/Print Files/Current/05 - Box Bottom/Box Bottom_Detent Clip_x2.3mf

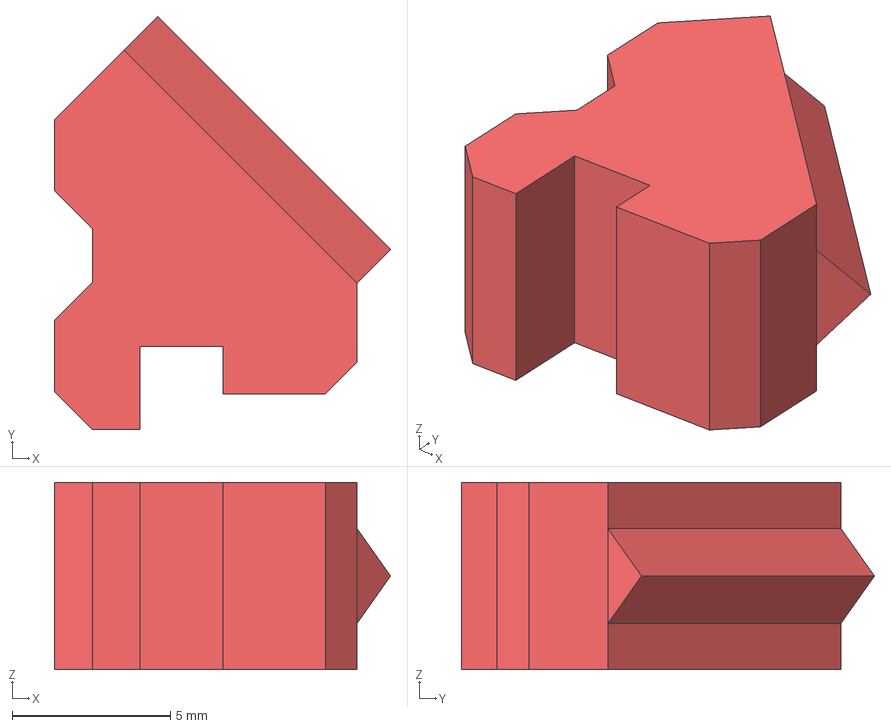
[picture p92: CAD file, 2023-05-22]
Print Files/Current/05 - Box Bottom/Box Bottom_Detent Clip_x2.3mf
10.6 x 13.0 x 5.92 mm
