ImArchimedes/WilsonThrust510/Print Files/Current/06 - Detents/Detents_Aft Burner_Bump_x2.3mf

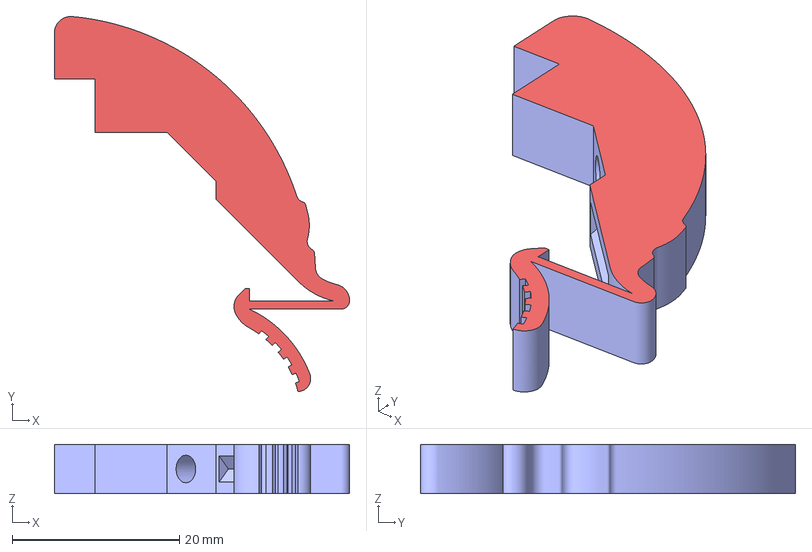
[picture p93: CAD file, 2023-05-22]
Print Files/Current/06 - Detents/Detents_Aft Burner_Bump_x2.3mf
35.4 x 44.9 x 5.92 mm
