ImArchimedes/WilsonThrust510/Print Files/Current/05 - Box Bottom/Box Bottom_USB Wire Cover_x2.3mf

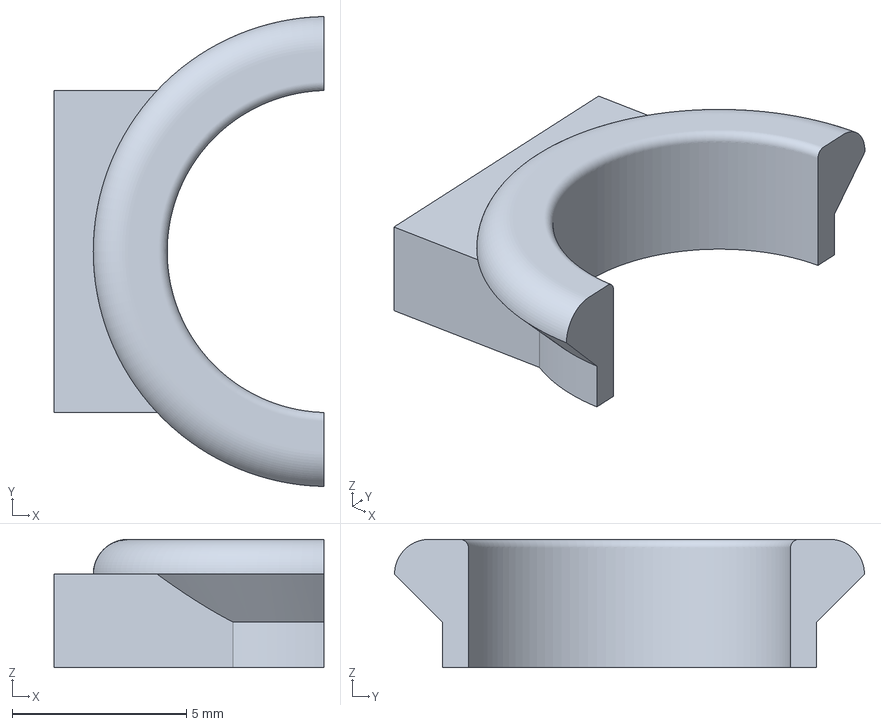
[picture p95: CAD file, 2023-05-22]
Print Files/Current/05 - Box Bottom/Box Bottom_USB Wire Cover_x2.3mf
7.75 x 13.5 x 3.69 mm
