ImArchimedes/WilsonThrust510/(list of files, cad)

Other CAD files:
Print Files/Current/01 - Main Throttle/Grip/Input Caps/Resin/HatEnc/Main Throttle_Grip_Input Caps_Resin_HatEnc_Gripping Stepped Dome.3mf
Print Files/Current/01 - Main Throttle/Grip/Parts/Hat Gates/Main Throttle_Grip_Parts_Hat Gate_4way Gate_x3.3mf
Print Files/Current/01 - Main Throttle/Arm/Main Throttle_Arm_Detent Paddle_Arm Left.3mf
Print Files/Current/06 - Detents/Detents_Aft Burner_Double Lock x2.3mf
Print Files/Current/06 - Detents/Detents_Cosmo Sim_Locking_x2.3mf
Print Files/Current/06 - Detents/Detents_Aft Burner_PreLock_x2.3mf
PCB Files/RKJXM1 Eagle Files/RKJXM1 PCB v14.f3d
PCB Files/RKJXT1 Eagle Files/RKJXT1 PCB v6.f3d
Print Files/Current/01 - Main Throttle/Grip/Parts/Button Screw Covers/Main Throttle_Grip_Parts_Bt Screw Cover_Thm1.3mf
Print Files/Current/01 - Main Throttle/Grip/Parts/Button Screw Covers/Main Throttle_Grip_Parts_Bt Screw Cover_Thm2.3mf
Print Files/Current/01 - Main Throttle/Grip/Parts/Button Screw Covers/Main Throttle_Grip_Parts_Bt Screw Cover_Thm3.3mf
Print Files/Old/01/125_Detent Strength Mag Spinner.3mf
Print Files/Old/01/250_Detent Strength Mag Spinner.3mf
Print Files/Old/01/3-Way Hat CH Trim.3mf
Print Files/Old/01/5-way Encoder Combo Trim Hat.3mf
Print Files/Old/01/5-way Hat Cap Edgee Dome.3mf
Print Files/Old/01/5-way Hat Cap Round Pyramid.3mf
Print Files/Old/01/5-way Hat Cap Textured Wall Dome.3mf
Print Files/Old/01/5-way Hat Switch Mount.3mf
Print Files/Old/01/Analog Stick Cap.3mf
Print Files/Old/01/Analog Stick Mount.3mf
Print Files/Old/01/Box Bottom.3mf
Print Files/Old/01/Box Selector Mount.3mf
Print Files/Old/01/Box Top.3mf
Print Files/Old/01/Hat Switch Stem Brace Fingers.3mf
Print Files/Old/01/Hat Switch Stem Brace Thumb.3mf
Print Files/Old/01/Kailh Switch Cap Tall.3mf
Print Files/Old/01/Kailh Switch Double Mount.3mf
Print Files/Old/01/Kailh Switch Short.3mf
Print Files/Old/01/Main Throttle Arm.3mf
Print Files/Old/01/Main Throttle Detent Grip.3mf
Print Files/Old/01/Main Throttle Detent Mag Mover.3mf
Print Files/Old/01/Main Throttle Detent Mag Strength Grip.3mf
Print Files/Old/01/Main Throttle Detent Mag Strength Spinner.3mf
Print Files/Old/01/Main Throttle Detent Threaded Mag Holder.3mf
Print Files/Old/01/Main Throttle Friction Grip.3mf
Print Files/Old/01/Main Throttle Friction Post.3mf
Print Files/Old/01/Main Throttle Grip Shell Bottom.3mf
Print Files/Old/01/Main Throttle Grip Shell Left.3mf
Print Files/Old/01/Main Throttle Grip Shell Main Left.3mf
Print Files/Old/01/Main Throttle Grip Shell Main Right.3mf
Print Files/Old/01/Main Throttle Grip Shell Right.3mf
Print Files/Old/01/Pinky 3-Way Hat Mount.3mf
Print Files/Old/01/Ring Scroll Axil Adapter.3mf
Print Files/Old/01/Ring Scroll Button Bumper.3mf
Print Files/Old/01/Ring Scroll Mount.3mf
Print Files/Old/01/Ring Scroll Toothbpick.3mf
Print Files/Old/01/Side Throttle Arm.3mf
Print Files/Old/01/Side Throttle Friction Grip.3mf
Print Files/Old/01/Side Throttle Friction Post Stopper.3mf
Print Files/Old/01/Side Throttle Friction Post.3mf
Print Files/Old/01/Side Throttle Grip.3mf
Print Files/Old/01/Slider Cap.3mf
Print Files/Old/01/Slider Mount.3mf
Print Files/Old/02/3-Way Trimmed CH Hat.3mf
Print Files/Old/02/5-way Edge Dome Hat 90 Resin.stl
Print Files/Old/02/5-way Edge Dome Hat Resin.stl
Print Files/Old/02/5-way Edge Dome Hat.stl
Print Files/Old/02/Aft Burn Bump Left.3mf
Print Files/Old/02/Aft Burn Bump Left.stl
Print Files/Old/02/Aft Burn Bump Right.3mf
Print Files/Old/02/Aft Burn Bump Right.stl
Print Files/Old/02/Aft Burn Double Lock Left.3mf
Print Files/Old/02/Aft Burn Double Lock Left.stl
Print Files/Old/02/Aft Burn Double Lock Right.3mf
Print Files/Old/02/Aft Burn Double Lock Right.stl
Print Files/Old/02/Aft Burn Single Lck Left.3mf
Print Files/Old/02/Aft Burn Single Lck Left.stl
Print Files/Old/02/Aft Burn Single Lck Right.3mf
Print Files/Old/02/Aft Burn Single Lck Right.stl
Print Files/Old/02/Box Top Shell.3mf
Print Files/Old/02/Cosmo Sim Left.3mf
Print Files/Old/02/Cosmo Sim Left.stl
Print Files/Old/02/Cosmo Sim Locking Left.3mf
Print Files/Old/02/Cosmo Sim Locking Left.stl
Print Files/Old/02/Cosmo Sim Locking Right.3mf
Print Files/Old/02/Cosmo Sim Locking Right.stl
Print Files/Old/02/Cosmo Sim Right.3mf
Print Files/Old/02/Cosmo Sim Right.stl
Print Files/Old/02/Detent Paddle Arm Left.3mf
Print Files/Old/02/Detent Paddle Arm Left.stl
Print Files/Old/02/Detent Paddle Arm Right.3mf
Print Files/Old/02/Detent Paddle Arm Right.stl
Print Files/Old/02/Detent Stopper Spacer Left.3mf
Print Files/Old/02/Detent Stopper Spacer Left.stl
Print Files/Old/02/Detent Stopper Spacer Right.3mf
Print Files/Old/02/Detent Stopper Spacer Right.stl
Print Files/Old/02/Joystick Cap New.3mf
Print Files/Old/02/Joystick Cap.3mf
Print Files/Old/02/Kailh Plunger Cap Mid Dimple.3mf
Print Files/Old/02/Kailh Plunger Cap Mid.3mf
Print Files/Old/02/Kailh Plunger Cap Mid.stl
Print Files/Old/02/Kailh Plunger Cap Top Dimple.3mf
Print Files/Old/02/Kailh Plunger Cap Top.3mf
Print Files/Old/02/Kailh Plunger Cap Top.stl
Print Files/Old/02/Kailh Plunger Pinky Dimple.3mf
Print Files/Old/02/Kailh Plunger Pinky.3mf
Print Files/Old/02/Kailh Plunger Pinky.stl
Print Files/Old/02/Kailh Plunger Under Dimple.3mf
Print Files/Old/02/Kailh Plunger Under.3mf
Print Files/Old/02/Kailh Plunger Under.stl
Print Files/Old/02/Main Throttle Friction Grip.3mf
Print Files/Old/02/Main Throttle Post.3mf
Print Files/Old/02/Main Throttle Stopper.3mf
Print Files/Old/02/Main Throttle Stopper.stl
Print Files/Old/02/Side Throttle Fric Grip.3mf
Print Files/Old/02/Side Throttle Post.3mf
Print Files/Old/02/Side Throttle Stopper.3mf
Print Files/Old/02/Side Throttle Stopper.stl
Print Files/Old/02/Slider Cap.stl
Print Files/Old/02/Small Throttle Axle Bearing Inside.3mf
Print Files/Old/02/Small Throttle Axle Bearing Inside.stl
Print Files/Old/02/Small Throttle Axle Bearing Outside.3mf
Print Files/Old/02/Small Throttle Axle Bearing Outside.stl
Print Files/Old/02/Square Stem Brace.3mf
Print Files/Old/02/Textured Walled Dome Hat.stl
Print Files/Old/02/Virpil Round Pyramid Resin.3mf
Print Files/Old/02/Virpil Round Pyramid.3mf
Print Files/Old/02/Virpil Square Pyramid.3mf
Print Files/Old/02/Walled Dome Resin 90.stl
Print Files/Old/02/Walled Dome Resin.stl
Print Files/Old/03/Arm/Arm Shell.3mf
Print Files/Old/03/Box Shells/Box Bottom Shell.3mf
Print Files/Old/03/Box Shells/Box Top Shell.3mf
Print Files/Old/03/Box Shells/Wire Port Insert L.3mf
Print Files/Old/03/Box Shells/Wire Port Insert R.3mf
Print Files/Old/03/Detent Parts/Aft Burn Bump Left.3mf
Print Files/Old/03/Detent Parts/Aft Burn Bump Right.3mf
Print Files/Old/03/Detent Parts/Aft Burn Double Lock Left.3mf
Print Files/Old/03/Detent Parts/Aft Burn Double Lock Right.3mf
Print Files/Old/03/Detent Parts/Aft Burn Single Lck Left.3mf
Print Files/Old/03/Detent Parts/Aft Burn Single Lck Right.3mf
Print Files/Old/03/Detent Parts/Blank Left.3mf
Print Files/Old/03/Detent Parts/Blank Right.3mf
Print Files/Old/03/Detent Parts/Cosmo Sim Left.3mf
Print Files/Old/03/Detent Parts/Cosmo Sim Locking Left.3mf
Print Files/Old/03/Detent Parts/Cosmo Sim Locking Right.3mf
Print Files/Old/03/Detent Parts/Cosmo Sim Right.3mf
Print Files/Old/03/Detent Parts/Detent Paddle Grip.3mf
Print Files/Old/03/Detent Parts/Paddle Arm Left.3mf
Print Files/Old/03/Detent Parts/Paddle Arm Right.3mf
Print Files/Old/03/Friction Adjuster Main Throttle/MT Frc Grip.3mf
Print Files/Old/03/Friction Adjuster Main Throttle/MT Frc Post.3mf
Print Files/Old/03/Friction Adjuster Main Throttle/MT Frc Stopper.3mf
Print Files/Old/03/Friction Adjuster Side Throttle/ST Frc Grip.3mf
Print Files/Old/03/Friction Adjuster Side Throttle/ST Frc Post.3mf
Print Files/Old/03/Friction Adjuster Side Throttle/ST Frc Stopper.3mf
Print Files/Old/03/Grip Shells/Grip Big End Shell.3mf
Print Files/Old/03/Grip Shells/Grip Front Block Shell.3mf
Print Files/Old/03/Grip Shells/Grip Main Body (Leather).3mf
Print Files/Old/03/Grip Shells/Grip Small End.3mf
Print Files/Old/03/Hats and Caps (FDM)/3-Way Trimmed CH FDM.3mf
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
