ImArchimedes/WilsonThrust510/Print Files/Current/A4 Leather Cutout.pdf

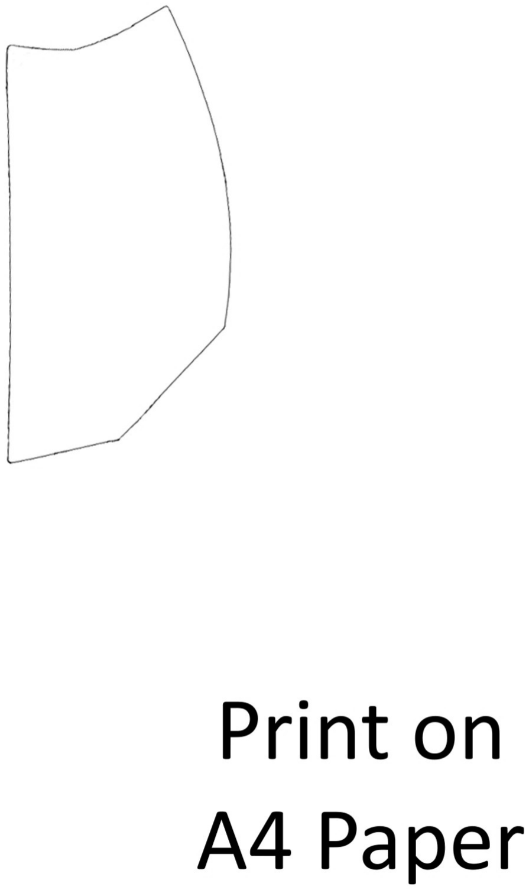
[picture p96: page 1]
