ImArchimedes/WilsonThrust510/Documentation/Other Helpful Docs/Doc Images/Print Orientation Thumbs/Box Bottom_Detent Clip_x2.jpg

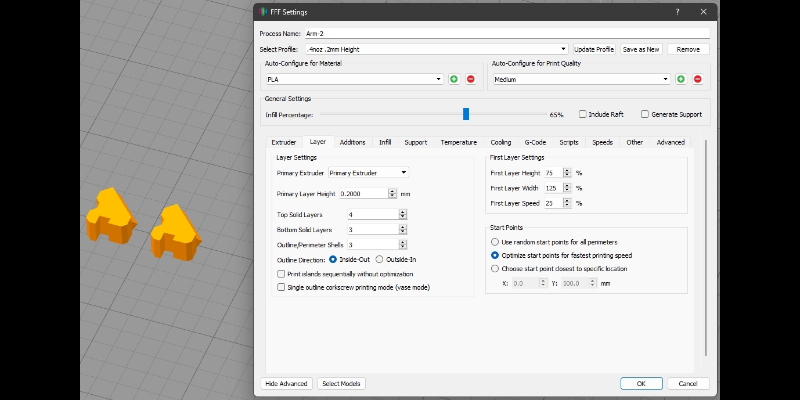
Documentation/Other Helpful Docs/Doc Images/Print Orientation Thumbs/Box Bottom_Detent Clip_x2.jpg
