ImArchimedes/WilsonThrust510/Documentation/Other Helpful Docs/Doc Images/Print Orientation Thumbs/Box Bottom_Panic Button_Mount.jpg

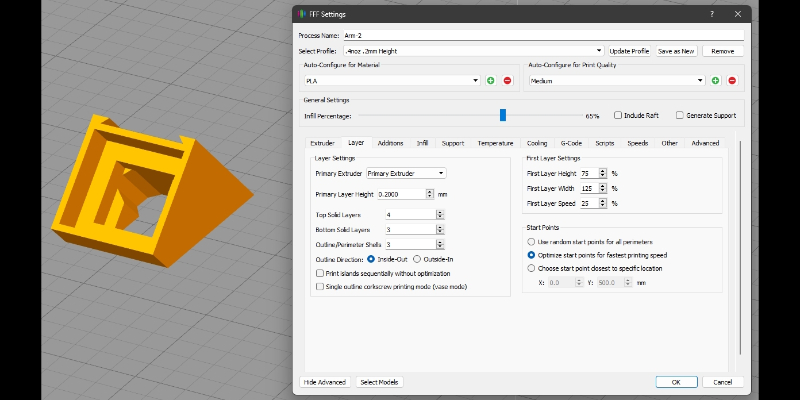
Documentation/Other Helpful Docs/Doc Images/Print Orientation Thumbs/Box Bottom_Panic Button_Mount.jpg
