ImArchimedes/WilsonThrust510/Documentation/Other Helpful Docs/Doc Images/Print Orientation Thumbs/Box Top_Box Top.jpg

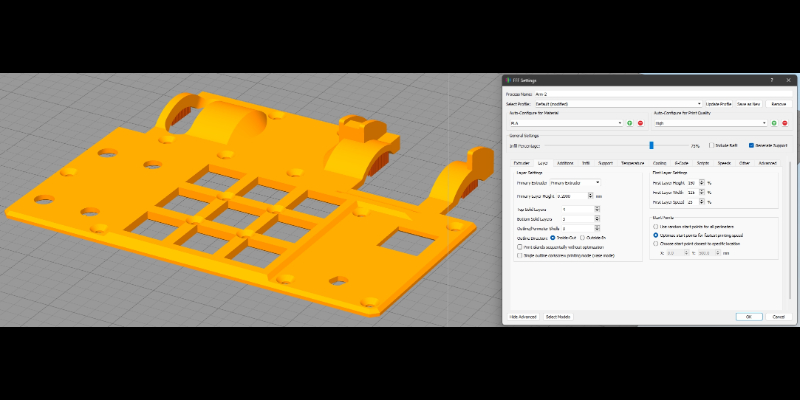
Documentation/Other Helpful Docs/Doc Images/Print Orientation Thumbs/Box Top_Box Top.jpg
