ImArchimedes/WilsonThrust510/Documentation/Other Helpful Docs/Doc Images/Print Orientation Thumbs/Box Top_Button Grid_Holder.jpg

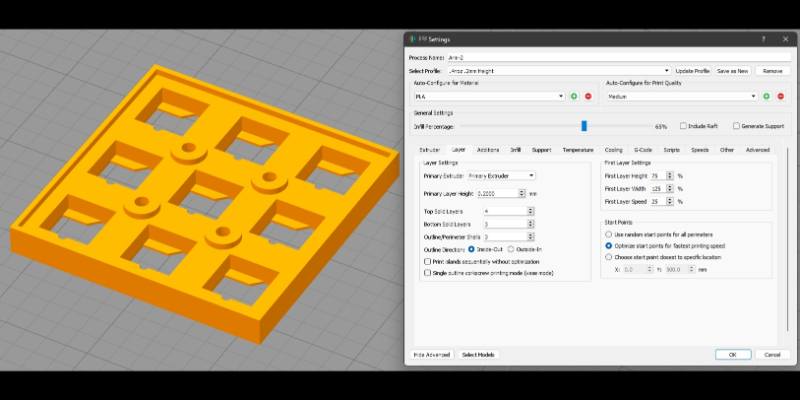
Documentation/Other Helpful Docs/Doc Images/Print Orientation Thumbs/Box Top_Button Grid_Holder.jpg
