ImArchimedes/WilsonThrust510/Documentation/Other Helpful Docs/Doc Images/Print Orientation Thumbs/Detents_Aft Burner_Bump_x2.jpg

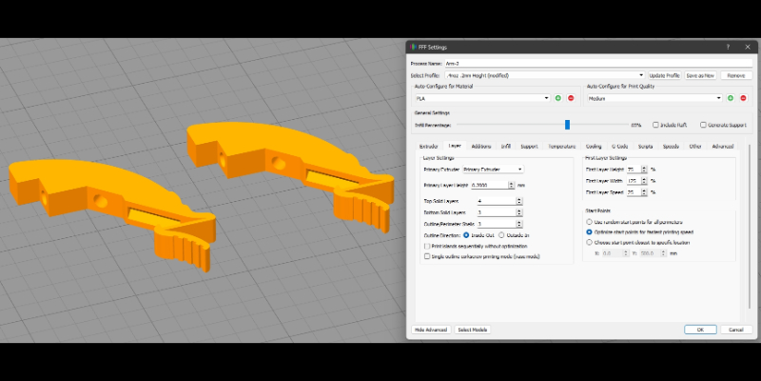
Documentation/Other Helpful Docs/Doc Images/Print Orientation Thumbs/Detents_Aft Burner_Bump_x2.jpg
