ImArchimedes/WilsonThrust510/Documentation/Other Helpful Docs/Doc Images/Print Orientation Thumbs/Detents_Aft Burner_Double Lock x2.jpg

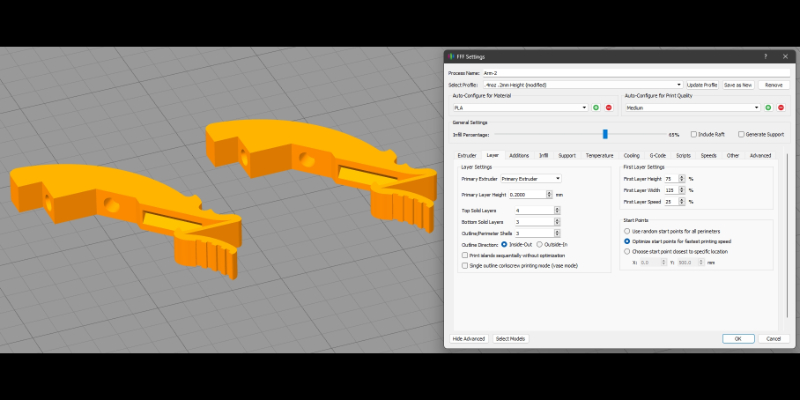
Documentation/Other Helpful Docs/Doc Images/Print Orientation Thumbs/Detents_Aft Burner_Double Lock x2.jpg
