ImArchimedes/WilsonThrust510/Documentation/Other Helpful Docs/Doc Images/Print Orientation Thumbs/Detents_Cosmo Sim_Bump_x2.jpg

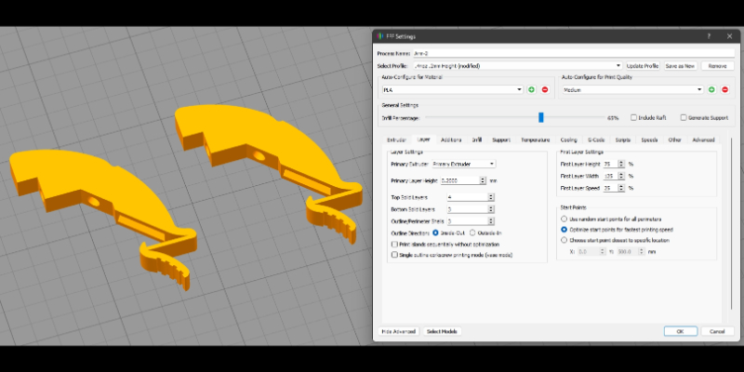
Documentation/Other Helpful Docs/Doc Images/Print Orientation Thumbs/Detents_Cosmo Sim_Bump_x2.jpg
