ImArchimedes/WilsonThrust510/Documentation/Other Helpful Docs/Doc Images/Print Orientation Thumbs/Friction Adjustment_Grip_x2.jpg

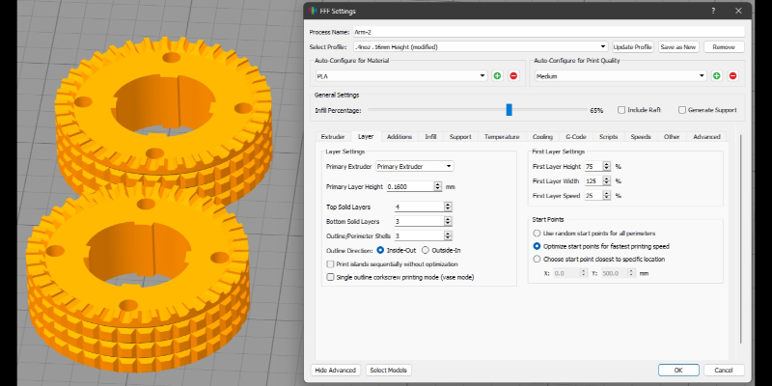
Documentation/Other Helpful Docs/Doc Images/Print Orientation Thumbs/Friction Adjustment_Grip_x2.jpg
