ImArchimedes/WilsonThrust510/Documentation/Other Helpful Docs/Doc Images/Print Orientation Thumbs/Friction Adjustment_Right Main Throttle_Post.jpg

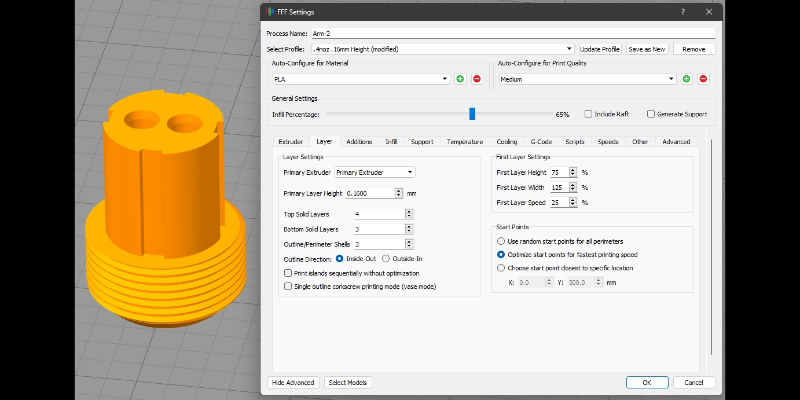
Documentation/Other Helpful Docs/Doc Images/Print Orientation Thumbs/Friction Adjustment_Right Main Throttle_Post.jpg
