ImArchimedes/WilsonThrust510/Documentation/Other Helpful Docs/Doc Images/Print Orientation Thumbs/Main Throttle_Grip_Input Caps_FFF_5way Hat_Round Pyramid.jpg

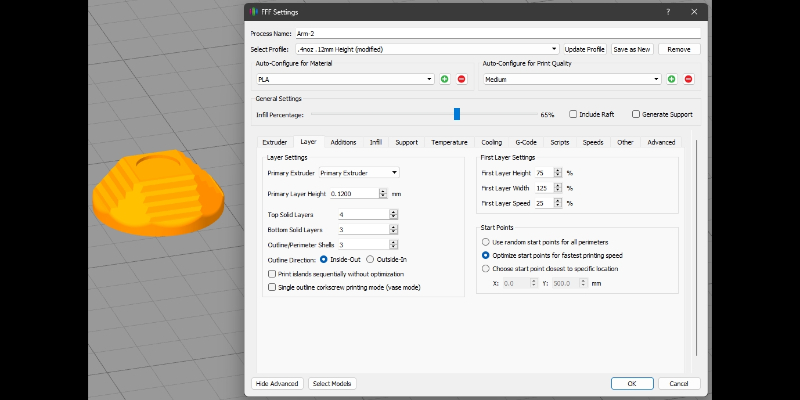
Documentation/Other Helpful Docs/Doc Images/Print Orientation Thumbs/Main Throttle_Grip_Input Caps_FFF_5way Hat_Round Pyramid.jpg
