ImArchimedes/WilsonThrust510/Documentation/Other Helpful Docs/Doc Images/Print Orientation Thumbs/Side Throttle_Axle Locking Grip.jpg

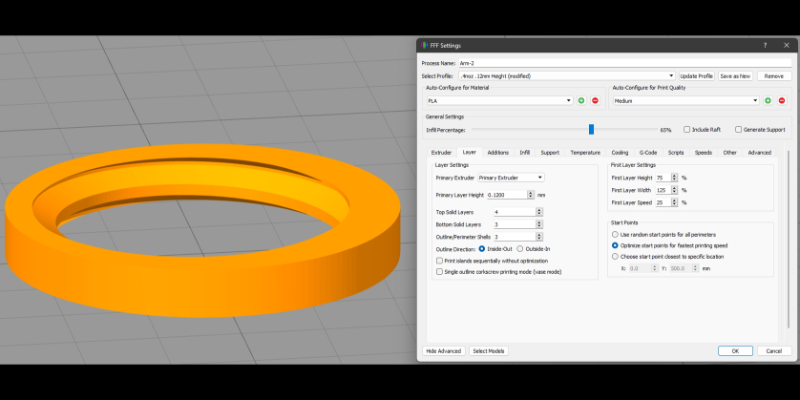
Documentation/Other Helpful Docs/Doc Images/Print Orientation Thumbs/Side Throttle_Axle Locking Grip.jpg
