ImArchimedes/WilsonThrust510/Documentation/Other Helpful Docs/Doc Images/Video Thumbnails/Wilson Thrust Tutorial - I - PCBs - A - Main Controller PCB.jpg

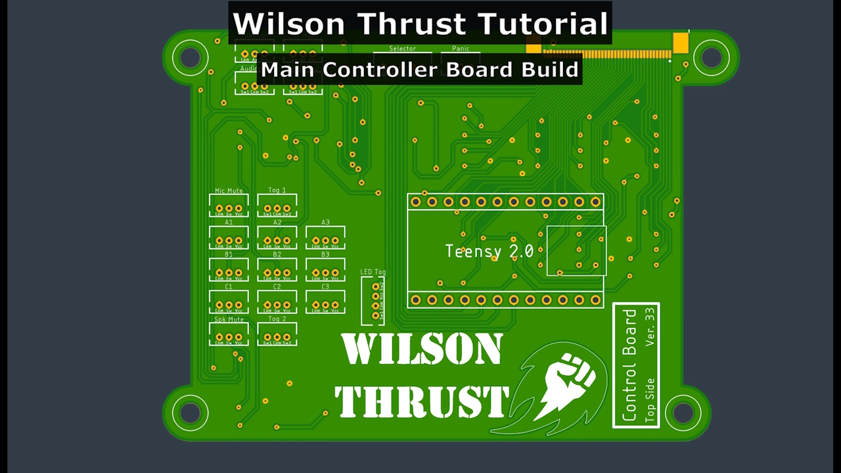
Documentation/Other Helpful Docs/Doc Images/Video Thumbnails/Wilson Thrust Tutorial - I - PCBs - A - Main Controller PCB.jpg
