ImArchimedes/WilsonThrust510/Documentation/Other Helpful Docs/Doc Images/Video Thumbnails/Wilson Thrust Tutorial - I - PCBs - B - Grip Satellite PCB - 01 - Btn LEDs.jpg

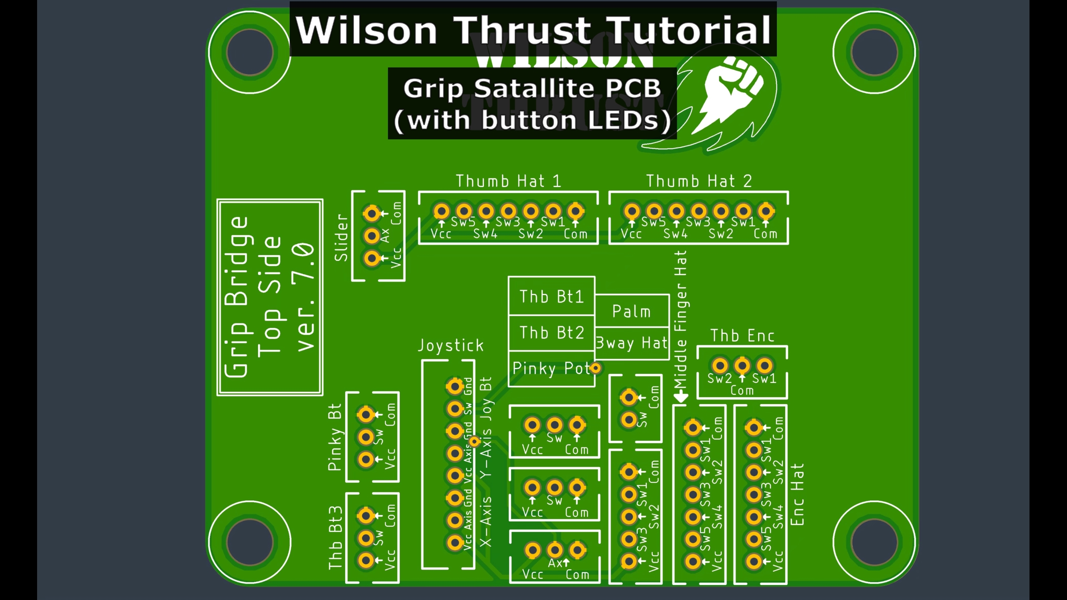
Documentation/Other Helpful Docs/Doc Images/Video Thumbnails/Wilson Thrust Tutorial - I - PCBs - B - Grip Satellite PCB - 01 - Btn LEDs.jpg
