ImArchimedes/WilsonThrust510/Documentation/Other Helpful Docs/Doc Images/Video Thumbnails/Wilson Thrust Tutorial - I - PCBs - C - 5way Hat RKJXM1.jpg

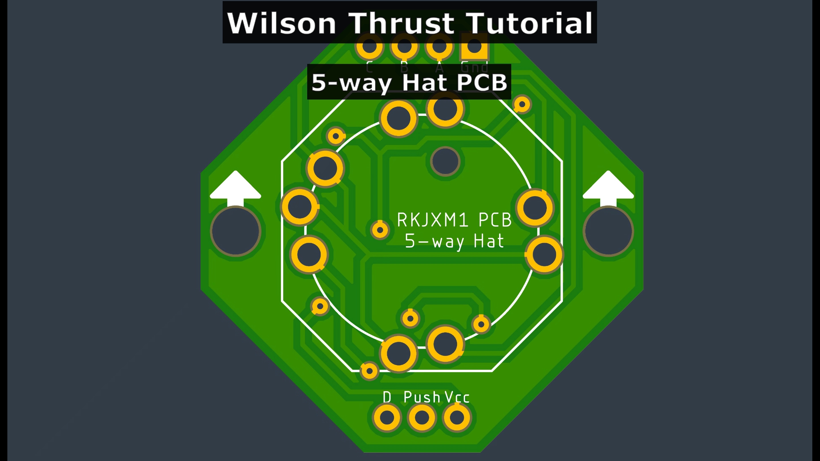
Documentation/Other Helpful Docs/Doc Images/Video Thumbnails/Wilson Thrust Tutorial - I - PCBs - C - 5way Hat RKJXM1.jpg
