ImArchimedes/WilsonThrust510/Documentation/Other Helpful Docs/Doc Images/Video Thumbnails/Wilson Thrust Tutorial - I - PCBs - E - 5way Hat Encoder Combo RKJXT1.jpg

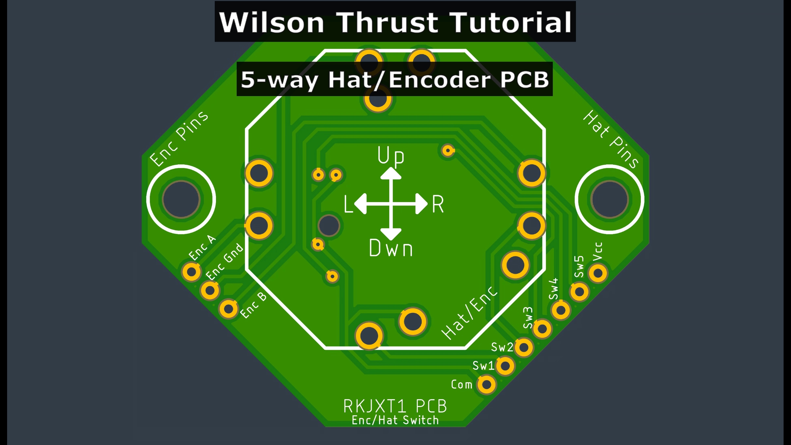
Documentation/Other Helpful Docs/Doc Images/Video Thumbnails/Wilson Thrust Tutorial - I - PCBs - E - 5way Hat Encoder Combo RKJXT1.jpg
