ImArchimedes/WilsonThrust510/Documentation/Other Helpful Docs/Doc Images/Video Thumbnails/Wilson Thrust Tutorial - II - Comp Wire - C - Kailh LED Thumbnail.jpg

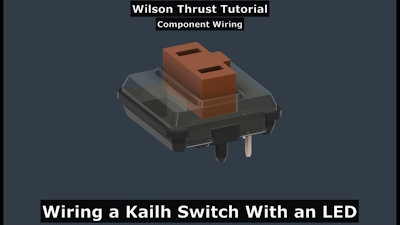
Documentation/Other Helpful Docs/Doc Images/Video Thumbnails/Wilson Thrust Tutorial - II - Comp Wire - C - Kailh LED Thumbnail.jpg
