ImArchimedes/WilsonThrust510/Documentation/Other Helpful Docs/Doc Images/Video Thumbnails/Wilson Thrust Tutorial - III - Assembly - A - Grip - 02 - Sm Side.jpg

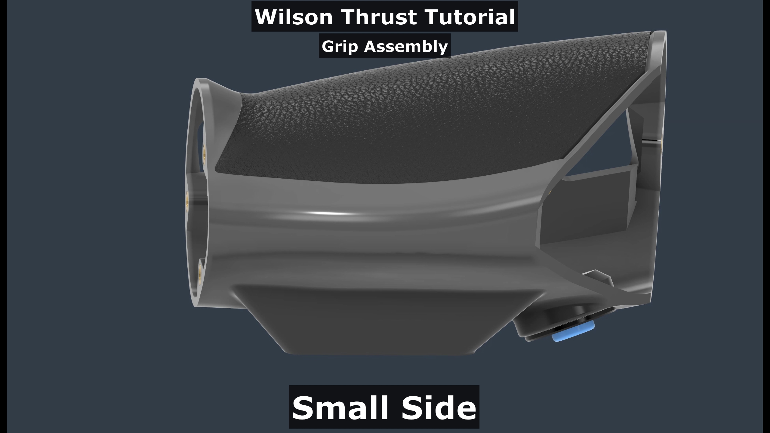
Documentation/Other Helpful Docs/Doc Images/Video Thumbnails/Wilson Thrust Tutorial - III - Assembly - A - Grip - 02 - Sm Side.jpg
