ImArchimedes/WilsonThrust510/PCB Files/RKJXM1 Eagle Files/RKJXM1 Breakout Output Pins v14.brd

## EAGLE design PCB Files/RKJXM1 Eagle Files/RKJXM1 Breakout Output Pins v14.brd (2022-07-08)

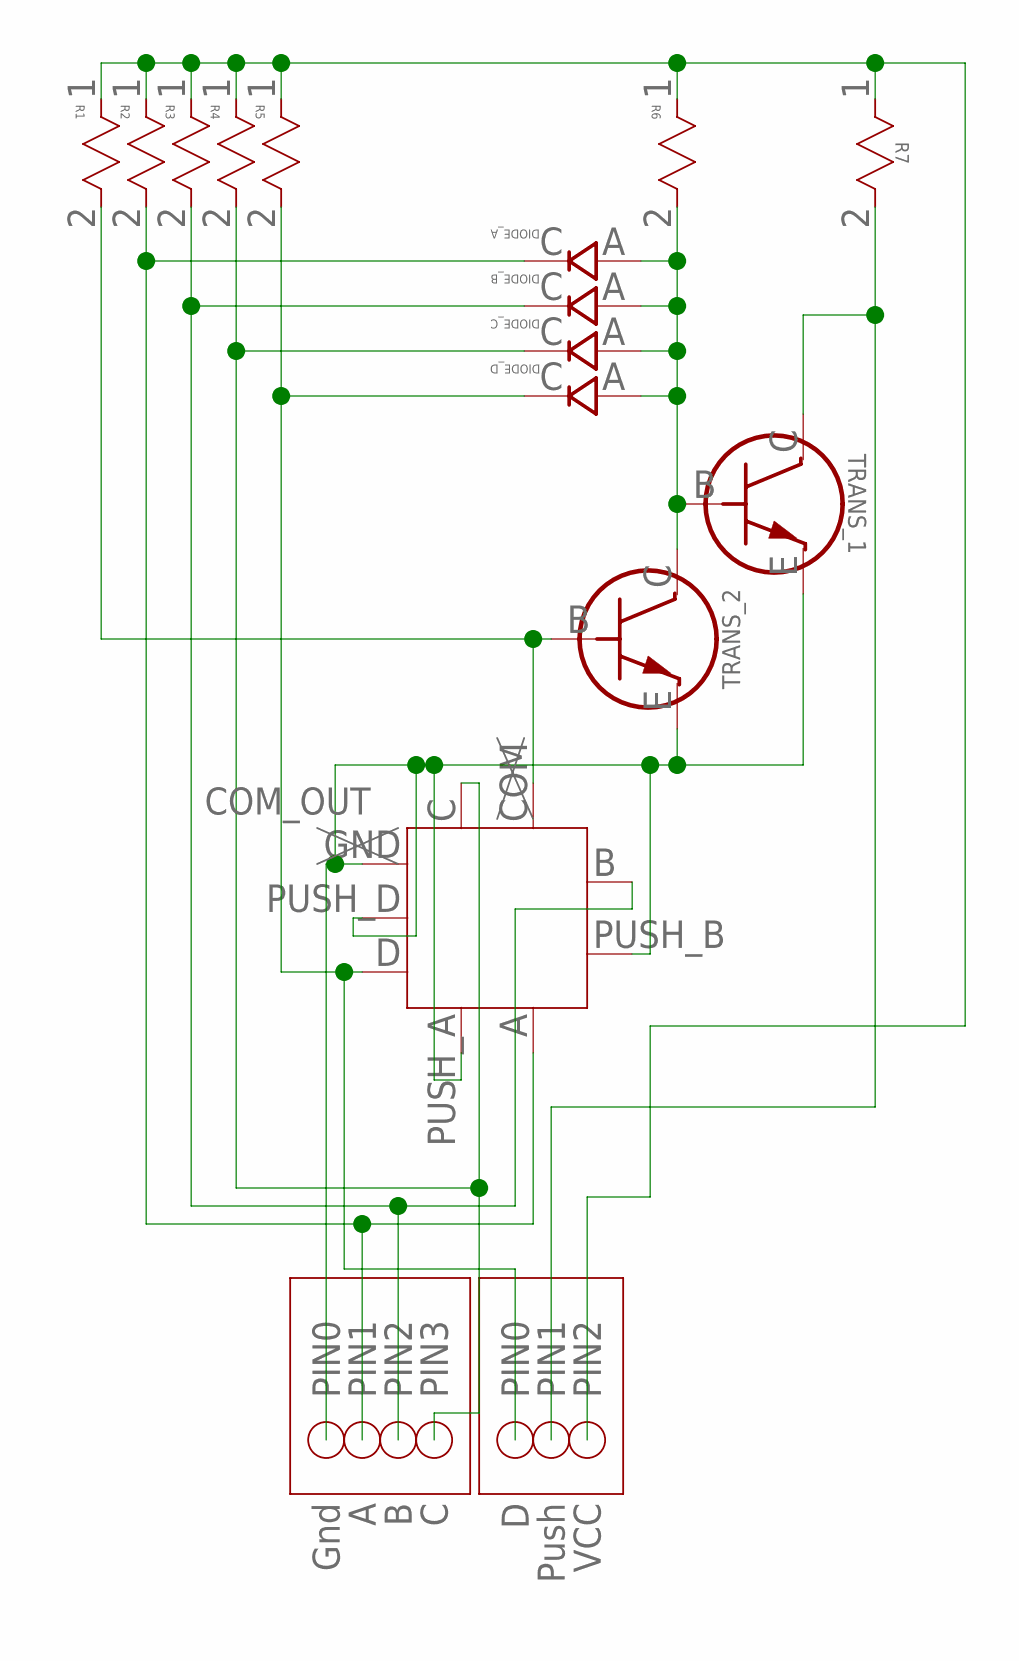
[picture p171: schematic RKJXM1 Breakout Output Pins v14.sch]

Parts:
DIODE_A: DIODE_SCHOTTKY_SMD_USC_TOS
DIODE_B: DIODE_SCHOTTKY_SMD_USC_TOS
DIODE_C: DIODE_SCHOTTKY_SMD_USC_TOS
DIODE_D: DIODE_SCHOTTKY_SMD_USC_TOS
R1, R2, R3, R4, R5, R6, R7: RESISTOR_1K_SMD_RNCP0805FTD1K00STA_RNCP0805_STP-L; STA_RNCP0805_STP-L
RKJXM1_SWITCH: RKJXM1_V3; RKJXM1_FOOT_V3; PART_NAME RKJXM1_Switch
TRANS_1, TRANS_2: TRANS_NPN_SMD_MMBT3904-TPSOT-23_MCC-L; SOT-23_MCC-L
U$3: JST_ZH_4PIN
U$4: JST_ZH_3PIN_NO_GND

Connections:
A_OUT: DIODE_A.C, R2.2, RKJXM1_SWITCH.A, U$3.PIN1
B_OUT: DIODE_B.C, R3.2, RKJXM1_SWITCH.B, U$3.PIN2
C_OUT: DIODE_C.C, R4.2, RKJXM1_SWITCH.C, U$3.PIN3
D_OUT: DIODE_D.C, R5.2, RKJXM1_SWITCH.D, U$4.PIN0
GROUND_OUT: RKJXM1_SWITCH.GND, RKJXM1_SWITCH.PUSH_A, RKJXM1_SWITCH.PUSH_B, RKJXM1_SWITCH.PUSH_D, TRANS_1.E, TRANS_2.E, U$3.PIN0
unnamed: R1.2, RKJXM1_SWITCH.COM, TRANS_2.B
unnamed: DIODE_A.A, DIODE_B.A, DIODE_C.A, DIODE_D.A, R6.2, TRANS_1.B, TRANS_2.C
PUSH_OUT: R7.2, TRANS_1.C, U$4.PIN1
VCC_OUT: R1.1, R2.1, R3.1, R4.1, R5.1, R6.1, R7.1, U$4.PIN2

Notes on the sheet:
COM_OUT
VCC
Push
Gnd

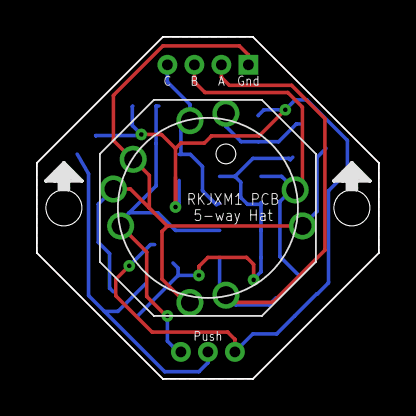
[picture p172: board RKJXM1 Breakout Output Pins v14.brd from above]

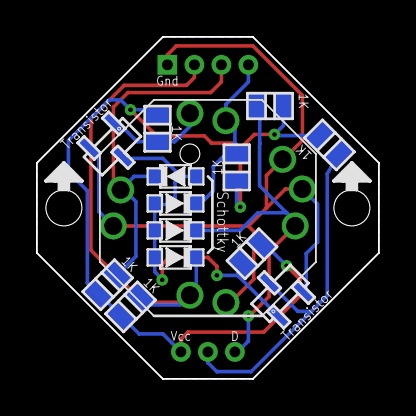
[picture p173: board RKJXM1 Breakout Output Pins v14.brd from below]

Board: 2 copper layers, 19.0 x 19.0 mm, 16 parts (15 on the bottom side), 9 nets.
