ImArchimedes/WilsonThrust510/(commit log)

2021-10-31 Added BOM
    This is the BOM with prices attached
    [Wilson Thrust BOM.xlsx]
2021-10-31 Adding PCB Files
    These are zipped up Gerber/CAM files for ordering PCBs online.
2021-10-31 Adding PCB files
    These are zips of Gerber/CAM files from Eagle and can be used to order the PCBs online.
2021-11-01 Added Print Files
    41 Files added
    [3-Way Hat CH Trim.3mf, 5-way Encoder Combo Trim Hat.3mf, 5-way Hat Cap Edgee Dome.3mf, 5-way Hat Cap Round Pyramid.3mf, 5-way Hat Cap Textured Wall Dome.3mf, 5-way Hat Switch Mount.3mf, Analog Stick Cap.3mf, Analog Stick Mount.3mf]
2021-11-01 Update Main Throttle Arm.3mf
    [Main Throttle Arm.3mf]
2021-11-01 Create Wilson Thrust v87.f3z
2022-04-18 Updated Docs
    Updated Bill of Material v3
    [125_Detent Strength Mag Spinner.3mf, 250_Detent Strength Mag Spinner.3mf, Wilson Thrust BOM v2.xlsx, Wilson Thrust BOM v3.xlsx, Wilson Thrust BOM.xlsx]
2022-04-18 Updated BoMs
    Updated BoM and created a version with and without Grip LEDs.
    [125_Detent Strength Mag Spinner.3mf, 250_Detent Strength Mag Spinner.3mf, 3-Way Hat CH Trim.3mf, 5-way Encoder Combo Trim Hat.3mf, 5-way Hat Cap Edgee Dome.3mf, 5-way Hat Cap Round Pyramid.3mf, 5-way Hat Cap Textured Wall Dome.3mf, 5-way Hat Switch Mount.3mf]
2022-04-18 Updated Printable Parts
    Added latest printable parts for v.121 in both 3mf and Stl formats. Also added Fusion Project file.
    [3-Way Trimmed CH Hat.3mf, 5-way Edge Dome Hat 90 Resin.stl, 5-way Edge Dome Hat Resin.stl, 5-way Edge Dome Hat.stl, Aft Burn Bump Left.3mf, Aft Burn Bump Left.stl, Aft Burn Bump Right.3mf, Aft Burn Bump Right.stl]
2022-04-19 Documentation Printed Parts
    Took all screenshots and created the first guide document, Wilson Thrust Printed Parts Guide. This walks user through printing all parts and adding inserts, UHMW tape, leather, and ferrous wire to them.
    [Wilson Thrust BOM v3 Grip LEDs.xlsx]
2022-06-27 Updated gates, hats, and contactless sensors
    - Hat Gates filleted from .25 to .5mm
    - Hat Stem corners filleted from .25 to .5mm
    - Thumb Button 2 threaded cover height increased by .5mm.
    - All resin push buttons on grip designed for LEDs
    - Swapped potentiometers for side and main throttles for AS5600 contactless sensors.
    - Palm button under leather now round.
    [125_Detent Strength Mag Spinner.3mf, 250_Detent Strength Mag Spinner.3mf, 3-Way Hat CH Trim.3mf, 3-Way Trimmed CH Hat.3mf, 3-Way Trimmed CH Resin.3mf, 5-way Edge Dome Hat 90 Resin.3mf, 5-way Edge Dome Hat 90 Resin.stl, 5-way Edge Dome Hat Resin.stl]
2022-06-30 New Docs
    Version for of the BOM Created with a full overhaul
    [Specifications Scratch Pad.xlsx, Wilson Thrust BOM v4 Grip LEDs.xlsx, Wilson Thrust BOM v4 No Grip LEDs.xlsx]
2022-06-30 Failed Commit Fixes
    [Wilson Thrust BOM v3 Grip LEDs.xlsx, Wilson Thrust BOM v3 No Grip LEDs.xlsx]
2022-06-30 failed commit fix 2
    [Wilson Thrust BOM v4 Grip LEDs.xlsx]
2022-06-30 commit fix 3
    [Wilson Thrust BOM v3 Grip LEDs.xlsx, Wilson Thrust BOM v3 No Grip LEDs.xlsx]
2022-06-30 Finalized BOM v4 LED
    Finalized BOM v4 with LEDS by:
    - Fixing links
    - Updating costs
    - Overhauling formatting
    [Specifications Scratch Pad.xlsx, Wilson Thrust BOM v4 Grip LEDs.xlsx, Wilson Thrust BOM v4 with Grip LEDs.xlsx]
2022-07-05 Cheaper BOM and BOM Update
    Created Cheaper BOM doc and updated BOM for Grip LEDs with suggestions made by 0nn0.
    [Bearing Spacer.3mf, Wilson Thrust BOM v4 Cheaper with Grip LEDs.xlsx, Wilson Thrust BOM v4 with Grip LEDs.xlsx]
2022-07-07 PCB Files updated and Docs folder reorganized.
    [Specifications Scratch Pad -2.xlsx, Specifications Scratch Pad.xlsx, Wilson Thrust BOM v2.xlsx, Wilson Thrust BOM v3 Grip LEDs.xlsx, Wilson Thrust BOM v3 No Grip LEDs.xlsx, Wilson Thrust BOM v4 Cheaper with Grip LEDs.xlsx, Wilson Thrust BOM v4 No Grip LEDs.xlsx, Wilson Thrust BOM v4 with Grip LEDs.xlsx]
2022-07-08 Added PCB Files
    [RKJXM1 Breakout Output Pins v14.brd, RKJXM1 Breakout Output Pins v14.sch, RKJXM1 PCB v14.f3d, RKJXT1 Board v6.brd, RKJXT1 Board v6.sch, RKJXT1 PCB v6.f3d]
2023-03-23 Moved videos and added Hat BOMs
    Moved Tutorial videos and added BOMs for hat switches
    [RKJXM1 Bill of Materials.xlsx, RKJXT1 Bill of Materials.xlsx, Wilson Thrust BOM v4 Cheaper with Grip LEDs.xlsx, Wilson Thrust BOM v4 with Grip LEDs.xlsx]
2023-03-23 BOM Fix
    Trying to get xlsx to show
    [RKJXM1 Bill of Materials - Final.xlsx, RKJXT1 Bill of Materials - Final.xlsx]
2023-05-22 Folder Structure and Doc Prep
    Added orientation pics
    Added new print parts
    Cleaned up folders
    Prepping to create Wiki
    [3-Way Trimmed CH FDM.3mf, 3-Way Trimmed CH Resin.3mf, 5-way Edge Dome Hat 90 FDM.3mf, 5-way Edge Dome Hat 90 Resin.3mf, 5-way Edge Dome Hat Resin.3mf, Aft Burn Bump Left.3mf, Aft Burn Bump Right.3mf, Aft Burn Double Lock Left.3mf]
2023-05-23 Thumbnails added
    Added video thumbnails and moved print orientation images
2023-05-23 adding renders
    [Main Throttle_Grip_Input Caps_FFF_3way Hat_Trim.3mf, Main Throttle_Grip_Input Caps_FFF_5way Hat_Edge Dome.3mf, Main Throttle_Grip_Input Caps_FFF_5way Hat_Pyramid Square.3mf, Main Throttle_Grip_Input Caps_FFF_5way Hat_Round Pyramid.3mf, Main Throttle_Grip_Input Caps_FFF_5way Hat_Walled Dome.3mf, Main Throttle_Grip_Input Caps_FFF_HatEnc_Gripping Stepped Dome.3mf, Main Throttle_Grip_Input Caps_FFF_K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]
2023-05-23 Create Wilson Thrust Tutorial - II - Comp Wire - C - Kailh LED Thumbnail.jpg
2023-05-24 BOM Updates
    [Specifications Scratch Pad -2.xlsx, Specifications Scratch Pad.xlsx, Wilson Thrust BOM v2.xlsx, Wilson Thrust BOM v3 Grip LEDs.xlsx, Wilson Thrust BOM v3 No Grip LEDs.xlsx, Wilson Thrust BOM v4 Cheaper with Grip LEDs.xlsx, Wilson Thrust BOM v4 with Grip LEDs.xlsx, Wilson Thrust BOM.xlsx]
2023-06-06 Organizing Print Files
    [125_Detent Strength Mag Spinner.3mf, 250_Detent Strength Mag Spinner.3mf, 3-Way Hat CH Trim.3mf, 3-Way Trimmed CH FDM.3mf, 3-Way Trimmed CH Hat.3mf, 3-Way Trimmed CH Resin.3mf, 5-way Edge Dome Hat 90 FDM.3mf, 5-way Edge Dome Hat 90 Resin.3mf]
2023-07-05 Create Main Throttle_Grip_Input Caps_Resin_5way Hat_Edged Dome.3mf
    Added Edged Dome
    [Main Throttle_Grip_Input Caps_Resin_5way Hat_Edged Dome.3mf]
2023-07-28 Fixed Box Bottom Shell
    [Box Bottom_Box Bottom.3mf]
2023-07-28 PCB file names updated
2023-07-28 Replace Joystick PCB file.
    I had the old joystick pcb in the main folder and the CK_THB001P zip wasn't even in the folder.
2023-07-28 Grip PCBs Renamed
    Hopefully for the last time.
2023-07-28 Detent renaming
    [Detents_Blank_x2.3mf]
