ImArchimedes/WilsonThrust510/(notices)

Notices in the files:
parts and their libraries:
Created Parts: COPYRIGHT: Copyright (C) 2018 Accelerated Designs. All rights reserved
